OregonStateMarsRover/2011/Software/Interface/UIMockups/VideoFeed/VideoResources/utah1.png

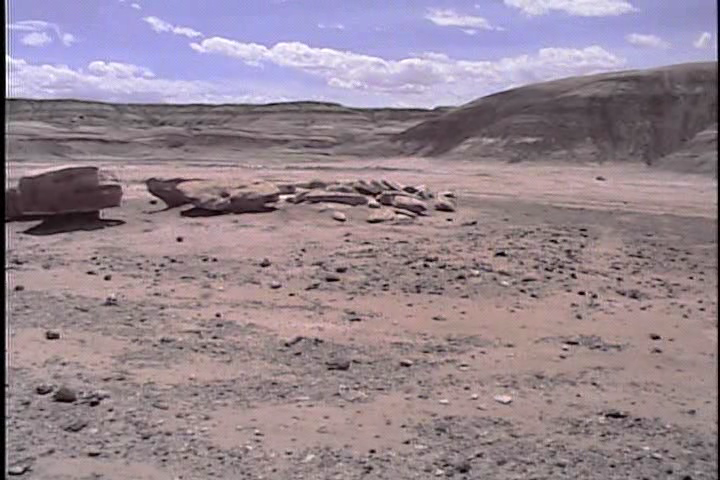
Software/Interface/UIMockups/VideoFeed/VideoResources/utah1.png
