OregonStateMarsRover/2011/Software/Interface/UIMockups/VideoFeed/VideoResources/utah2.png

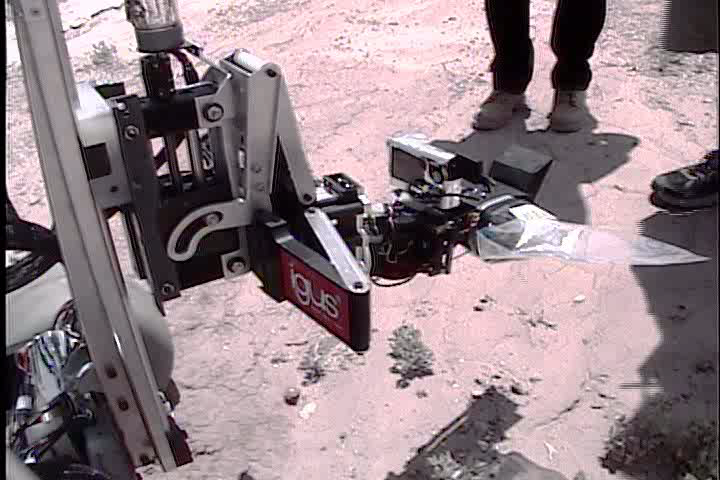
Software/Interface/UIMockups/VideoFeed/VideoResources/utah2.png
