OregonStateMarsRover/2011/README

Say something about I don't know, about robotics, about
