OregonStateMarsRover/2011/Electrical/Changelist.txt

Parts to Update
AOM-6545P-R
ATMEGA65P
BNC_TYCO_5-1634503-3
CAP-0805
CAP-1206
CAP_ALELEC_10
CAP_EPOLYMER_10
DRV135UA
FFC_6200...
HDR_JST_1MM_VERT
IND0805
L7809
LED-0805_DIALIGHT_598-8110-107F
LED-0805_DIALIGHT_598-8150-107F
MCP6241-E/SN
MOSFET_IPD105N04L
PV3ZA
REG104-25
REG104-5
RES-0603
RES-0805
RES-1206
SKY65135-21
SMA-TH-50
TC1121COA
TPS60403
TRIMPOT_PV3ZA
ZLDO1117
