OregonStateMarsRover/2011/Electrical/padsDrawings/R-E-06-01(Tripod_Control_Board)/R-E-06-01_Tripod_Control_Board_Block_Diagram.pdf

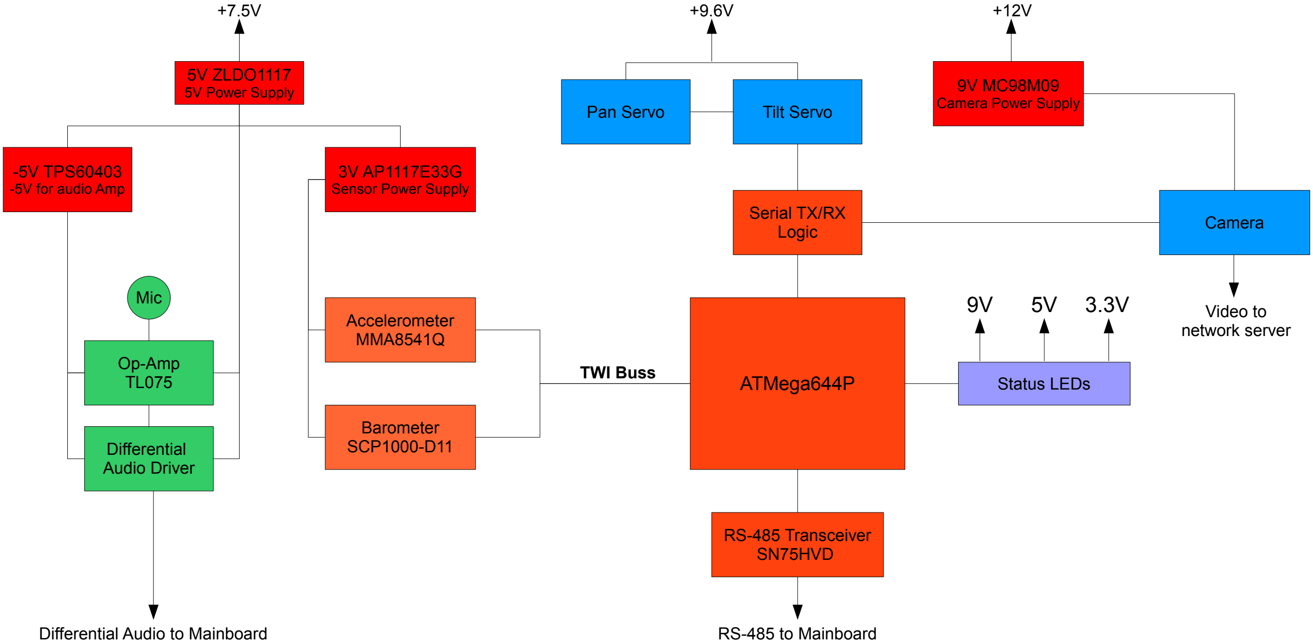
[picture p3: figure]
ATMega644P; 9V MC98M09 Camera Power Supply; 5V ZLDO1117 5V Power Supply; -5V TPS60403 -5V for audio Amp; 3V AP1117E33G Sensor Power Supply; Camera; Op-Amp TL075; Differential Audio Driver; Mic; Accelerometer MMA8541Q; Barometer SCP1000-D11; TWI Buss; Pan Servo; Tilt Servo; Serial TX/RX Logic; Status LEDs; RS-485 Transceiver SN75HVD; Differential Audio to Mainboard; RS-485 to Mainboard; Video to network server
