OregonStateMarsRover/2011/Protocols/Serial Protocol.odt

# Using the Supplied Implementation

An example program is given with a codeblocks project file. Using the serial protocol library is simple, just follow the basic setup used in the main.c file. If multiple interfaces are needed, create an instance of the SerialData structure for each interface. In the example, the transmit function simply passes the data back to the receiving end. In a real example (microcontroller context), the implimentation may resemble the following:

// USART Receive Interrupt

ISR(USART_RX_vect)

{

ProcessDataChar (&ser, UDR0);

}

// USART Transmit Complete Interrupt

ISR(USART_TX_vect)

{

SerialByteTransmitComplete (&ser);

}

Be aware that any assigned function pointers may be called in the context of these interrupts.

# Serial Packet Format

## High level

The user code will see and construct the packet as described below.

Address (one byte)

Length (one byte)

Data (number of bytes in length)

Many pieces of data require more than 8 bits (I.E, are ints and so forth). When breaking up a multi-byte data type for network transmission, it is common practice to do so Most Significant Byte first (MSB first). Breaking up a 32 bit integer would therefore be done as follows:

Data[0] = (value >> 24) & 0xFF;

Data[1] = (value >> 16) & 0xFF;

Data[2] = (value >> 8) & 0xFF;

Data[3] = (value) & 0xFF;

To reconstruct the data back into a 32 bit integer:

Int32 value = (Data[0] << 24) | (Data[1] << 16) | (Data[2] << 8) | Data[3];

Do not do this. This will work with Big Endian processors (AVR32) but not Little Endian processors (8 bit AVR's).

Int32 value = *((Int32*)(&Data[0]));

## Low Level

The actual transmission of the packet will be as described below.

Start Byte

Address, escaped if necessary

Length, escaped if necessary

Data, escaped if necessary

Checksum, escaped if necessary

The checksum is computed as follows:

Checksum = ~(address + length + data[0] + data[1] + … + data[length-1])

Such a checksum computation will be able to detect a single bit error, but multiple bit errors can go unnoticed. The underlying assumption is that bit errors are so rare that over the length of the packet, the chance of two bit errors is negligible.

# Character Escaping

Character escaping (also known as byte stuffing) comes from the need to have one, and only one, start byte in any given data transfer. One solution is to avoid sending a start byte in the data sequence. A better solution is to replace the start byte with an escape character and an escaped version of the start byte before transmitting. I.E, { 0xCA } becomes { '\\', 2 }. In this case, any instance of the escape character '\\' must also be escaped. Additionally, any other characters which should never be transmitted can be escaped. In this case, 0 and 255 are chosen to never be transmitted. The reasoning here is that a transmission error which is not caught by hardware (as a frame error) will most likely result in a 0 or a 255.

Control Characters

START_BYTE 0xCA

ESCAPE_CHAR '\\'

NULL_BYTE 0

MAX_BYTE 255

Control Characters Escaped

START_BYTE_ESCAPED 2

ESCAPE_CHAR_ESCAPED 3

NULL_BYTE_ESCAPED 4

MAX_BYTE_ESCAPED 5
