OregonStateMarsRover/2011/Electrical/padsDrawings/R-E-06-01(Tripod_Control_Board)/R-E-06-01_Tripod_Control_Board_Block_Diagram.png

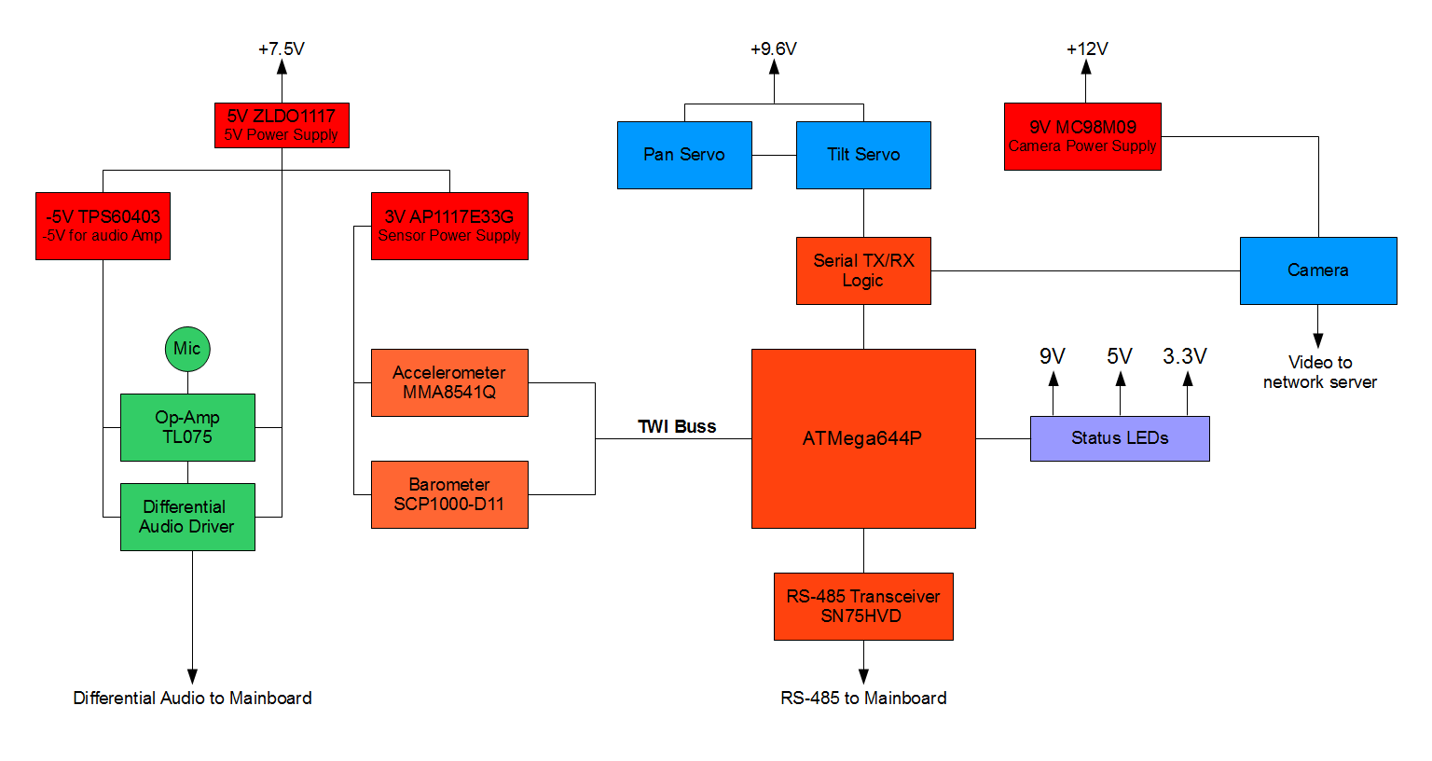
Electrical/padsDrawings/R-E-06-01(Tripod_Control_Board)/R-E-06-01_Tripod_Control_Board_Block_Diagram.png
