OregonStateMarsRover/2011/Electrical/padsDrawings/R-E-04-01(2.4GHz_Amplifier)/BillOfMaterials.rep.txt

Item,Qty,Reference,Part Name
1,1,U10,74LVC2G126DP
2,1,Q1,BC860CW
3,7,C36-38 C41 C44-46,CAP-0402,56pF
4,10,C1-6 C10 C12 C14-15,CAP-0603,0.1uF
5,5,C7-9 C11 C31,CAP-0603,0.47uF
6,6,C32-35 C42-43,CAP-0603,1000pF,5%
7,1,C29,CAP-0603,10uF
8,1,C28,CAP-0603,270pF
9,1,C26,CAP-0603,3.3nF
10,8,C17 C19 C22-25 C27 C30,CAP-0603,8.2pF
11,3,C18 C20-21,CAP-1206,10uF
12,3,C16 C39-40,CAP-1206,4.7uF
13,1,C13,CAP_RAD_5MM,10uF,10%
14,1,U6,CD4081
15,1,J5,HDR_MINIFITJR_2R2P-V
16,1,J4,HDR_SHERLOCK_2P_V
17,1,J3,HDR_SHERLOCK_4P_V
18,1,L1,IND0805,0.1uH
19,4,D3 D6-8,LED-0805_DIALIGHT_598-8150-107F
20,2,D1 D4,LED-0805_DIALIGHT_598-8170-107F
21,2,D5 D9,LED-0805_DIALIGHT_598-8191-107F
22,1,U5,MIC5203
23,5,X1-5,PHOLE-#4
24,1,U4,REG104-5
25,1,U2,REG104-25
26,1,U3,REG104-33
27,1,R46,RES-0402,23.01
28,2,R1 R3,RES-0402,58.63
29,2,R2 R55,RES-0402,OPT
30,1,R40,RES-0603,0
31,1,R18,RES-0603,1.6K
32,2,R11 R43,RES-0603,100
33,6,R9 R21 R48-51,RES-0603,10K
34,1,R10,RES-0603,1M
35,1,R42,RES-0603,260
36,3,R24 R44-45,RES-0603,2K
37,1,R27,RES-0603,320
38,3,R19-20 R22,RES-0603,4.7K
39,1,R7,RES-0603,500K
40,1,R41,RES-0603,51
41,1,R26,RES-0603,600
42,1,R8,RES-0603,7K
43,3,R5-6 R25,RES-0603,OPT
44,11,R4 R23 R32-39 R47,RES-0603,OPT-0
45,2,R12 R17,RES-0603,OPT-1K
46,1,R29,RES-0603,OPT-200
47,1,R30,RES-0603,OPT-270
48,1,R31,RES-0603,OPT-300
49,4,R13-16,RES-0603,OPT-4.7K
50,1,R28,RES-0603,OPT-750
51,1,U1,SKY65135-21
52,3,J1-2 J6,SMA-TH-50
53,1,U8,TL071IDR
54,1,U7,TLV3702
55,7,T1-7,TPNT
56,3,U9 U11 U13,UPG2155TB
57,1,D2,ZENER_BZX84-B8V2,8.2V
