OregonStateMarsRover/2011/Electrical/padsDrawings/R-E-05-01(Main_Board)/Rev. 2/BOM_R-E-05-01_02.xls

Reference | Item | Part Name | Value | Qty | Description | Supplier Link | Unit Cost | Total Cost | Actual Unit Cost | Actual Total
Y200 | 1 | ABL-16.000MHZ-B2,16.000MHz | 16.000MHz | 1 | XTAL, THT, 16.000MHz | https://www.mouser.com/Search/ProductDetail.aspx | $0.39 | $134.79 | $0.39 | $45.52
Y300 | 2 | ABL-16.000MHZ-B2,16.000MHz | 16.000MHz | 1 | XTAL, THT, 16.000MHz | https://www.mouser.com/Search/ProductDetail.aspx | $0.39 |  | $0.39
U300 | 3 | ATXMEGA256A3 |  | 1 | MCU, 8/16b,AVR, ATXMega256A3AU | http://www.mouser.com/ProductDetail/Atmel/ATXMEGA256A3-AU/?qs=iKytVS9glga4b%252bFQlY1sptd856FsMMeE | $10.50 |  | $0.00
U200 | 4 | ATXMEGA256A3 |  | 1 | MCU, 8/16b,AVR, ATXMega256A3AU | http://www.mouser.com/ProductDetail/Atmel/ATXMEGA256A3-AU/?qs=iKytVS9glga4b%252bFQlY1sptd856FsMMeE | $10.50 |  | $0.00
FB300 | 5 | BLM18TG221TNB |  | 1 | Ferrite Bead, 220 Ohm at 100MHz, 0603 | https://www.mouser.com/Search/ProductDetail.aspx | $0.05 |  | $0.05
C201 | 6 | CAP-0603,0.1uF | 0.1uF | 1 | Capacitor, SMT, 0603 | https://www.mouser.com/Search/ProductDetail.aspx | $0.02 |  | $0.02
C202 | 7 | CAP-0603,0.1uF | 0.1uF | 1 | Capacitor, SMT, 0603 | https://www.mouser.com/Search/ProductDetail.aspx | $0.02 |  | $0.02
C203 | 8 | CAP-0603,0.1uF | 0.1uF | 1 | Capacitor, SMT, 0603 | https://www.mouser.com/Search/ProductDetail.aspx | $0.02 |  | $0.02
C204 | 9 | CAP-0603,0.1uF | 0.1uF | 1 | Capacitor, SMT, 0603 | https://www.mouser.com/Search/ProductDetail.aspx | $0.02 |  | $0.02
C205 | 10 | CAP-0603,0.1uF | 0.1uF | 1 | Capacitor, SMT, 0603 | https://www.mouser.com/Search/ProductDetail.aspx | $0.02 |  | $0.02
C207 | 11 | CAP-0603,0.1uF | 0.1uF | 1 | Capacitor, SMT, 0603 | https://www.mouser.com/Search/ProductDetail.aspx | $0.02 |  | $0.02
C208 | 12 | CAP-0603,0.1uF | 0.1uF | 1 | Capacitor, SMT, 0603 | https://www.mouser.com/Search/ProductDetail.aspx | $0.02 |  | $0.02
C301 | 13 | CAP-0603,0.1uF | 0.1uF | 1 | Capacitor, SMT, 0603 | https://www.mouser.com/Search/ProductDetail.aspx | $0.02 |  | $0.02
C302 | 14 | CAP-0603,0.1uF | 0.1uF | 1 | Capacitor, SMT, 0603 | https://www.mouser.com/Search/ProductDetail.aspx | $0.02 |  | $0.02
C303 | 15 | CAP-0603,0.1uF | 0.1uF | 1 | Capacitor, SMT, 0603 | https://www.mouser.com/Search/ProductDetail.aspx | $0.02 |  | $0.02
C304 | 16 | CAP-0603,0.1uF | 0.1uF | 1 | Capacitor, SMT, 0603 | https://www.mouser.com/Search/ProductDetail.aspx | $0.02 |  | $0.02
C305 | 17 | CAP-0603,0.1uF | 0.1uF | 1 | Capacitor, SMT, 0603 | https://www.mouser.com/Search/ProductDetail.aspx | $0.02 |  | $0.02
C306 | 18 | CAP-0603,0.1uF | 0.1uF | 1 | Capacitor, SMT, 0603 | https://www.mouser.com/Search/ProductDetail.aspx | $0.02 |  | $0.02
C308 | 19 | CAP-0603,0.1uF | 0.1uF | 1 | Capacitor, SMT, 0603 | https://www.mouser.com/Search/ProductDetail.aspx | $0.02 |  | $0.02
C313 | 20 | CAP-0603,0.1uF | 0.1uF | 1 | Capacitor, SMT, 0603 | https://www.mouser.com/Search/ProductDetail.aspx | $0.02 |  | $0.02
C315 | 21 | CAP-0603,0.1uF | 0.1uF | 1 | Capacitor, SMT, 0603 | https://www.mouser.com/Search/ProductDetail.aspx | $0.02 |  | $0.02
C316 | 22 | CAP-0603,0.1uF | 0.1uF | 1 | Capacitor, SMT, 0603 | https://www.mouser.com/Search/ProductDetail.aspx | $0.02 |  | $0.02
C400 | 23 | CAP-0603,0.1uF | 0.1uF | 1 | Capacitor, SMT, 0603 | https://www.mouser.com/Search/ProductDetail.aspx | $0.02 |  | $0.02
C401 | 24 | CAP-0603,0.1uF | 0.1uF | 1 | Capacitor, SMT, 0603 | https://www.mouser.com/Search/ProductDetail.aspx | $0.02 |  | $0.02
C402 | 25 | CAP-0603,0.1uF | 0.1uF | 1 | Capacitor, SMT, 0603 | https://www.mouser.com/Search/ProductDetail.aspx | $0.02 |  | $0.02
C403 | 26 | CAP-0603,0.1uF | 0.1uF | 1 | Capacitor, SMT, 0603 | https://www.mouser.com/Search/ProductDetail.aspx | $0.02 |  | $0.02
C404 | 27 | CAP-0603,0.1uF | 0.1uF | 1 | Capacitor, SMT, 0603 | https://www.mouser.com/Search/ProductDetail.aspx | $0.02 |  | $0.02
C405 | 28 | CAP-0603,0.1uF | 0.1uF | 1 | Capacitor, SMT, 0603 | https://www.mouser.com/Search/ProductDetail.aspx | $0.02 |  | $0.02
C406 | 29 | CAP-0603,0.1uF | 0.1uF | 1 | Capacitor, SMT, 0603 | https://www.mouser.com/Search/ProductDetail.aspx | $0.02 |  | $0.02
C701 | 30 | CAP-0603,0.1uF | 0.1uF | 1 | Capacitor, SMT, 0603 | https://www.mouser.com/Search/ProductDetail.aspx | $0.02 |  | $0.02
C710 | 31 | CAP-0603,0.1uF | 0.1uF | 1 | Capacitor, SMT, 0603 | https://www.mouser.com/Search/ProductDetail.aspx | $0.02 |  | $0.02
C102 | 32 | CAP-0603,10nF | 10nF | 1 | Capacitor, SMT, 0603 | https://www.mouser.com/Search/ProductDetail.aspx | $0.03 |  | $0.03
C106 | 33 | CAP-0603,10nF | 10nF | 1 | Capacitor, SMT, 0603 | https://www.mouser.com/Search/ProductDetail.aspx | $0.03 |  | $0.03
C110 | 34 | CAP-0603,10nF | 10nF | 1 | Capacitor, SMT, 0603 | https://www.mouser.com/Search/ProductDetail.aspx | $0.03 |  | $0.03
C700 | 35 | CAP-0603,10nF | 10nF | 1 | Capacitor, SMT, 0603 | https://www.mouser.com/Search/ProductDetail.aspx | $0.03 |  | $0.03
C307 | 36 | CAP-0603,10uF | 10uF | 1 | Capacitor, SMT, 0603 | https://www.mouser.com/Search/ProductDetail.aspx | $0.37 |  | $0.37
C209 | 37 | CAP-0603,18pF | 18pF | 1 | Capacitor, SMT, 0603 | https://www.mouser.com/Search/ProductDetail.aspx | $0.02 |  | $0.02
C210 | 38 | CAP-0603,18pF | 18pF | 1 | Capacitor, SMT, 0603 | https://www.mouser.com/Search/ProductDetail.aspx | $0.02 |  | $0.02
C317 | 39 | CAP-0603,18pF | 18pF | 1 | Capacitor, SMT, 0603 | https://www.mouser.com/Search/ProductDetail.aspx | $0.02 |  | $0.02
C318 | 40 | CAP-0603,18pF | 18pF | 1 | Capacitor, SMT, 0603 | https://www.mouser.com/Search/ProductDetail.aspx | $0.02 |  | $0.02
C107 | 41 | CAP-0603,1nF | 1nF | 1 | Capacitor, SMT, 0603 | https://www.mouser.com/Search/ProductDetail.aspx | $0.03 |  | $0.03
C310 | 42 | CAP-0603,1uF | 1uF | 1 | Capacitor, SMT, 0603 | https://www.mouser.com/Search/ProductDetail.aspx | $0.04 |  | $0.04
C311 | 43 | CAP-0603,1uF | 1uF | 1 | Capacitor, SMT, 0603 | https://www.mouser.com/Search/ProductDetail.aspx | $0.04 |  | $0.04
C312 | 44 | CAP-0603,1uF | 1uF | 1 | Capacitor, SMT, 0603 | https://www.mouser.com/Search/ProductDetail.aspx | $0.04 |  | $0.04
C707 | 45 | CAP-0603,1uF | 1uF | 1 | Capacitor, SMT, 0603 | https://www.mouser.com/Search/ProductDetail.aspx | $0.04 |  | $0.04
C708 | 46 | CAP-0603,1uF | 1uF | 1 | Capacitor, SMT, 0603 | https://www.mouser.com/Search/ProductDetail.aspx | $0.04 |  | $0.04
C709 | 47 | CAP-0603,1uF | 1uF | 1 | Capacitor, SMT, 0603 | https://www.mouser.com/Search/ProductDetail.aspx | $0.04 |  | $0.04
C104 | 48 | CAP-0603,30pF | 30pF | 1 | Capacitor, SMT, 0603 | https://www.mouser.com/Search/ProductDetail.aspx | $0.04 |  | $0.04
C105 | 49 | CAP-0603,39nF | 39nF | 1 | Capacitor, SMT, 0603 | https://www.mouser.com/Search/ProductDetail.aspx | $0.04 |  | $0.04
C703 | 50 | CAP-0603,4.7uF | 4.7uF | 1 | Capacitor, SMT, 0603 | https://www.mouser.com/Search/ProductDetail.aspx | $0.17 |  | $0.17
C704 | 51 | CAP-0603,4.7uF | 4.7uF | 1 | Capacitor, SMT, 0603 | https://www.mouser.com/Search/ProductDetail.aspx | $0.17 |  | $0.17
C309 | 52 | CAP-0603,470pF | 470pF | 1 | Capacitor, SMT, 0603 | https://www.mouser.com/Search/ProductDetail.aspx | $0.03 |  | $0.03
C200 | 53 | CAP-0805,10uF | 10uF | 1 | SURFACE MOUNT CAPACITOR 0.048 X 0.079 INCHES | https://www.mouser.com/Search/ProductDetail.aspx | $0.14 |  | $0.14
C300 | 54 | CAP-0805,10uF | 10uF | 1 | SURFACE MOUNT CAPACITOR 0.048 X 0.079 INCHES | https://www.mouser.com/Search/ProductDetail.aspx | $0.14 |  | $0.14
C702 | 55 | CAP-0805,10uF | 10uF | 1 | SURFACE MOUNT CAPACITOR 0.048 X 0.079 INCHES | https://www.mouser.com/Search/ProductDetail.aspx | $0.14 |  | $0.14
C705 | 56 | CAP-0805,10uF | 10uF | 1 | SURFACE MOUNT CAPACITOR 0.048 X 0.079 INCHES | https://www.mouser.com/Search/ProductDetail.aspx | $0.14 |  | $0.14
C706 | 57 | CAP-0805,1uF | 1uF | 1 | SURFACE MOUNT CAPACITOR 0.048 X 0.079 INCHES | https://www.mouser.com/Search/ProductDetail.aspx | $0.05 |  | $0.05
C314 | 58 | CAP-0805,4.7uF | 4.7uF | 1 | SURFACE MOUNT CAPACITOR 0.048 X 0.079 INCHES | https://www.mouser.com/Search/ProductDetail.aspx | $0.05 |  | $0.05
C103 | 59 | CAP-1206,10uF | 10uF | 1 | SURFACE MOUNT CAPACITOR 0.062 X 0.126 INCHES | https://www.mouser.com/Search/ProductDetail.aspx | $0.24 |  | $0.24
C108 | 60 | CAP-1206,10uF | 10uF | 1 | SURFACE MOUNT CAPACITOR 0.062 X 0.126 INCHES | https://www.mouser.com/Search/ProductDetail.aspx | $0.24 |  | $0.24
C113 | 61 | CAP-1206,10uF | 10uF | 1 | SURFACE MOUNT CAPACITOR 0.062 X 0.126 INCHES | https://www.mouser.com/Search/ProductDetail.aspx | $0.24 |  | $0.24
C109 | 62 | CAP-1206,1uF | 1uF | 1 | SURFACE MOUNT CAPACITOR 0.062 X 0.126 INCHES | https://www.mouser.com/Search/ProductDetail.aspx | $0.06 |  | $0.06
C112 | 63 | CAP-1206,4.7uF | 4.7uF | 1 | SURFACE MOUNT CAPACITOR 0.062 X 0.126 INCHES | https://www.mouser.com/Search/ProductDetail.aspx | $0.17 |  | $0.17
C100 | 64 | CAP-RADIAL-10X12.5_3MMP,470uF | 330uF | 1 | Radial Electrolytic Capacitor, 10x12.5x3mm (DxHxP) | https://www.mouser.com/Search/ProductDetail.aspx | $0.85 |  | $0.85
C101 | 65 | CAP-RADIAL-10X12.5_3MMP,470uF | 330uF | 1 | Radial Electrolytic Capacitor, 10x12.5x3mm (DxHxP) | https://www.mouser.com/Search/ProductDetail.aspx | $0.85 |  | $0.85
C111 | 66 | CAP-RADIAL-8.5X11_3MMP,180uF | 330uF | 1 | Radial Electrolytic Capacitor, 8.5x11x3mm (DxHxP) | https://www.mouser.com/Search/ProductDetail.aspx | $0.86 |  | $0.86
Q600 | 67 | FDC6322C_Q |  | 1 | Dual NMOS/PMOS, 0.22A/0.46A, SSOT-6 | https://www.mouser.com/Search/ProductDetail.aspx | $0.21 |  | $0.21
X300 | 68 | GPS15X-W |  | 1 | Garmin GPS15x WAAS-GPS Receiver Module, 1mm JST Connector |  | $43.50 |  | $0.00
J303 | 69 | HDR_2P1R_100MIL |  | 1 | Standard 2 Pin 1 Row .100" Header |  | $0.00 |  | $0.00
J304 | 70 | HDR_2P1R_100MIL |  | 1 | Standard 2 Pin 1 Row .100" Header |  | $0.00 |  | $0.00
J500 | 71 | HDR_MINIFIT_2R4P_V |  | 1 | Header, 4 Pin 2 Row Minifit 4.2mm Pitch, Vertical | http://www.mouser.com/ProductDetail/Tyco-Electronics-AMP/1586037-4/ | $0.50 |  | $0.50
J200 | 72 | HDR_PDI_6 |  | 1 | Header, 6P 2 Row, Through Hole, Shroded, 100x100mil, for ISP-6 Programming | https://www.mouser.com/Search/ProductDetail.aspx | $0.38 |  | $0.38
J300 | 73 | HDR_PDI_6 |  | 1 | Header, 6P 2 Row, Through Hole, Shroded, 100x100mil, for ISP-6 Programming | https://www.mouser.com/Search/ProductDetail.aspx | $0.38 |  | $0.38
J513 | 74 | HDR_SHERLOCK_2P_V |  | 1 | Sherlock Header, 2P, Vertical | https://www.mouser.com/Search/ProductDetail.aspx | $0.28 |  | $0.28
J502 | 75 | HDR_SHERLOCK_3P_V |  | 1 | Molex Sherlock 2.0mm Header-3P Vertical | https://www.mouser.com/Search/ProductDetail.aspx | $0.47 |  | $0.47
J503 | 76 | HDR_SHERLOCK_3P_V |  | 1 | Molex Sherlock 2.0mm Header-3P Vertical | https://www.mouser.com/Search/ProductDetail.aspx | $0.47 |  | $0.47
J504 | 77 | HDR_SHERLOCK_3P_V |  | 1 | Molex Sherlock 2.0mm Header-3P Vertical | https://www.mouser.com/Search/ProductDetail.aspx | $0.47 |  | $0.47
J505 | 78 | HDR_SHERLOCK_3P_V |  | 1 | Molex Sherlock 2.0mm Header-3P Vertical | https://www.mouser.com/Search/ProductDetail.aspx | $0.47 |  | $0.47
J506 | 79 | HDR_SHERLOCK_3P_V |  | 1 | Molex Sherlock 2.0mm Header-3P Vertical | https://www.mouser.com/Search/ProductDetail.aspx | $0.47 |  | $0.47
J507 | 80 | HDR_SHERLOCK_3P_V |  | 1 | Molex Sherlock 2.0mm Header-3P Vertical | https://www.mouser.com/Search/ProductDetail.aspx | $0.47 |  | $0.47
J508 | 81 | HDR_SHERLOCK_3P_V |  | 1 | Molex Sherlock 2.0mm Header-3P Vertical | https://www.mouser.com/Search/ProductDetail.aspx | $0.47 |  | $0.47
J510 | 82 | HDR_SHERLOCK_4P_V |  | 1 | Molex Sherlock 2.0mm Header-4P Vertical | https://www.mouser.com/Search/ProductDetail.aspx | $0.47 |  | $0.47
J511 | 83 | HDR_SHERLOCK_4P_V |  | 1 | Molex Sherlock 2.0mm Header-4P Vertical | https://www.mouser.com/Search/ProductDetail.aspx | $0.47 |  | $0.47
J512 | 84 | HDR_SHERLOCK_4P_V |  | 1 | Molex Sherlock 2.0mm Header-4P Vertical | https://www.mouser.com/Search/ProductDetail.aspx | $0.47 |  | $0.47
J514 | 85 | HDR_SHERLOCK_4P_V |  | 1 | Molex Sherlock 2.0mm Header-4P Vertical | https://www.mouser.com/Search/ProductDetail.aspx | $0.47 |  | $0.47
J515 | 86 | HDR_SHERLOCK_4P_V |  | 1 | Molex Sherlock 2.0mm Header-4P Vertical | https://www.mouser.com/Search/ProductDetail.aspx | $0.47 |  | $0.47
J501 | 87 | HDR_SHERLOCK_5P_V |  | 1 | Molex Sherlock 2.0mm Header-5P Vertical | https://www.mouser.com/Search/ProductDetail.aspx | $0.58 |  | $0.58
J302 | 88 | HDR_SHERLOCK_6P_V |  | 1 | Header, Molex Sherlock, 2.0mm, 6 Pin, Vertical | https://www.mouser.com/Search/ProductDetail.aspx | $0.75 |  | $0.75
L200 | 89 | IND0805,10uH | 10uH | 1 | Inductor, SMT, 0805 | https://www.mouser.com/Search/ProductDetail.aspx | $0.36 |  | $0.36
L300 | 90 | IND0805,10uH | 10uH | 1 | Inductor, SMT, 0805 | https://www.mouser.com/Search/ProductDetail.aspx | $0.36 |  | $0.36
L100 | 91 | IND_THT_12RS223C,22uH | 22uH | 1 | Inductor, THT, Ferrite Core Power, Shielded, 10.5mm diameter | https://www.mouser.com/Search/ProductDetail.aspx?R=12RS223Cvirtualkey58010000virtualkey580-12RS223C | $0.85 |  | $0.85
D600 | 92 | LED-0805_DIALIGHT_598-8110-107F |  | 1 | LED, 0805, Red | https://www.mouser.com/Search/ProductDetail.aspx | $0.08 |  | $0.08
D602 | 93 | LED-0805_DIALIGHT_598-8110-107F |  | 1 | LED, 0805, Red | https://www.mouser.com/Search/ProductDetail.aspx | $0.08 |  | $0.08
D612 | 94 | LED-0805_DIALIGHT_598-8110-107F |  | 1 | LED, 0805, Red | https://www.mouser.com/Search/ProductDetail.aspx | $0.08 |  | $0.08
D101 | 95 | LED-0805_DIALIGHT_598-8150-107F |  | 1 | LED, 0805, Yellow | https://www.mouser.com/Search/ProductDetail.aspx | $0.08 |  | $0.08
D700 | 96 | LED-0805_DIALIGHT_598-8150-107F |  | 1 | LED, 0805, Yellow | https://www.mouser.com/Search/ProductDetail.aspx | $0.08 |  | $0.08
D601 | 97 | LED-0805_DIALIGHT_598-8170-107F |  | 1 | LED, 0805, Green | https://www.mouser.com/Search/ProductDetail.aspx | $0.08 |  | $0.08
D603 | 98 | LED-0805_DIALIGHT_598-8170-107F |  | 1 | LED, 0805, Green | https://www.mouser.com/Search/ProductDetail.aspx | $0.08 |  | $0.08
D604 | 99 | LED-0805_DIALIGHT_598-8170-107F |  | 1 | LED, 0805, Green | https://www.mouser.com/Search/ProductDetail.aspx | $0.08 |  | $0.08
D605 | 100 | LED-0805_DIALIGHT_598-8170-107F |  | 1 | LED, 0805, Green | https://www.mouser.com/Search/ProductDetail.aspx | $0.08 |  | $0.08
D606 | 101 | LED-0805_DIALIGHT_598-8170-107F |  | 1 | LED, 0805, Green | https://www.mouser.com/Search/ProductDetail.aspx | $0.08 |  | $0.08
D607 | 102 | LED-0805_DIALIGHT_598-8170-107F |  | 1 | LED, 0805, Green | https://www.mouser.com/Search/ProductDetail.aspx | $0.08 |  | $0.08
D608 | 103 | LED-0805_DIALIGHT_598-8170-107F |  | 1 | LED, 0805, Green | https://www.mouser.com/Search/ProductDetail.aspx | $0.08 |  | $0.08
D609 | 104 | LED-0805_DIALIGHT_598-8170-107F |  | 1 | LED, 0805, Green | https://www.mouser.com/Search/ProductDetail.aspx | $0.08 |  | $0.08
D610 | 105 | LED-0805_DIALIGHT_598-8170-107F |  | 1 | LED, 0805, Green | https://www.mouser.com/Search/ProductDetail.aspx | $0.08 |  | $0.08
D611 | 106 | LED-0805_DIALIGHT_598-8170-107F |  | 1 | LED, 0805, Green | https://www.mouser.com/Search/ProductDetail.aspx | $0.08 |  | $0.08
D613 | 107 | LED-0805_DIALIGHT_598-8170-107F |  | 1 | LED, 0805, Green | https://www.mouser.com/Search/ProductDetail.aspx | $0.08 |  | $0.08
Z300 | 108 | LM4040D30DBZR,3.0V | 3.0V | 1 | Precision 3.0V Shunt Reference | https://www.mouser.com/Search/ProductDetail.aspx | $0.78 |  | $0.78
U302 | 109 | LMV321AS5X_Q |  | 1 | Op Amp, 1ch, General Purpose | https://www.mouser.com/Search/ProductDetail.aspx | $0.21 |  | $0.21
U303 | 110 | MMA8451Q |  | 1 | Accelerometer, 3-axis, SPI/I2C, QFN-COL 16 | https://www.mouser.com/Search/ProductDetail.aspx | $6.93 |  | $6.93
U100 | 111 | NCP3125 |  | 1 | 4 A Synchronous PWM Switching Converter | https://www.mouser.com/Search/ProductDetail.aspx | $0.80 |  | $0.80
U700 | 112 | TL072 |  | 1 | Low Noise Dual Op-Amp, SOIC-8 | https://www.mouser.com/Search/ProductDetail.aspx?R=TL072IDvirtualkey51120000virtualkey511-TL072ID | $0.67 |  | $0.67
J509 | 117 | PHONE_JACK_161-352N-EX |  | 1 | Phone Jack, Vertical, Mono, Break Switch | https://www.mouser.com/Search/ProductDetail.aspx | $1.39 |  | $1.39
R708 | 118 | POT_3319P-3-203,20k | 20k | 1 | Linear Trimmer Potentiometer, 9mm, Vertical | https://www.mouser.com/Search/ProductDetail.aspx | $0.23 |  | $0.23
R100 | 119 | RES-0603,0 | 0 | 1 | SURFACE MOUNT RESISTOR 0.031 X 0.061 INCHES, 1/10W | https://www.mouser.com/Search/ProductDetail.aspx | $0.01 |  | $0.01
R310 | 120 | RES-0603,0 | 0 | 1 | SURFACE MOUNT RESISTOR 0.031 X 0.061 INCHES, 1/10W | https://www.mouser.com/Search/ProductDetail.aspx | $0.01 |  | $0.01
R311 | 121 | RES-0603,0 | 0 | 1 | SURFACE MOUNT RESISTOR 0.031 X 0.061 INCHES, 1/10W | https://www.mouser.com/Search/ProductDetail.aspx | $0.01 |  | $0.01
R711 | 122 | RES-0603,0 | 0 | 1 | SURFACE MOUNT RESISTOR 0.031 X 0.061 INCHES, 1/10W | https://www.mouser.com/Search/ProductDetail.aspx | $0.01 |  | $0.01
R103 | 123 | RES-0603,10 | 10 | 1 | SURFACE MOUNT RESISTOR 0.031 X 0.061 INCHES, 1/10W | https://www.mouser.com/Search/ProductDetail.aspx | $0.02 |  | $0.02
R404 | 124 | RES-0603,100 | 100 | 1 | SURFACE MOUNT RESISTOR 0.031 X 0.061 INCHES, 1/10W | https://www.mouser.com/Search/ProductDetail.aspx | $0.02 |  | $0.02
R405 | 125 | RES-0603,100 | 100 | 1 | SURFACE MOUNT RESISTOR 0.031 X 0.061 INCHES, 1/10W | https://www.mouser.com/Search/ProductDetail.aspx | $0.02 |  | $0.02
R407 | 126 | RES-0603,100 | 100 | 1 | SURFACE MOUNT RESISTOR 0.031 X 0.061 INCHES, 1/10W | https://www.mouser.com/Search/ProductDetail.aspx | $0.02 |  | $0.02
R410 | 127 | RES-0603,100 | 100 | 1 | SURFACE MOUNT RESISTOR 0.031 X 0.061 INCHES, 1/10W | https://www.mouser.com/Search/ProductDetail.aspx | $0.02 |  | $0.02
R414 | 128 | RES-0603,100 | 100 | 1 | SURFACE MOUNT RESISTOR 0.031 X 0.061 INCHES, 1/10W | https://www.mouser.com/Search/ProductDetail.aspx | $0.02 |  | $0.02
R417 | 129 | RES-0603,100 | 100 | 1 | SURFACE MOUNT RESISTOR 0.031 X 0.061 INCHES, 1/10W | https://www.mouser.com/Search/ProductDetail.aspx | $0.02 |  | $0.02
R420 | 130 | RES-0603,100 | 100 | 1 | SURFACE MOUNT RESISTOR 0.031 X 0.061 INCHES, 1/10W | https://www.mouser.com/Search/ProductDetail.aspx | $0.02 |  | $0.02
R423 | 131 | RES-0603,100 | 100 | 1 | SURFACE MOUNT RESISTOR 0.031 X 0.061 INCHES, 1/10W | https://www.mouser.com/Search/ProductDetail.aspx | $0.02 |  | $0.02
R101 | 132 | RES-0603,10k | 10k | 1 | SURFACE MOUNT RESISTOR 0.031 X 0.061 INCHES, 1/10W | https://www.mouser.com/Search/ProductDetail.aspx?R=302-10K-RCvirtualkey21980000virtualkey302-10K-RC | $0.02 |  | $0.02
R200 | 133 | RES-0603,10k | 10k | 1 | SURFACE MOUNT RESISTOR 0.031 X 0.061 INCHES, 1/10W | https://www.mouser.com/Search/ProductDetail.aspx?R=302-10K-RCvirtualkey21980000virtualkey302-10K-RC | $0.02 |  | $0.02
R300 | 134 | RES-0603,10k | 10k | 1 | SURFACE MOUNT RESISTOR 0.031 X 0.061 INCHES, 1/10W | https://www.mouser.com/Search/ProductDetail.aspx?R=302-10K-RCvirtualkey21980000virtualkey302-10K-RC | $0.02 |  | $0.02
R616 | 135 | RES-0603,10k | 10k | 1 | SURFACE MOUNT RESISTOR 0.031 X 0.061 INCHES, 1/10W | https://www.mouser.com/Search/ProductDetail.aspx?R=302-10K-RCvirtualkey21980000virtualkey302-10K-RC | $0.02 |  | $0.02
R700 | 136 | RES-0603,12k | 12k | 1 | SURFACE MOUNT RESISTOR 0.031 X 0.061 INCHES, 1/10W | https://www.mouser.com/Search/ProductDetail.aspx | $0.05 |  | $0.05
R701 | 137 | RES-0603,12k | 12k | 1 | SURFACE MOUNT RESISTOR 0.031 X 0.061 INCHES, 1/10W | https://www.mouser.com/Search/ProductDetail.aspx | $0.05 |  | $0.05
R705 | 138 | RES-0603,160k | 160k | 1 | SURFACE MOUNT RESISTOR 0.031 X 0.061 INCHES, 1/10W | https://www.mouser.com/Search/ProductDetail.aspx | $0.03 |  | $0.03
R304 | 139 | RES-0603,16k | 16k | 1 | SURFACE MOUNT RESISTOR 0.031 X 0.061 INCHES, 1/10W | https://www.mouser.com/Search/ProductDetail.aspx | $0.02 |  | $0.02
R306 | 140 | RES-0603,16k | 16k | 1 | SURFACE MOUNT RESISTOR 0.031 X 0.061 INCHES, 1/10W | https://www.mouser.com/Search/ProductDetail.aspx | $0.02 |  | $0.02
R105 | 141 | RES-0603,17.4k | 17.4k | 1 | SURFACE MOUNT RESISTOR 0.031 X 0.061 INCHES, 1/10W | https://www.mouser.com/Search/ProductDetail.aspx | $0.04 |  | $0.04
R301 | 142 | RES-0603,1k | 1k | 1 | SURFACE MOUNT RESISTOR 0.031 X 0.061 INCHES, 1/10W | https://www.mouser.com/Search/ProductDetail.aspx | $0.01 |  | $0.01
R302 | 143 | RES-0603,1k | 1k | 1 | SURFACE MOUNT RESISTOR 0.031 X 0.061 INCHES, 1/10W | https://www.mouser.com/Search/ProductDetail.aspx | $0.01 |  | $0.01
R303 | 144 | RES-0603,1k | 1k | 1 | SURFACE MOUNT RESISTOR 0.031 X 0.061 INCHES, 1/10W | https://www.mouser.com/Search/ProductDetail.aspx | $0.01 |  | $0.01
R305 | 145 | RES-0603,1k | 1k | 1 | SURFACE MOUNT RESISTOR 0.031 X 0.061 INCHES, 1/10W | https://www.mouser.com/Search/ProductDetail.aspx | $0.01 |  | $0.01
R307 | 146 | RES-0603,1k | 1k | 1 | SURFACE MOUNT RESISTOR 0.031 X 0.061 INCHES, 1/10W | https://www.mouser.com/Search/ProductDetail.aspx | $0.01 |  | $0.01
R500 | 147 | RES-0603,1k | 1k | 1 | SURFACE MOUNT RESISTOR 0.031 X 0.061 INCHES, 1/10W | https://www.mouser.com/Search/ProductDetail.aspx | $0.01 |  | $0.01
R501 | 148 | RES-0603,1k | 1k | 1 | SURFACE MOUNT RESISTOR 0.031 X 0.061 INCHES, 1/10W | https://www.mouser.com/Search/ProductDetail.aspx | $0.01 |  | $0.01
R502 | 149 | RES-0603,1k | 1k | 1 | SURFACE MOUNT RESISTOR 0.031 X 0.061 INCHES, 1/10W | https://www.mouser.com/Search/ProductDetail.aspx | $0.01 |  | $0.01
R503 | 150 | RES-0603,1k | 1k | 1 | SURFACE MOUNT RESISTOR 0.031 X 0.061 INCHES, 1/10W | https://www.mouser.com/Search/ProductDetail.aspx | $0.01 |  | $0.01
R504 | 151 | RES-0603,1k | 1k | 1 | SURFACE MOUNT RESISTOR 0.031 X 0.061 INCHES, 1/10W | https://www.mouser.com/Search/ProductDetail.aspx | $0.01 |  | $0.01
R505 | 152 | RES-0603,1k | 1k | 1 | SURFACE MOUNT RESISTOR 0.031 X 0.061 INCHES, 1/10W | https://www.mouser.com/Search/ProductDetail.aspx | $0.01 |  | $0.01
R506 | 153 | RES-0603,1k | 1k | 1 | SURFACE MOUNT RESISTOR 0.031 X 0.061 INCHES, 1/10W | https://www.mouser.com/Search/ProductDetail.aspx | $0.01 |  | $0.01
R507 | 154 | RES-0603,1k | 1k | 1 | SURFACE MOUNT RESISTOR 0.031 X 0.061 INCHES, 1/10W | https://www.mouser.com/Search/ProductDetail.aspx | $0.01 |  | $0.01
R706 | 155 | RES-0603,200 | 200 | 1 | SURFACE MOUNT RESISTOR 0.031 X 0.061 INCHES, 1/10W | https://www.mouser.com/Search/ProductDetail.aspx | $0.02 |  | $0.02
R104 | 156 | RES-0603,27.1k | 27.4k | 1 | SURFACE MOUNT RESISTOR 0.031 X 0.061 INCHES, 1/10W | https://www.mouser.com/Search/ProductDetail.aspx | $0.04 |  | $0.04
R107 | 157 | RES-0603,330 | 330 | 1 | SURFACE MOUNT RESISTOR 0.031 X 0.061 INCHES, 1/10W | https://www.mouser.com/Search/ProductDetail.aspx | $0.02 |  | $0.02
R600 | 158 | RES-0603,390 | 390 | 1 | SURFACE MOUNT RESISTOR 0.031 X 0.061 INCHES, 1/10W | https://www.mouser.com/Search/ProductDetail.aspx | $0.01 |  | $0.01
R601 | 159 | RES-0603,390 | 390 | 1 | SURFACE MOUNT RESISTOR 0.031 X 0.061 INCHES, 1/10W | https://www.mouser.com/Search/ProductDetail.aspx | $0.01 |  | $0.01
R602 | 160 | RES-0603,390 | 390 | 1 | SURFACE MOUNT RESISTOR 0.031 X 0.061 INCHES, 1/10W | https://www.mouser.com/Search/ProductDetail.aspx | $0.01 |  | $0.01
R603 | 161 | RES-0603,390 | 390 | 1 | SURFACE MOUNT RESISTOR 0.031 X 0.061 INCHES, 1/10W | https://www.mouser.com/Search/ProductDetail.aspx | $0.01 |  | $0.01
R604 | 162 | RES-0603,390 | 390 | 1 | SURFACE MOUNT RESISTOR 0.031 X 0.061 INCHES, 1/10W | https://www.mouser.com/Search/ProductDetail.aspx | $0.01 |  | $0.01
R605 | 163 | RES-0603,390 | 390 | 1 | SURFACE MOUNT RESISTOR 0.031 X 0.061 INCHES, 1/10W | https://www.mouser.com/Search/ProductDetail.aspx | $0.01 |  | $0.01
R606 | 164 | RES-0603,390 | 390 | 1 | SURFACE MOUNT RESISTOR 0.031 X 0.061 INCHES, 1/10W | https://www.mouser.com/Search/ProductDetail.aspx | $0.01 |  | $0.01
R607 | 165 | RES-0603,390 | 390 | 1 | SURFACE MOUNT RESISTOR 0.031 X 0.061 INCHES, 1/10W | https://www.mouser.com/Search/ProductDetail.aspx | $0.01 |  | $0.01
R608 | 166 | RES-0603,390 | 390 | 1 | SURFACE MOUNT RESISTOR 0.031 X 0.061 INCHES, 1/10W | https://www.mouser.com/Search/ProductDetail.aspx | $0.01 |  | $0.01
R609 | 167 | RES-0603,390 | 390 | 1 | SURFACE MOUNT RESISTOR 0.031 X 0.061 INCHES, 1/10W | https://www.mouser.com/Search/ProductDetail.aspx | $0.01 |  | $0.01
R610 | 168 | RES-0603,390 | 390 | 1 | SURFACE MOUNT RESISTOR 0.031 X 0.061 INCHES, 1/10W | https://www.mouser.com/Search/ProductDetail.aspx | $0.01 |  | $0.01
R611 | 169 | RES-0603,390 | 390 | 1 | SURFACE MOUNT RESISTOR 0.031 X 0.061 INCHES, 1/10W | https://www.mouser.com/Search/ProductDetail.aspx | $0.01 |  | $0.01
R612 | 170 | RES-0603,390 | 390 | 1 | SURFACE MOUNT RESISTOR 0.031 X 0.061 INCHES, 1/10W | https://www.mouser.com/Search/ProductDetail.aspx | $0.01 |  | $0.01
R613 | 171 | RES-0603,390 | 390 | 1 | SURFACE MOUNT RESISTOR 0.031 X 0.061 INCHES, 1/10W | https://www.mouser.com/Search/ProductDetail.aspx | $0.01 |  | $0.01
R308 | 172 | RES-0603,4.7k | 4.7k | 1 | SURFACE MOUNT RESISTOR 0.031 X 0.061 INCHES, 1/10W | https://www.mouser.com/Search/ProductDetail.aspx | $0.02 |  | $0.02
R309 | 173 | RES-0603,4.7k | 4.7k | 1 | SURFACE MOUNT RESISTOR 0.031 X 0.061 INCHES, 1/10W | https://www.mouser.com/Search/ProductDetail.aspx | $0.02 |  | $0.02
R102 | 174 | RES-0603,6.98k | 6.98k | 1 | SURFACE MOUNT RESISTOR 0.031 X 0.061 INCHES, 1/10W | https://www.mouser.com/Search/ProductDetail.aspx | $0.04 |  | $0.04
R710 | 175 | RES-0603,680 | 680 | 1 | SURFACE MOUNT RESISTOR 0.031 X 0.061 INCHES, 1/10W | https://www.mouser.com/Search/ProductDetail.aspx | $0.03 |  | $0.03
R702 | 176 | RES-0603,6k | 6.04k | 1 | SURFACE MOUNT RESISTOR 0.031 X 0.061 INCHES, 1/10W | https://www.mouser.com/Search/ProductDetail.aspx | $0.04 |  | $0.04
R703 | 177 | RES-0603,6k | 6.04k | 1 | SURFACE MOUNT RESISTOR 0.031 X 0.061 INCHES, 1/10W | https://www.mouser.com/Search/ProductDetail.aspx | $0.04 |  | $0.04
R106 | 178 | RES-0603,8.66k | 8.66k | 1 | SURFACE MOUNT RESISTOR 0.031 X 0.061 INCHES, 1/10W | https://www.mouser.com/Search/ProductDetail.aspx | $0.04 |  | $0.04
R707 | 179 | RES-0603,??? | ??? | 1 | SURFACE MOUNT RESISTOR 0.031 X 0.061 INCHES, 1/10W | 0 | $0.02 |  | $0.02
R400 | 180 | RES-0603,NU | Not Used | 1 | SURFACE MOUNT RESISTOR 0.031 X 0.061 INCHES, 1/10W | 0 | $0.00 |  | $0.00
R401 | 181 | RES-0603,NU | Not Used | 1 | SURFACE MOUNT RESISTOR 0.031 X 0.061 INCHES, 1/10W | 0 | $0.00 |  | $0.00
R402 | 182 | RES-0603,NU | Not Used | 1 | SURFACE MOUNT RESISTOR 0.031 X 0.061 INCHES, 1/10W | 0 | $0.00 |  | $0.00
R403 | 183 | RES-0603,NU | Not Used | 1 | SURFACE MOUNT RESISTOR 0.031 X 0.061 INCHES, 1/10W | 0 | $0.00 |  | $0.00
R406 | 184 | RES-0603,NU | Not Used | 1 | SURFACE MOUNT RESISTOR 0.031 X 0.061 INCHES, 1/10W | 0 | $0.00 |  | $0.00
R408 | 185 | RES-0603,NU | Not Used | 1 | SURFACE MOUNT RESISTOR 0.031 X 0.061 INCHES, 1/10W | 0 | $0.00 |  | $0.00
R409 | 186 | RES-0603,NU | Not Used | 1 | SURFACE MOUNT RESISTOR 0.031 X 0.061 INCHES, 1/10W | 0 | $0.00 |  | $0.00
R411 | 187 | RES-0603,NU | Not Used | 1 | SURFACE MOUNT RESISTOR 0.031 X 0.061 INCHES, 1/10W | 0 | $0.00 |  | $0.00
R412 | 188 | RES-0603,NU | Not Used | 1 | SURFACE MOUNT RESISTOR 0.031 X 0.061 INCHES, 1/10W | 0 | $0.00 |  | $0.00
R415 | 189 | RES-0603,NU | Not Used | 1 | SURFACE MOUNT RESISTOR 0.031 X 0.061 INCHES, 1/10W | 0 | $0.00 |  | $0.00
R416 | 190 | RES-0603,NU | Not Used | 1 | SURFACE MOUNT RESISTOR 0.031 X 0.061 INCHES, 1/10W | 0 | $0.00 |  | $0.00
R418 | 191 | RES-0603,NU | Not Used | 1 | SURFACE MOUNT RESISTOR 0.031 X 0.061 INCHES, 1/10W | 0 | $0.00 |  | $0.00
R419 | 192 | RES-0603,NU | Not Used | 1 | SURFACE MOUNT RESISTOR 0.031 X 0.061 INCHES, 1/10W | 0 | $0.00 |  | $0.00
R421 | 193 | RES-0603,NU | Not Used | 1 | SURFACE MOUNT RESISTOR 0.031 X 0.061 INCHES, 1/10W | 0 | $0.00 |  | $0.00
R422 | 194 | RES-0603,NU | Not Used | 1 | SURFACE MOUNT RESISTOR 0.031 X 0.061 INCHES, 1/10W | 0 | $0.00 |  | $0.00
R424 | 195 | RES-0603,NU | Not Used | 1 | SURFACE MOUNT RESISTOR 0.031 X 0.061 INCHES, 1/10W | 0 | $0.00 |  | $0.00
R614 | 196 | RES-0805,150 | 150 | 1 | SURFACE MOUNT RESISTOR 0.048 X 0.079 INCHES | https://www.mouser.com/Search/ProductDetail.aspx | $0.05 |  | $0.05
R615 | 197 | RES-0805,150 | 150 | 1 | SURFACE MOUNT RESISTOR 0.048 X 0.079 INCHES | https://www.mouser.com/Search/ProductDetail.aspx | $0.05 |  | $0.05
D100 | 198 | SCH_NXP_BAT754A |  | 1 | Dual Schottky Diode, Common Anode | https://www.mouser.com/Search/ProductDetail.aspx | $0.20 |  | $0.20
U401 | 199 | SN65HVD12 |  | 1 | TXR,RS485, Half Duplex | http://www.mouser.com/ProductDetail/Texas-Instruments/SN65HVD12D/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 | $3.58 |  | $0.00
U402 | 200 | SN65HVD12 |  | 1 | TXR,RS485, Half Duplex | http://www.mouser.com/ProductDetail/Texas-Instruments/SN65HVD12D/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 | $3.58 |  | $0.00
U403 | 201 | SN65HVD12 |  | 1 | TXR,RS485, Half Duplex | http://www.mouser.com/ProductDetail/Texas-Instruments/SN65HVD12D/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 | $3.58 |  | $0.00
U404 | 202 | SN65HVD12 |  | 1 | TXR,RS485, Half Duplex | http://www.mouser.com/ProductDetail/Texas-Instruments/SN65HVD12D/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 | $3.58 |  | $0.00
U405 | 203 | SN65HVD12 |  | 1 | TXR,RS485, Half Duplex | http://www.mouser.com/ProductDetail/Texas-Instruments/SN65HVD12D/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 | $3.58 |  | $0.00
U406 | 204 | SN65HVD12 |  | 1 | TXR,RS485, Half Duplex | http://www.mouser.com/ProductDetail/Texas-Instruments/SN65HVD12D/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 | $3.58 |  | $0.00
U400 | 205 | SN65HVD32 |  | 1 | TXR,485 Full Duplex | http://www.mouser.com/ProductDetail/Texas-Instruments/SN65HVD32D/ | $3.29 |  | $0.00
S200 | 206 | SW_SPDT_OS102011 |  | 1 | Slide Switch, SPDT, 0.1A | https://www.mouser.com/Search/ProductDetail.aspx | $0.36 |  | $0.36
S300 | 207 | SW_SPDT_OS102011 |  | 1 | Slide Switch, SPDT, 0.1A | https://www.mouser.com/Search/ProductDetail.aspx | $0.36 |  | $0.36
S201 | 208 | SW_SPST_SWT6-E5M |  | 1 | Tactile Pushbutton, SPST, 6mm | https://www.mouser.com/Search/ProductDetail.aspx?R=SWT6-E5Mvirtualkey57700000virtualkey858-SWT6-E5M | $0.16 |  | $0.16
S301 | 209 | SW_SPST_SWT6-E5M |  | 1 | Tactile Pushbutton, SPST, 6mm | https://www.mouser.com/Search/ProductDetail.aspx?R=SWT6-E5Mvirtualkey57700000virtualkey858-SWT6-E5M | $0.16 |  | $0.16
U301 | 210 | TC72-3.3MUA |  | 1 | Temp. Sensor, SPI, MSOP8 | https://www.mouser.com/Search/ProductDetail.aspx | $1.00 |  | $1.00
U702 | 217 | TPS60403 |  | 1 | Switched Capacitor Inverter | https://www.mouser.com/Search/ProductDetail.aspx | $0.78 |  | $0.78
D400 | 218 | TVS_B72500D200A60V7 |  | 1 | Bidirectional TVS Diode, 2200W, 0603 | https://www.mouser.com/Search/ProductDetail.aspx | $0.08 |  | $0.08
D401 | 219 | TVS_B72500D200A60V7 |  | 1 | Bidirectional TVS Diode, 2200W, 0603 | https://www.mouser.com/Search/ProductDetail.aspx | $0.08 |  | $0.08
D402 | 220 | TVS_B72500D200A60V7 |  | 1 | Bidirectional TVS Diode, 2200W, 0603 | https://www.mouser.com/Search/ProductDetail.aspx | $0.08 |  | $0.08
D403 | 221 | TVS_B72500D200A60V7 |  | 1 | Bidirectional TVS Diode, 2200W, 0603 | https://www.mouser.com/Search/ProductDetail.aspx | $0.08 |  | $0.08
D404 | 222 | TVS_B72500D200A60V7 |  | 1 | Bidirectional TVS Diode, 2200W, 0603 | https://www.mouser.com/Search/ProductDetail.aspx | $0.08 |  | $0.08
D405 | 223 | TVS_B72500D200A60V7 |  | 1 | Bidirectional TVS Diode, 2200W, 0603 | https://www.mouser.com/Search/ProductDetail.aspx | $0.08 |  | $0.08
D406 | 224 | TVS_B72500D200A60V7 |  | 1 | Bidirectional TVS Diode, 2200W, 0603 | https://www.mouser.com/Search/ProductDetail.aspx | $0.08 |  | $0.08
D407 | 225 | TVS_B72500D200A60V7 |  | 1 | Bidirectional TVS Diode, 2200W, 0603 | https://www.mouser.com/Search/ProductDetail.aspx | $0.08 |  | $0.08
D408 | 226 | TVS_B72500D200A60V7 |  | 1 | Bidirectional TVS Diode, 2200W, 0603 | https://www.mouser.com/Search/ProductDetail.aspx | $0.08 |  | $0.08
D409 | 227 | TVS_B72500D200A60V7 |  | 1 | Bidirectional TVS Diode, 2200W, 0603 | https://www.mouser.com/Search/ProductDetail.aspx | $0.08 |  | $0.08
D410 | 228 | TVS_B72500D200A60V7 |  | 1 | Bidirectional TVS Diode, 2200W, 0603 | https://www.mouser.com/Search/ProductDetail.aspx | $0.08 |  | $0.08
D411 | 229 | TVS_B72500D200A60V7 |  | 1 | Bidirectional TVS Diode, 2200W, 0603 | https://www.mouser.com/Search/ProductDetail.aspx | $0.08 |  | $0.08
D412 | 230 | TVS_B72500D200A60V7 |  | 1 | Bidirectional TVS Diode, 2200W, 0603 | https://www.mouser.com/Search/ProductDetail.aspx | $0.08 |  | $0.08
D413 | 231 | TVS_B72500D200A60V7 |  | 1 | Bidirectional TVS Diode, 2200W, 0603 | https://www.mouser.com/Search/ProductDetail.aspx | $0.08 |  | $0.08
D414 | 232 | TVS_B72500D200A60V7 |  | 1 | Bidirectional TVS Diode, 2200W, 0603 | https://www.mouser.com/Search/ProductDetail.aspx | $0.08 |  | $0.08
D415 | 233 | TVS_B72500D200A60V7 |  | 1 | Bidirectional TVS Diode, 2200W, 0603 | https://www.mouser.com/Search/ProductDetail.aspx | $0.08 |  | $0.08
D500 | 234 | TVS_B72500D200A60V7 |  | 1 | Bidirectional TVS Diode, 2200W, 0603 | https://www.mouser.com/Search/ProductDetail.aspx | $0.08 |  | $0.08
D501 | 235 | TVS_B72500D200A60V7 |  | 1 | Bidirectional TVS Diode, 2200W, 0603 | https://www.mouser.com/Search/ProductDetail.aspx | $0.08 |  | $0.08
D502 | 236 | TVS_B72500D200A60V7 |  | 1 | Bidirectional TVS Diode, 2200W, 0603 | https://www.mouser.com/Search/ProductDetail.aspx | $0.08 |  | $0.08
D503 | 237 | TVS_B72500D200A60V7 |  | 1 | Bidirectional TVS Diode, 2200W, 0603 | https://www.mouser.com/Search/ProductDetail.aspx | $0.08 |  | $0.08
D504 | 238 | TVS_B72500D200A60V7 |  | 1 | Bidirectional TVS Diode, 2200W, 0603 | https://www.mouser.com/Search/ProductDetail.aspx | $0.08 |  | $0.08
D505 | 239 | TVS_B72500D200A60V7 |  | 1 | Bidirectional TVS Diode, 2200W, 0603 | https://www.mouser.com/Search/ProductDetail.aspx | $0.08 |  | $0.08
D506 | 240 | TVS_MMBZ15VAL |  | 1 | Dual Common Anode TVS Diodes | https://www.mouser.com/Search/ProductDetail.aspx | $0.04 |  | $0.04
D507 | 241 | TVS_MMBZ15VAL |  | 1 | Dual Common Anode TVS Diodes | https://www.mouser.com/Search/ProductDetail.aspx | $0.04 |  | $0.04
D508 | 242 | TVS_MMBZ15VAL |  | 1 | Dual Common Anode TVS Diodes | https://www.mouser.com/Search/ProductDetail.aspx | $0.04 |  | $0.04
U101 | 243 | ZLDO1117 |  | 1 | LDO, 3.3V, TO-252 | https://www.mouser.com/Search/ProductDetail.aspx | $0.47 |  | $0.47
U701 | 244 | ZLDO1117G50TA |  | 1 | LDO, 5V, SOT-223-3L | https://www.mouser.com/Search/ProductDetail.aspx | $0.55 |  | $0.55
Board Cost |  |  |  | 1 |  |  | $9.00 |  | $9.00
