OregonStateMarsRover/2011/Electrical/padsDrawings/R-E-04-01(2.4GHz_Amplifier)/Solidworks/R-E-04-01_01.SLDPRT

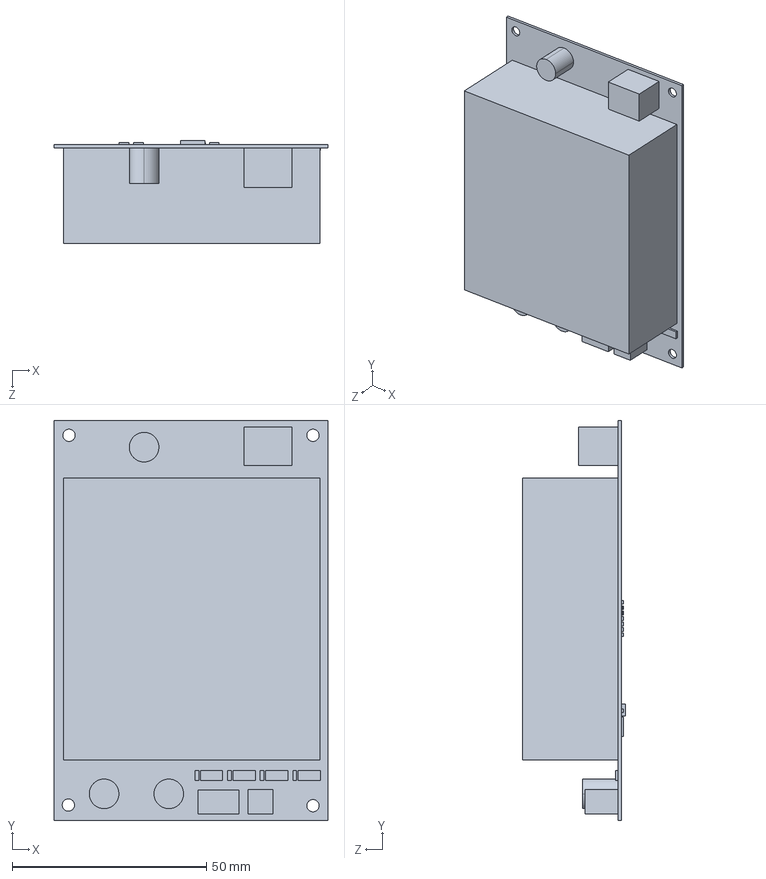
[picture p5: CAD file, 2011-11-01]
Electrical/padsDrawings/R-E-04-01(2.4GHz_Amplifier)/Solidworks/R-E-04-01_01.SLDPRT
70.4 x 102.9 x 26.5 mm
