OregonStateMarsRover/2011/Electrical/padsDrawings/R-E-04-02(DNT900_Interface)/Solidworks/R-E-04-02.SLDPRT

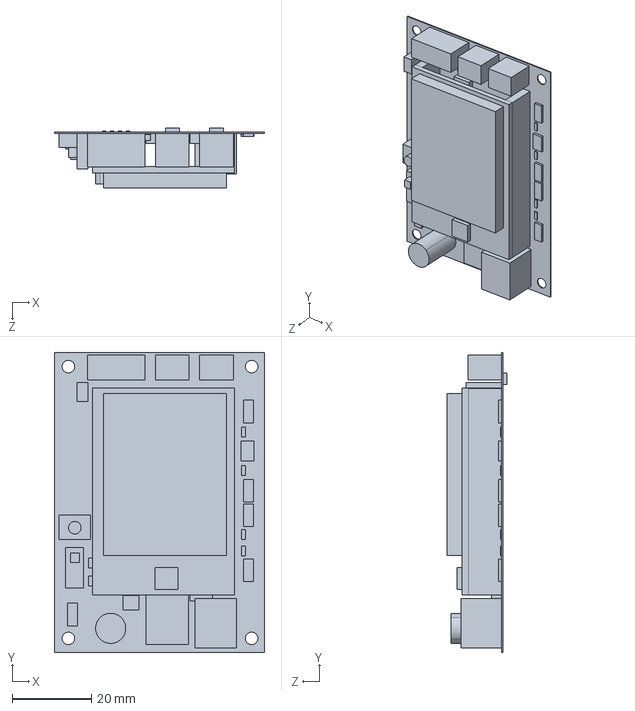
[picture p6: CAD file, 2011-11-01]
Electrical/padsDrawings/R-E-04-02(DNT900_Interface)/Solidworks/R-E-04-02.SLDPRT
53.1 x 75.7 x 15.2 mm
