OregonStateMarsRover/2011/Electrical/padsDrawings/T-E-01-01(Test_Fixture_Control_Board)/Rev1/T-E-01-01_REV1.pdf

D

6 | 5 | 4 | 3 | 2 | 1

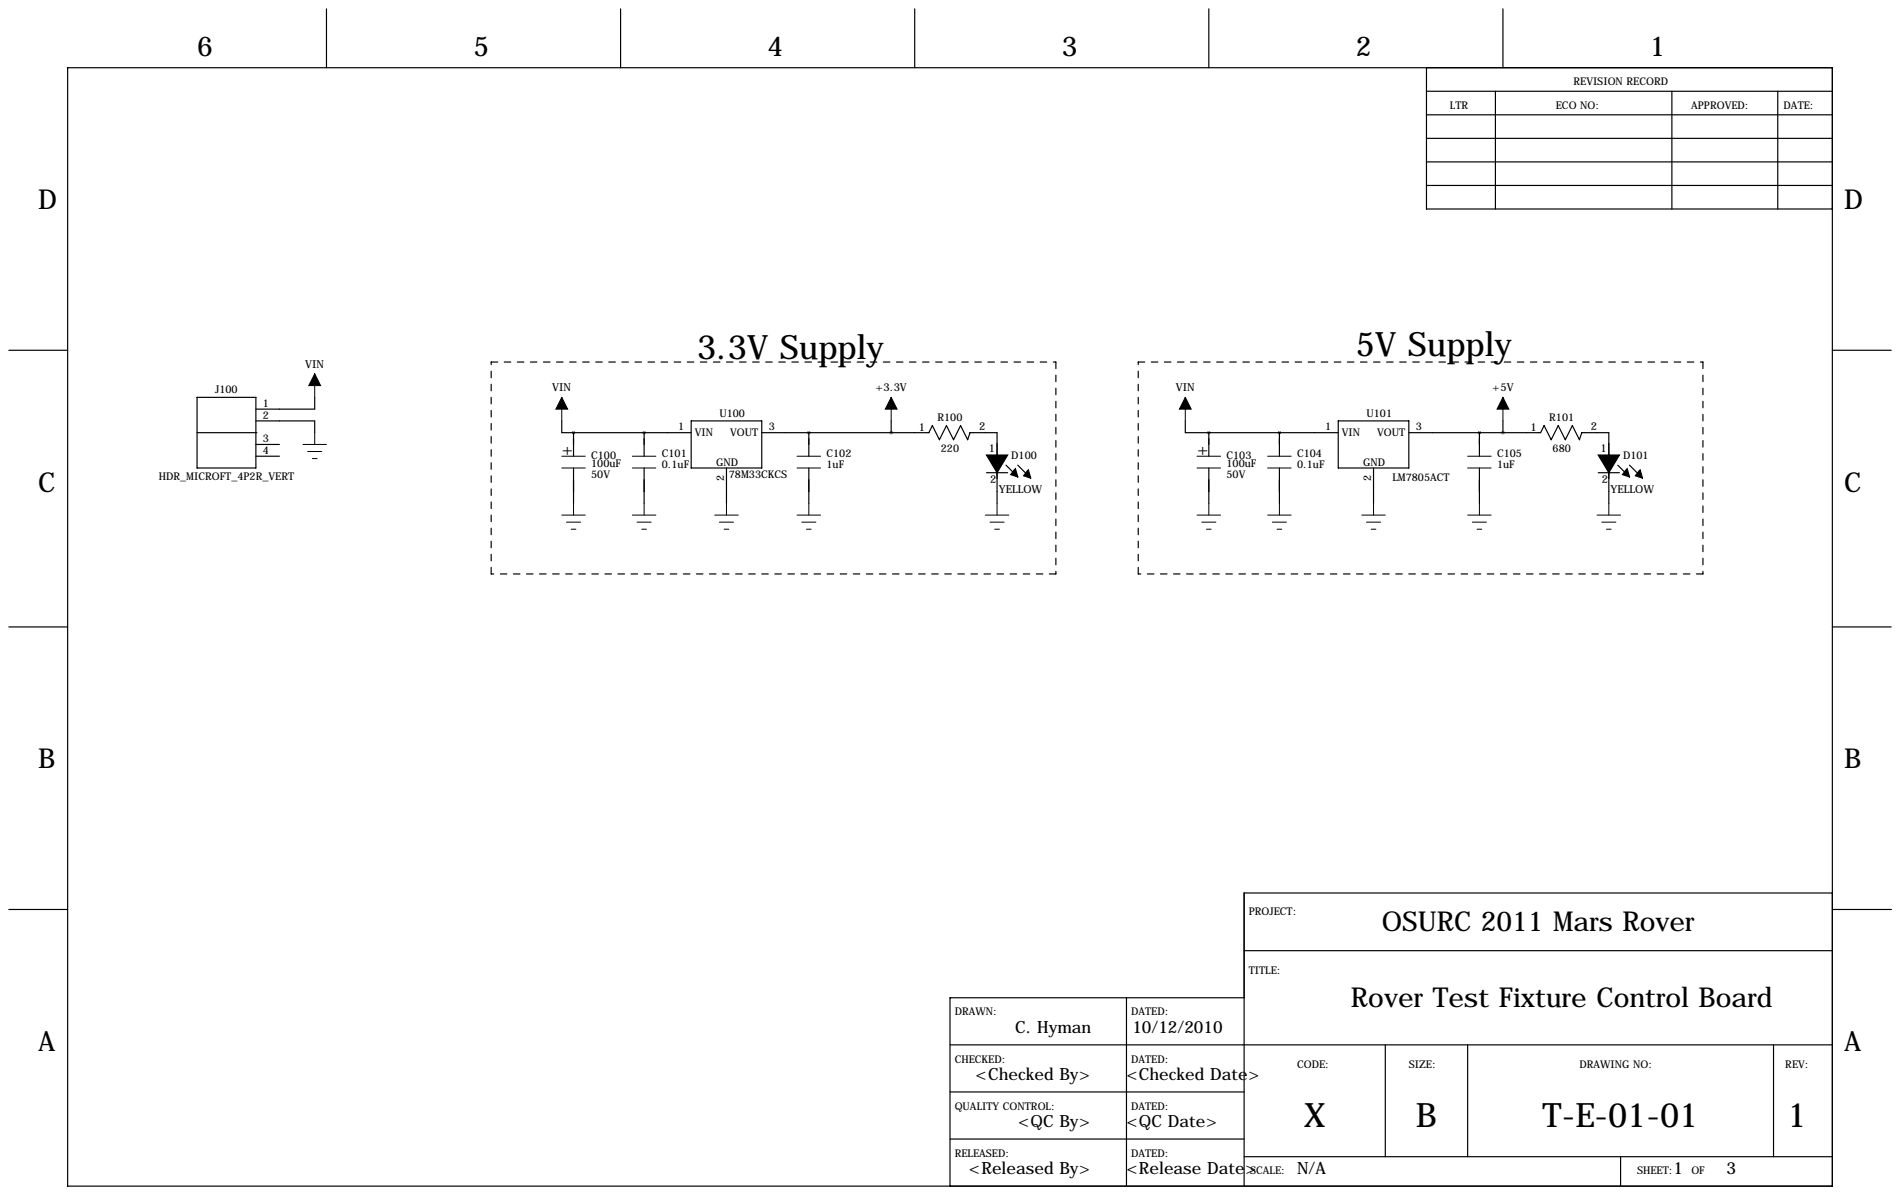
[picture p7: page 1]

Rover Test Fixture Control Board

DRAWN: C. Hyman | DATED: 10/12/2010

CHECKED: <Checked By> | DATED: <Checked Date> | CODE: X | SIZE: B | DRAWING NO: T-E-01-01 | REV: 1

QUALITY CONTROL: <QC By> | DATED: <QC Date>

RELEASED: <Released By> | DATED:

N/A SCALE: | 1 3 SHEET: OF

D

D

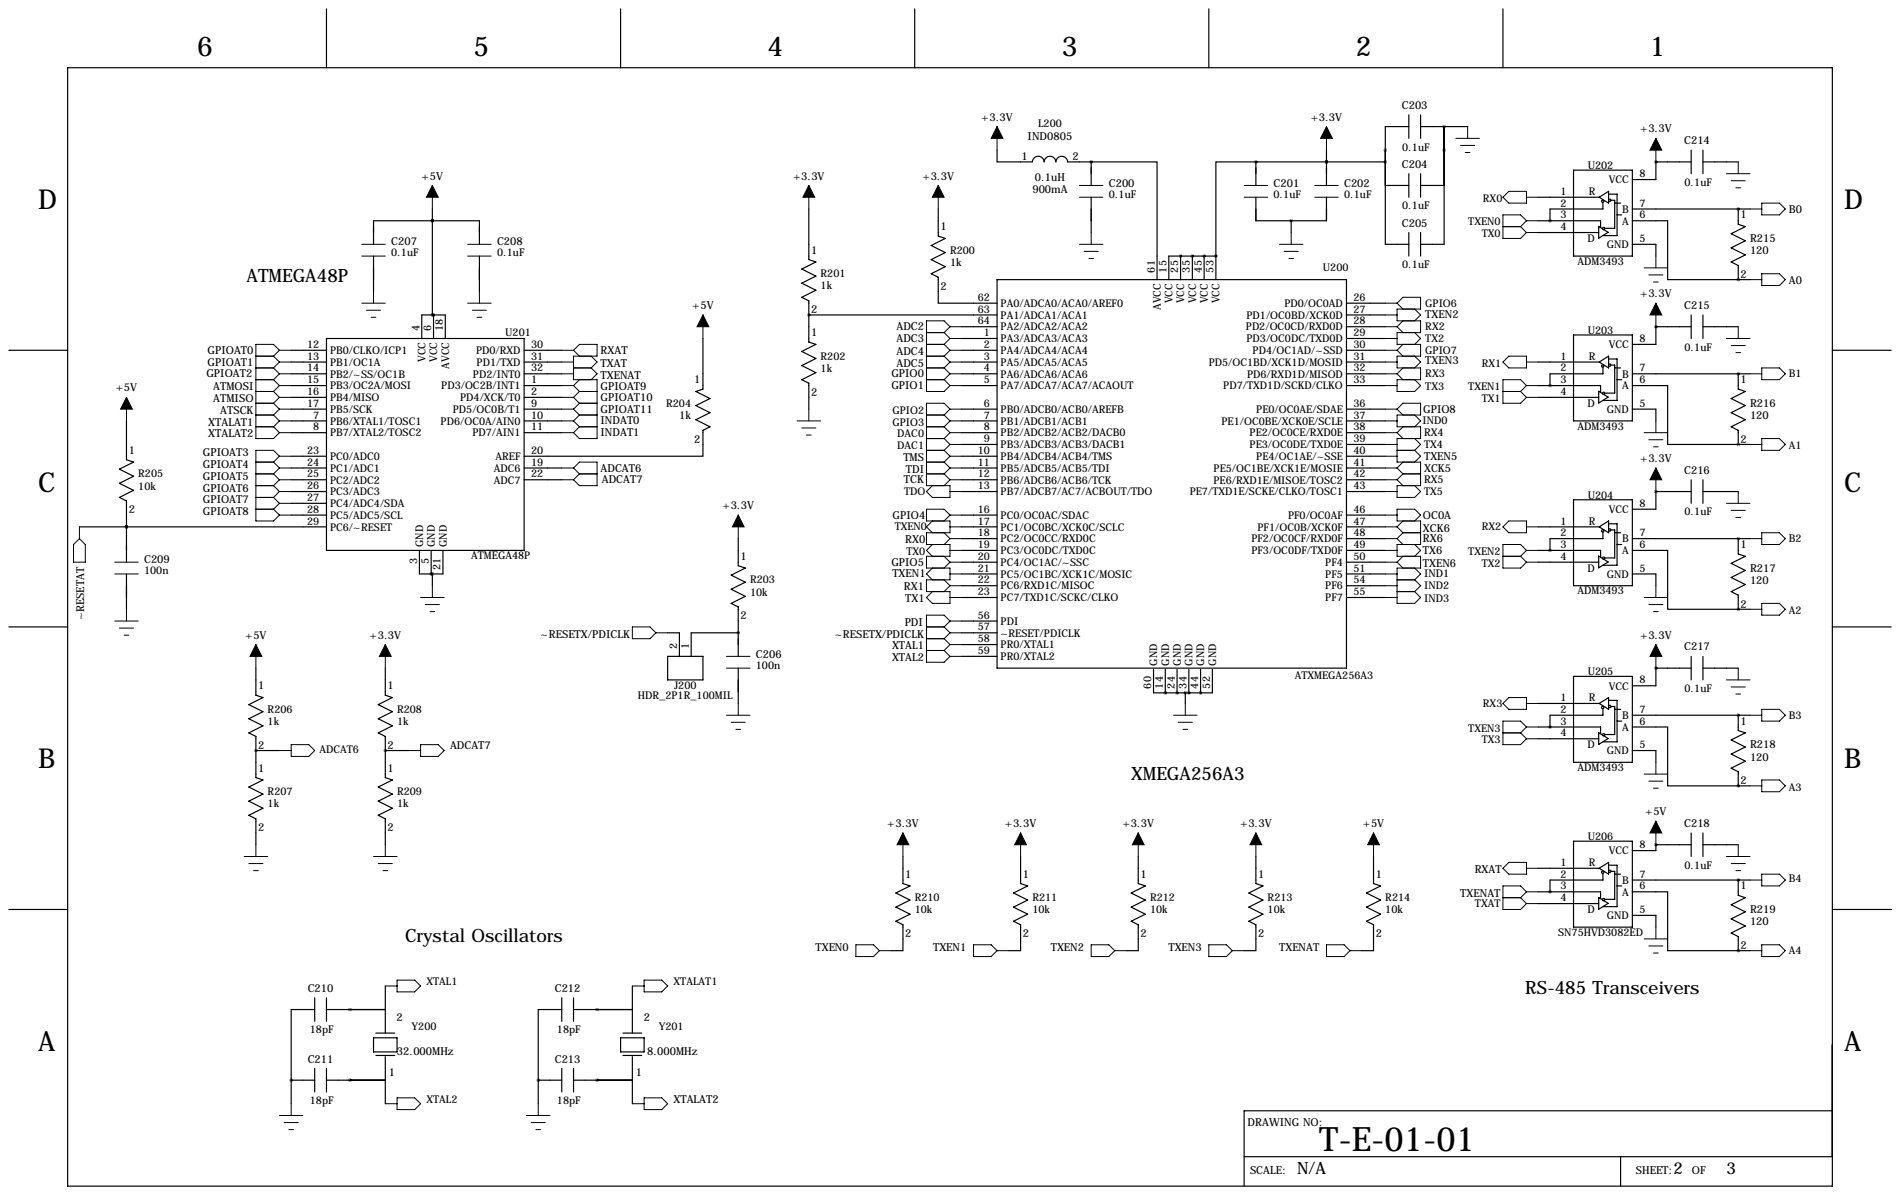
[picture p8: page 2]

D

D

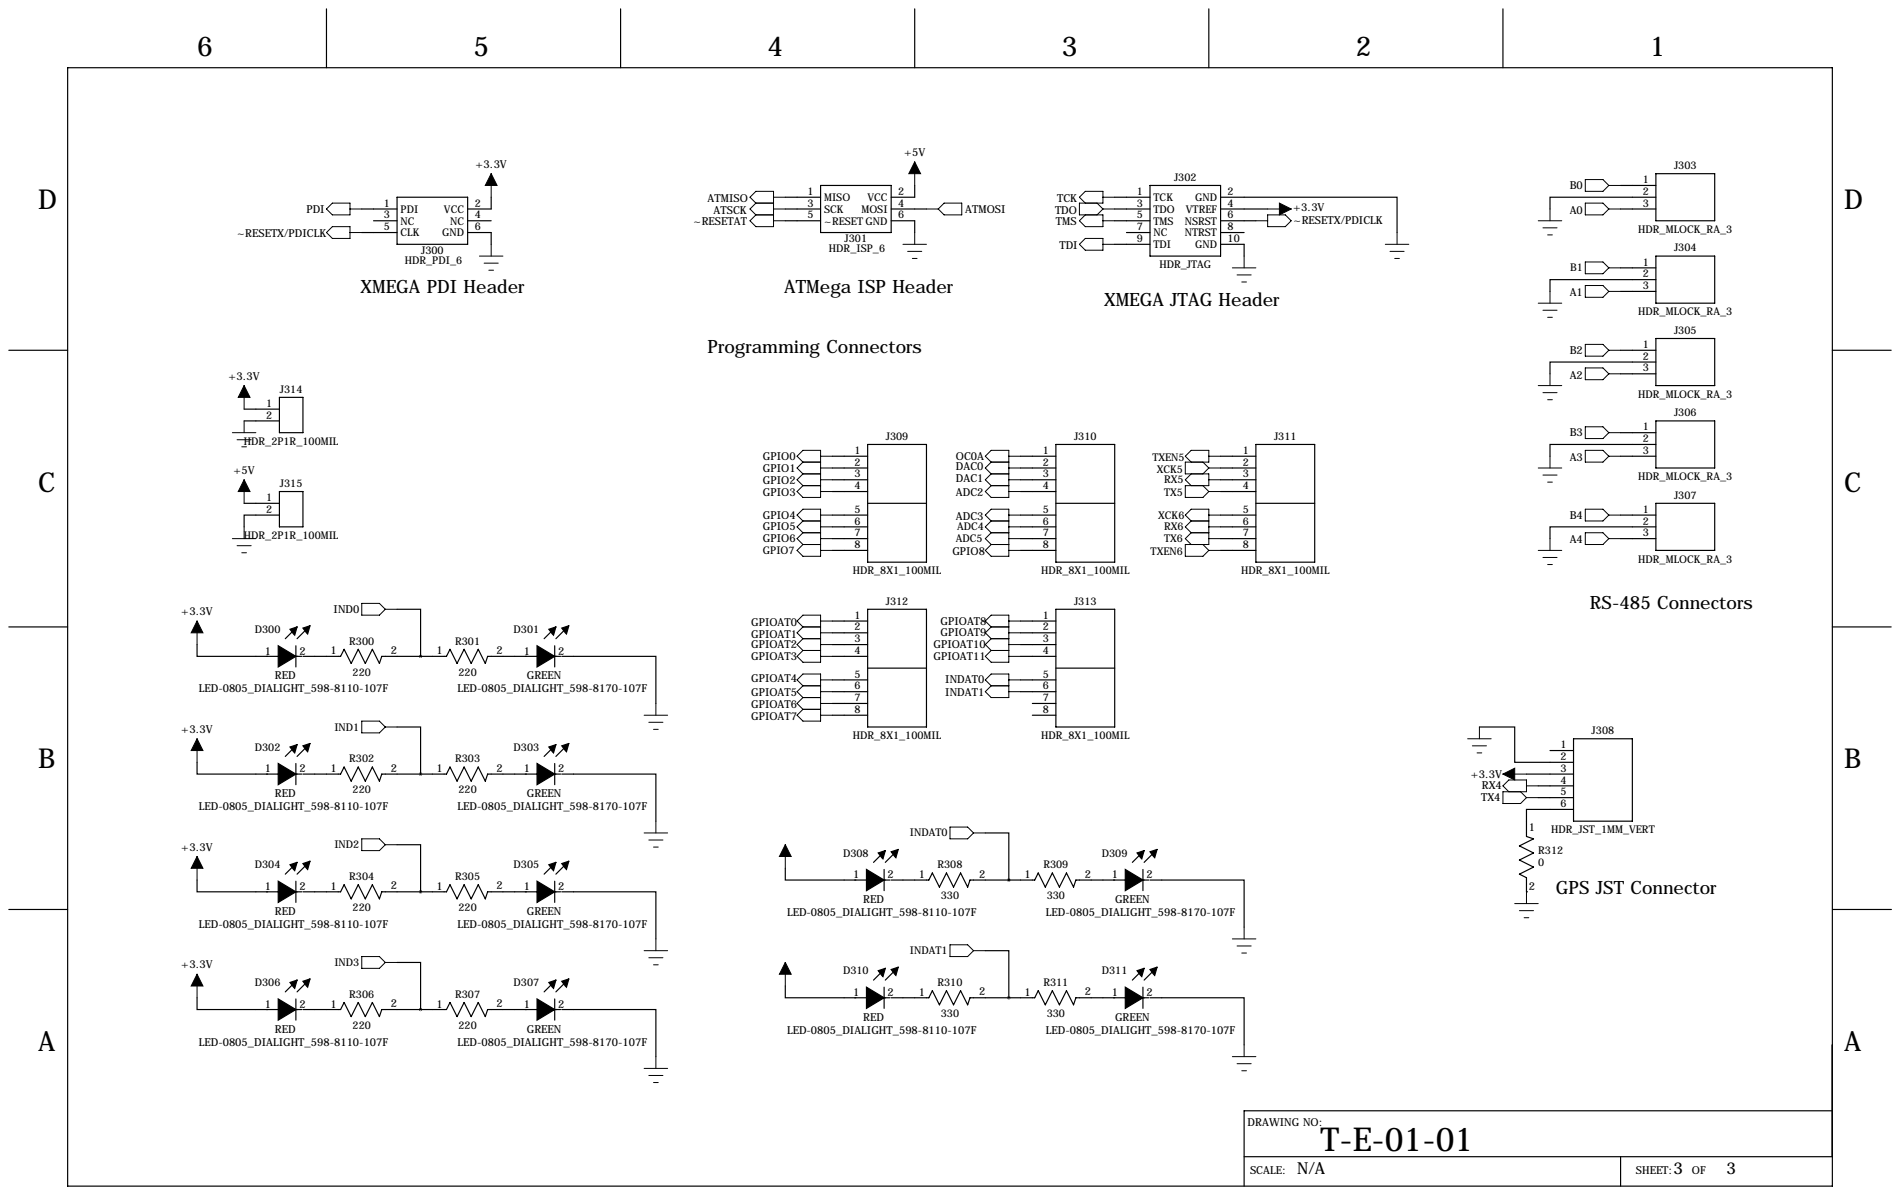
[picture p9: page 3]
