OregonStateMarsRover/2011/Electrical/padsDrawings/R-E-03-03(Power_Supply)/R-E-03-03_A0.pdf

D

6 | 5 | 4 | 3 | 2 | 1

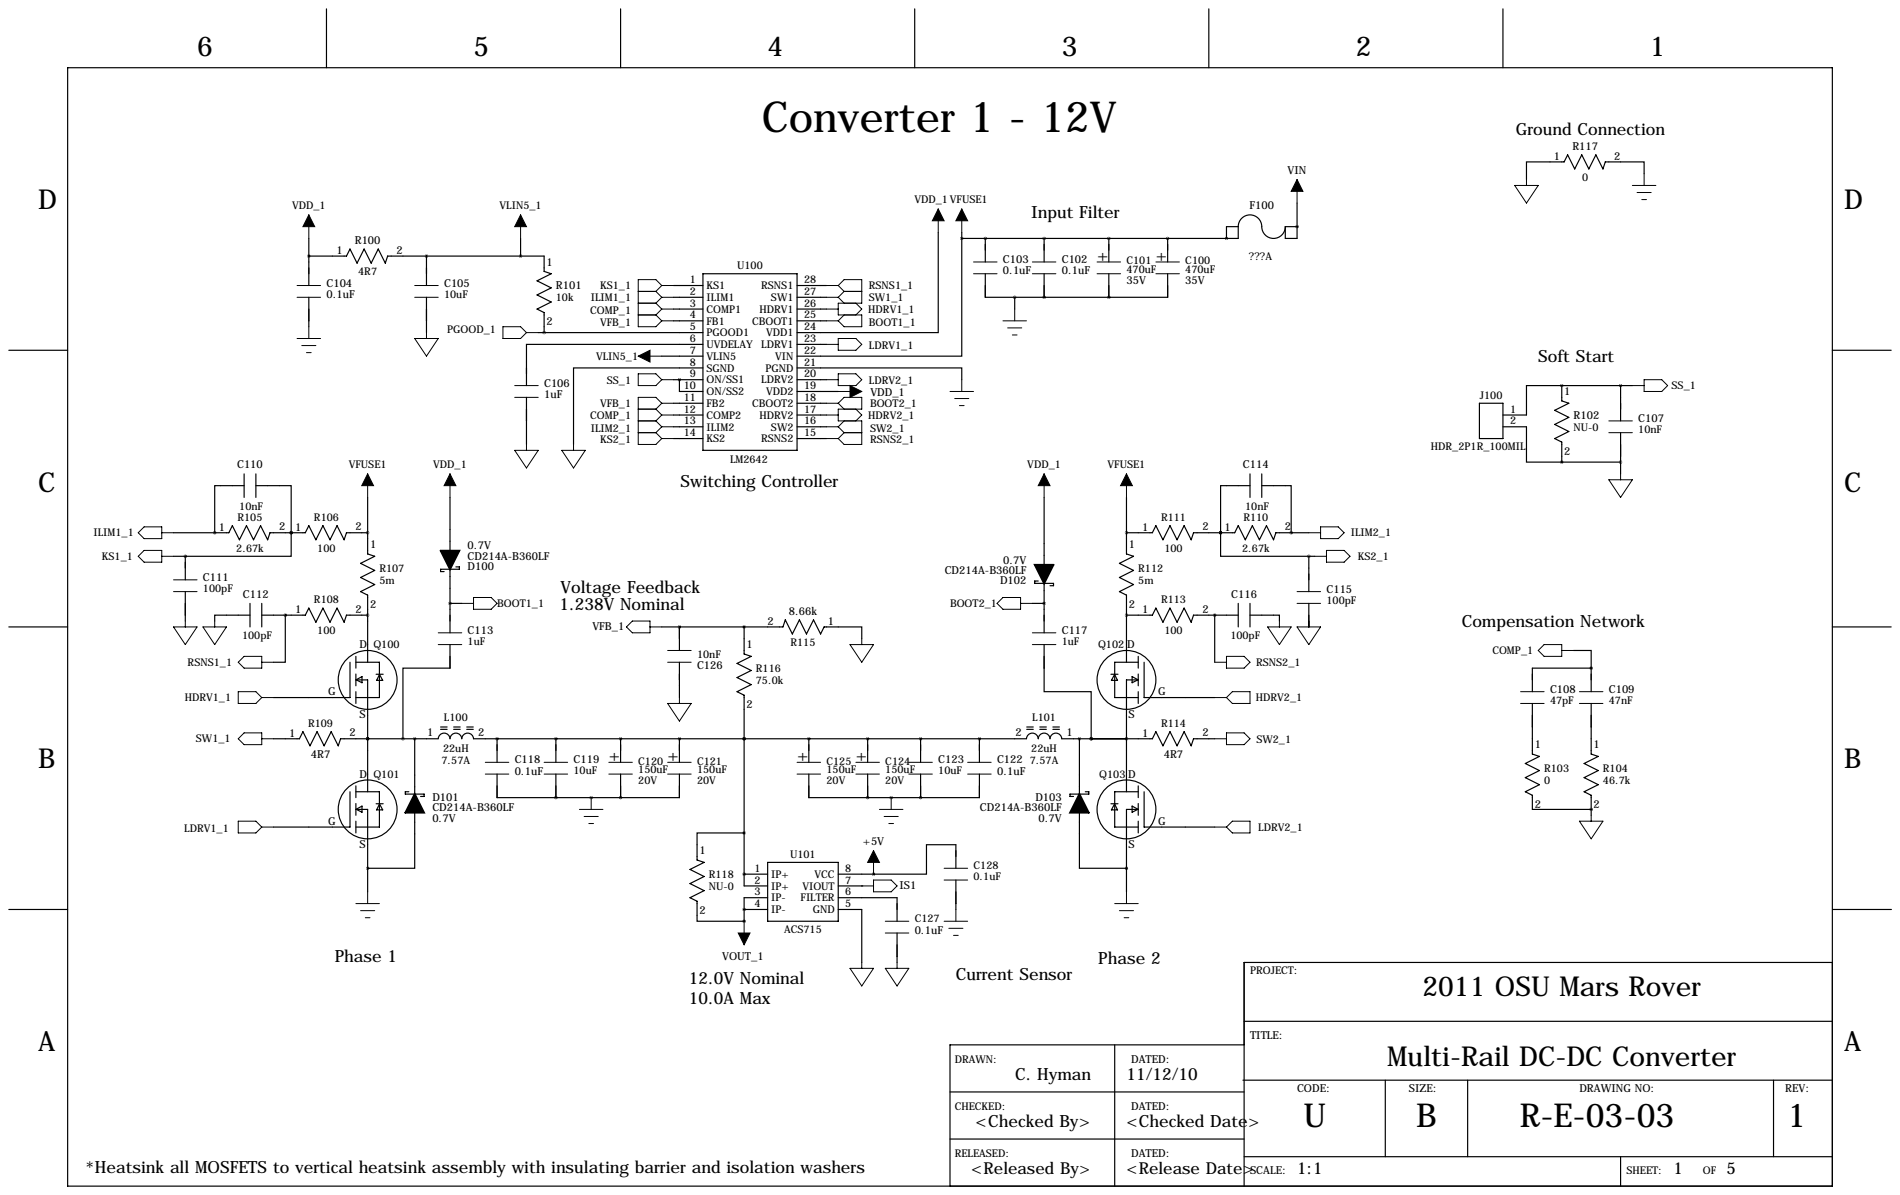
[picture p10: page 1]

DRAWN: C. Hyman | DATED: 11/12/10

Multi-Rail DC-DC Converter

CODE: U | SIZE: B | DRAWING NO: R-E-03-03 | REV: 1

CHECKED: <Checked By> | DATED: <Checked Date>

RELEASED: <Released By> | DATED:

*Heatsink all MOSFETS to vertical heatsink assembly with insulating barrier and isolation washers

1:1 SCALE: | 1 5 SHEET: OF

D

D

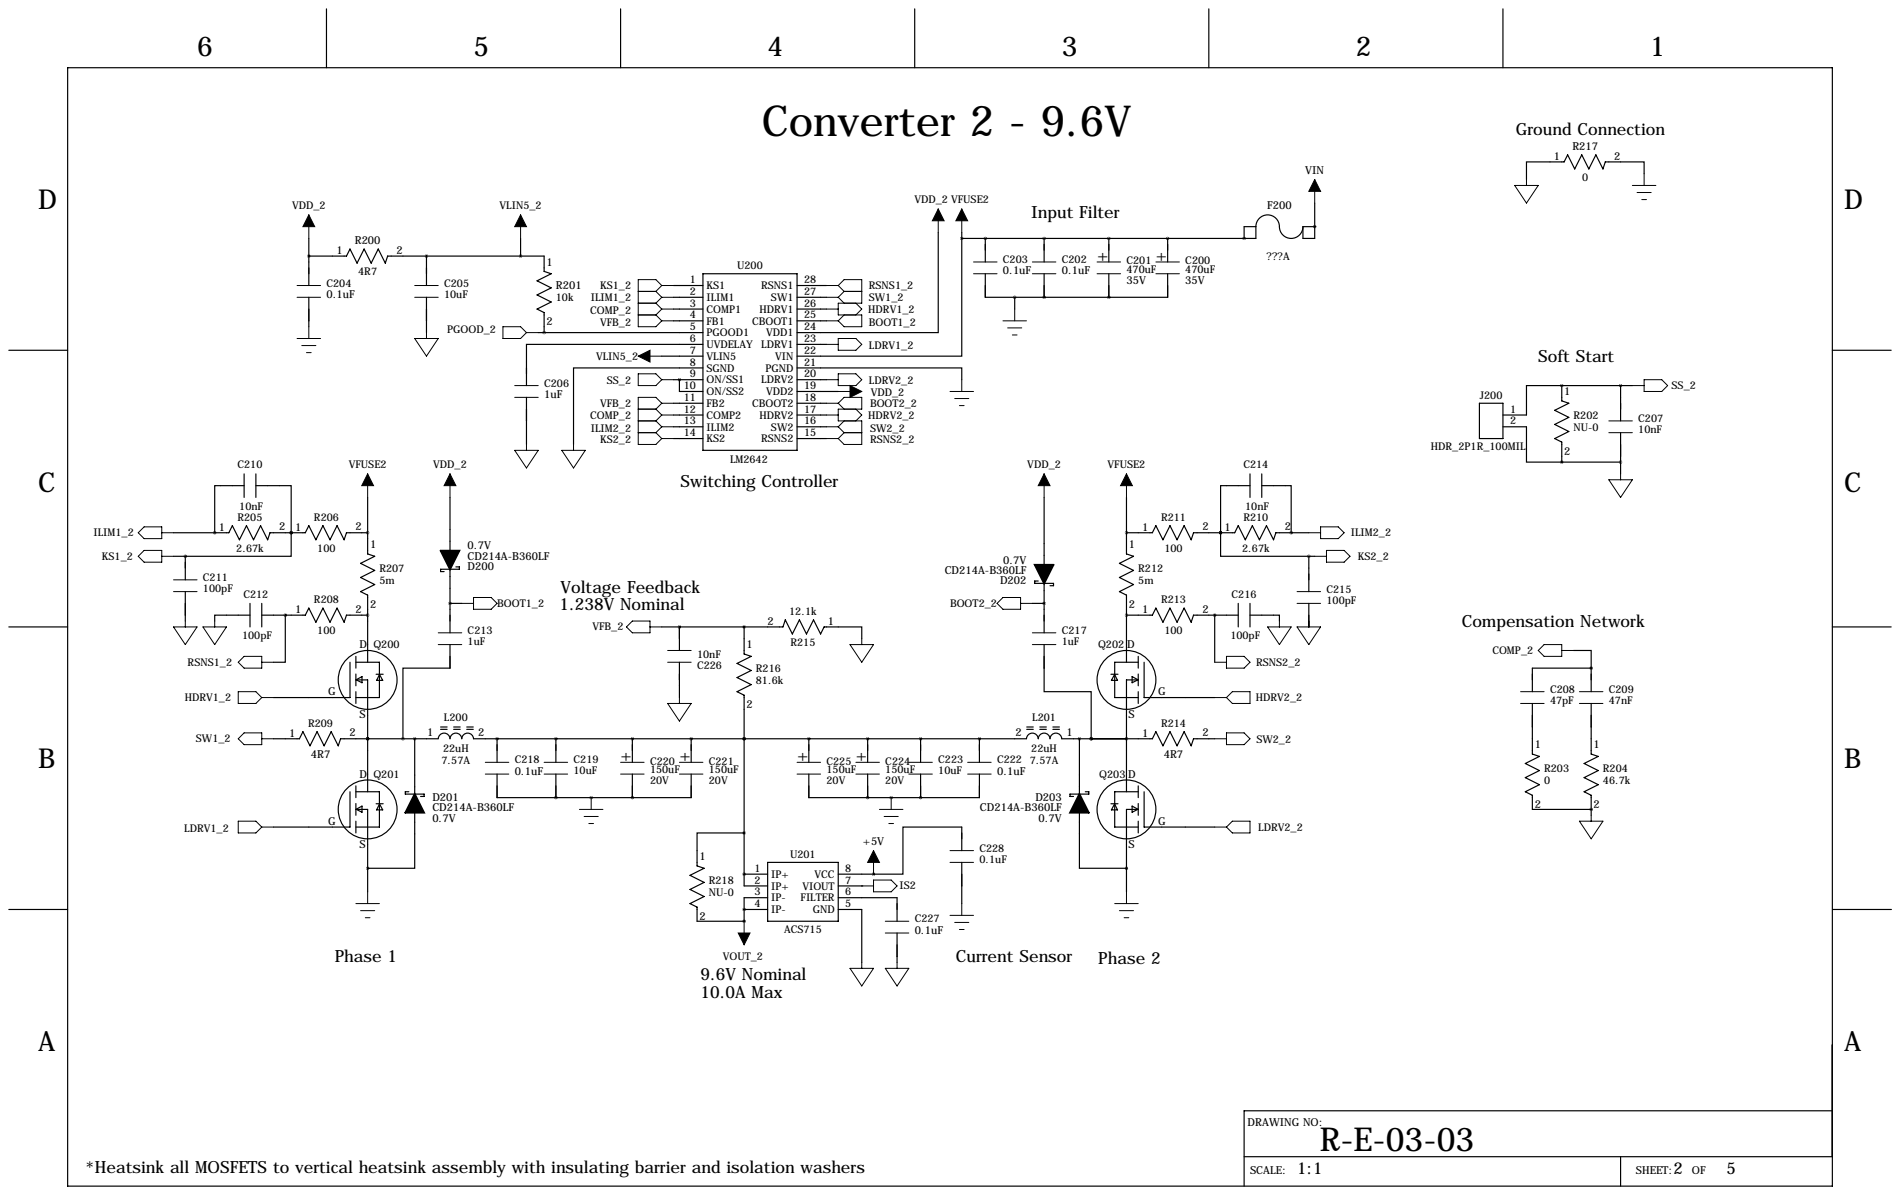
[picture p11: page 2]

*Heatsink all MOSFETS to vertical heatsink assembly with insulating barrier and isolation washers

D

D

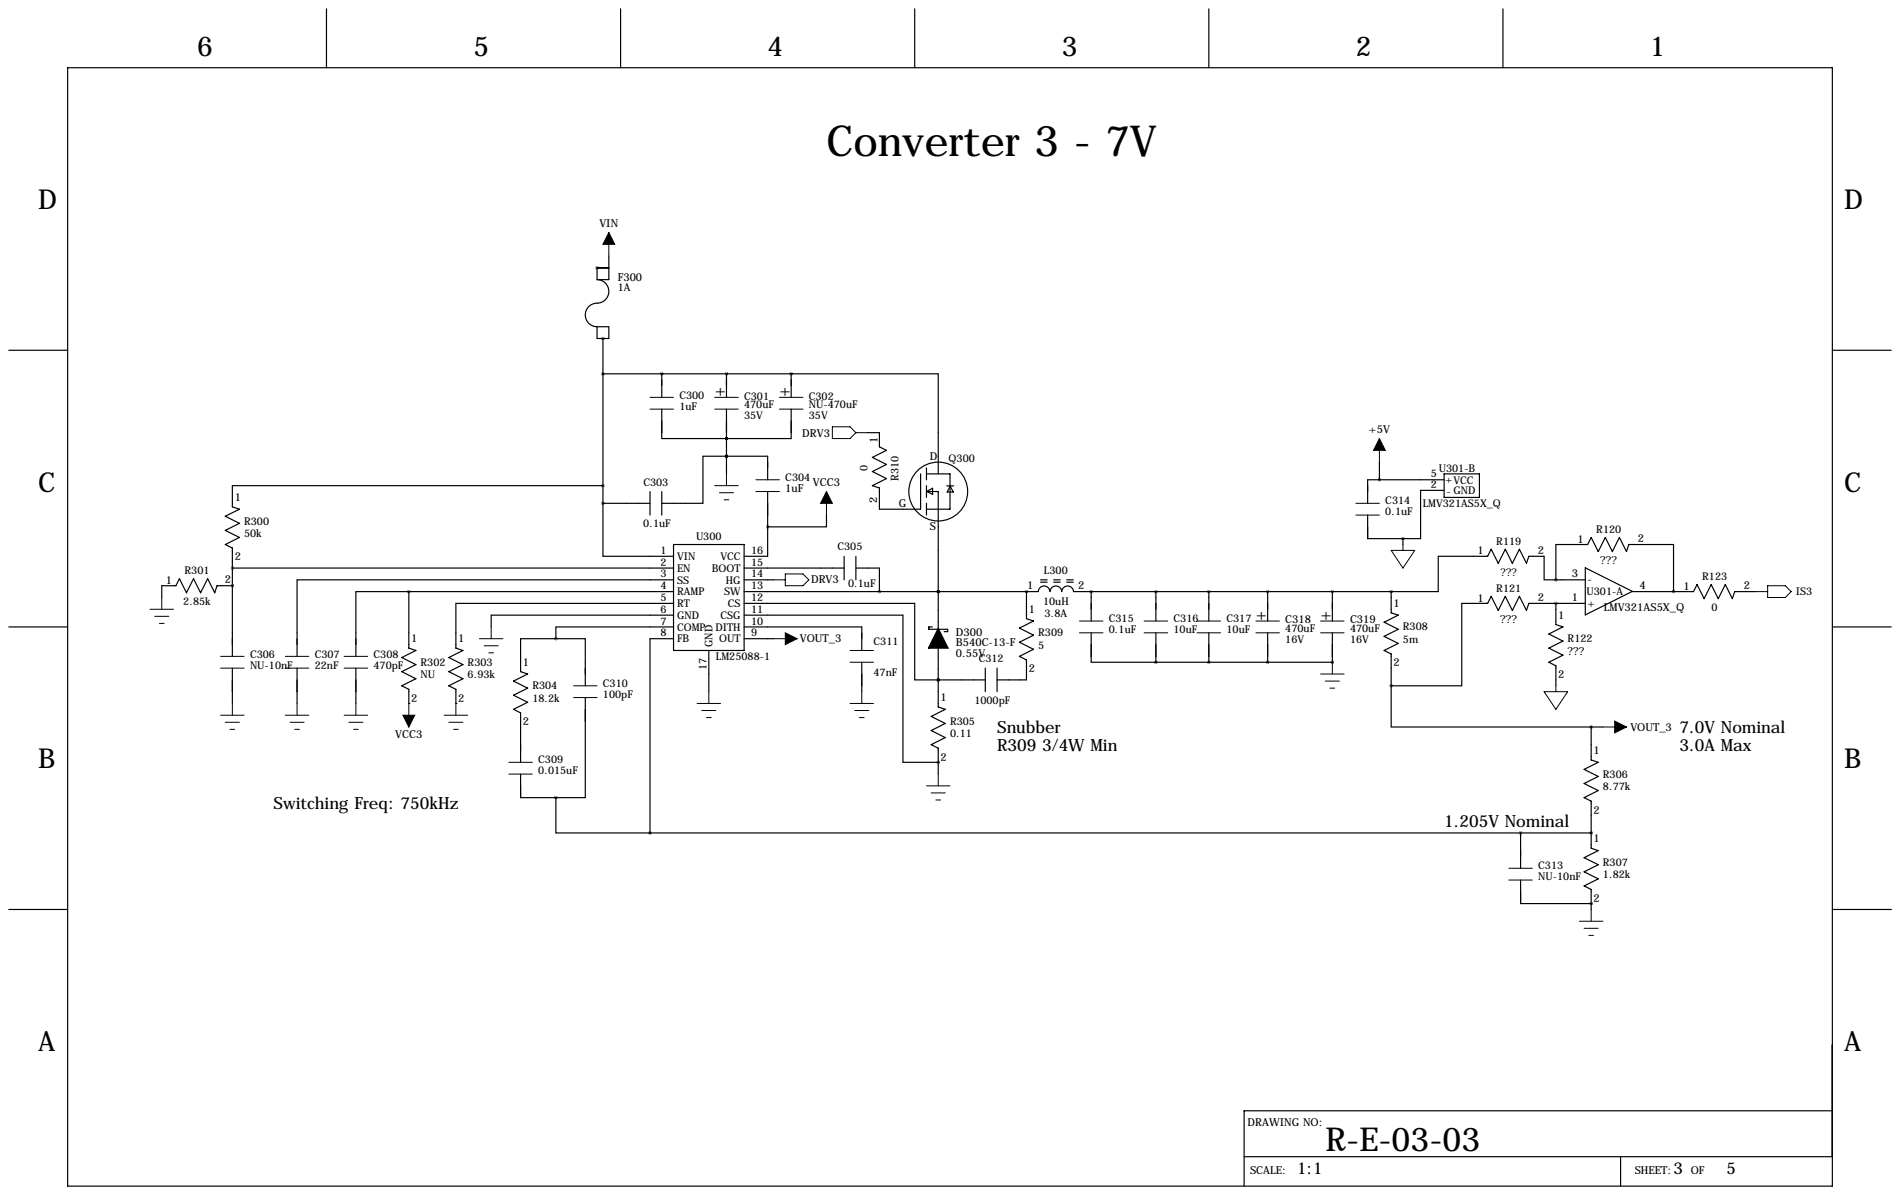
[picture p12: page 3]

D

D

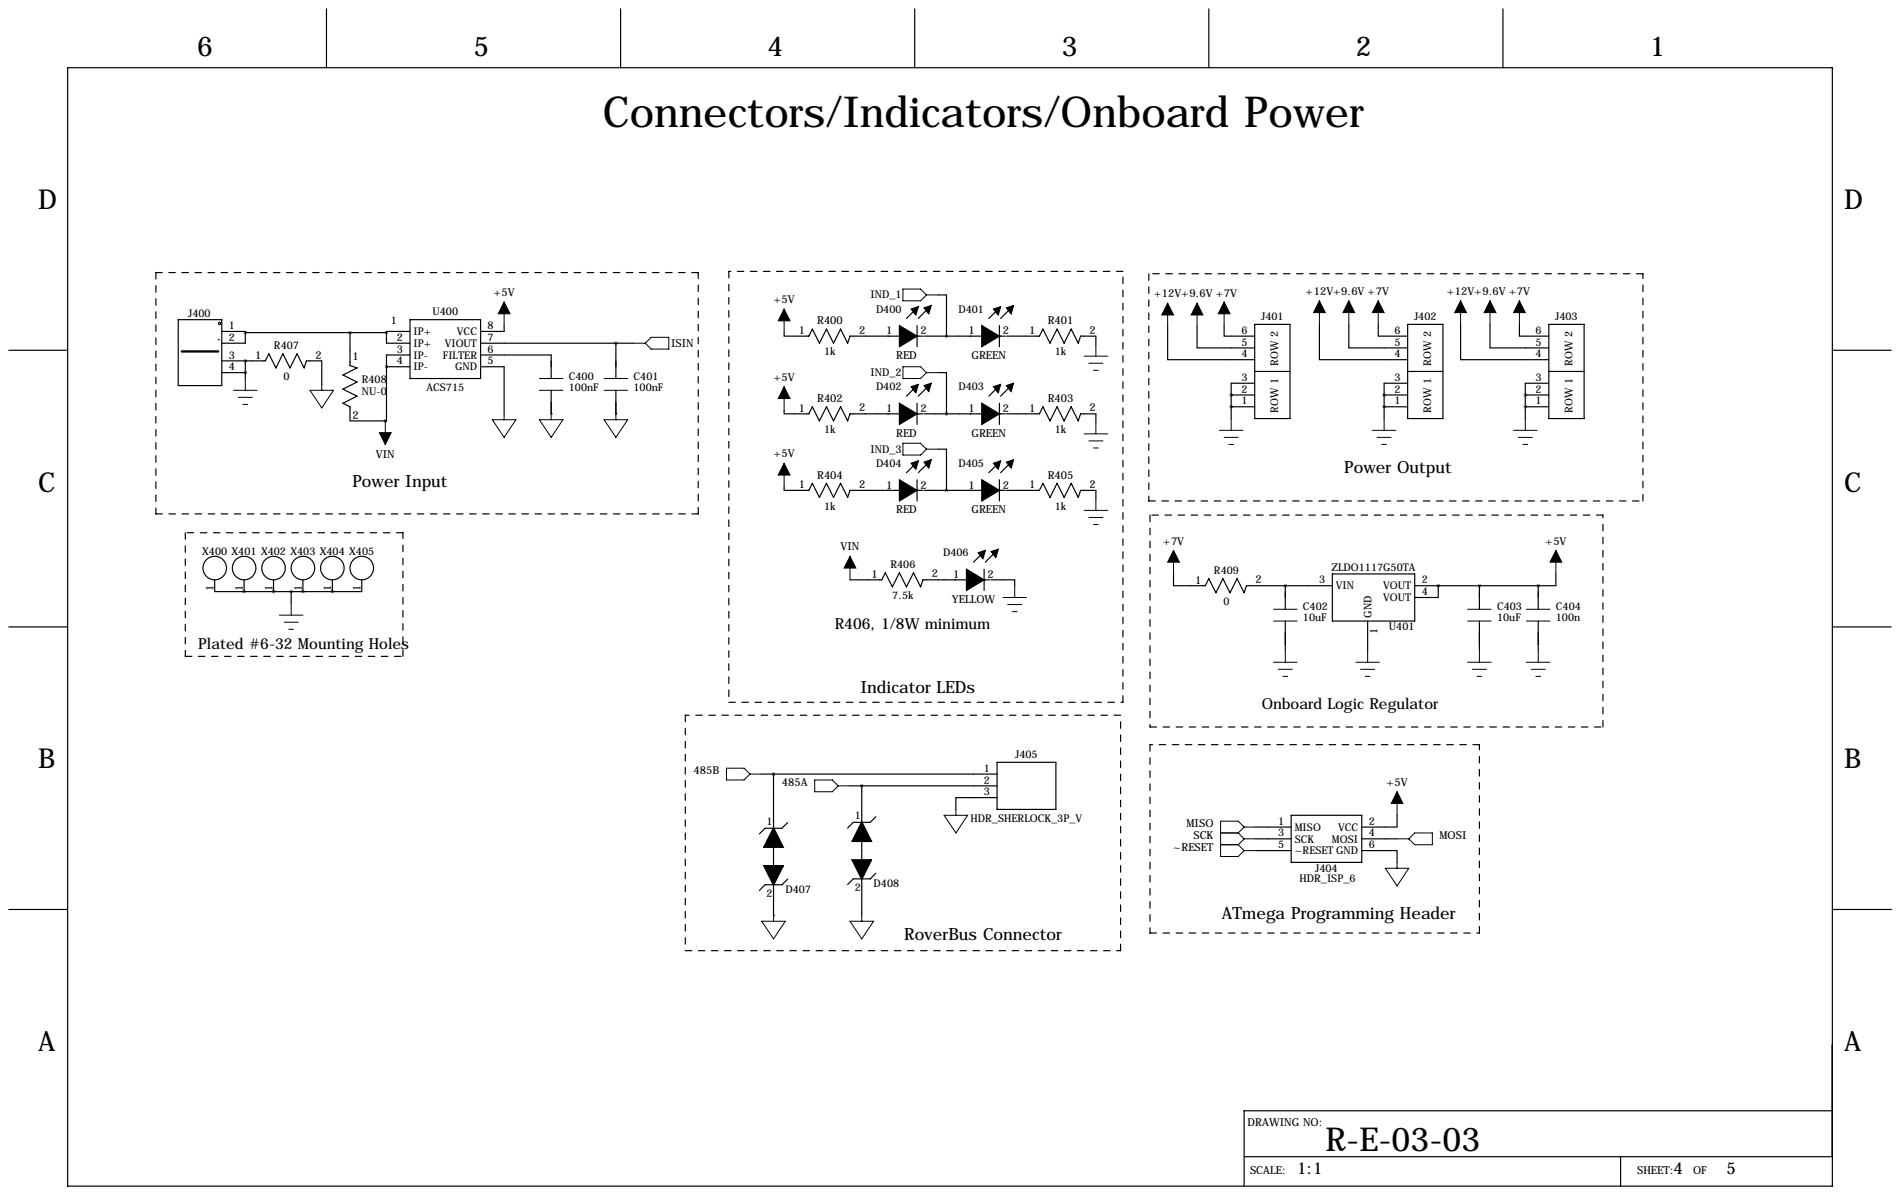
[picture p13: page 4]

Connectors/Indicators/Onboard Power

D

D

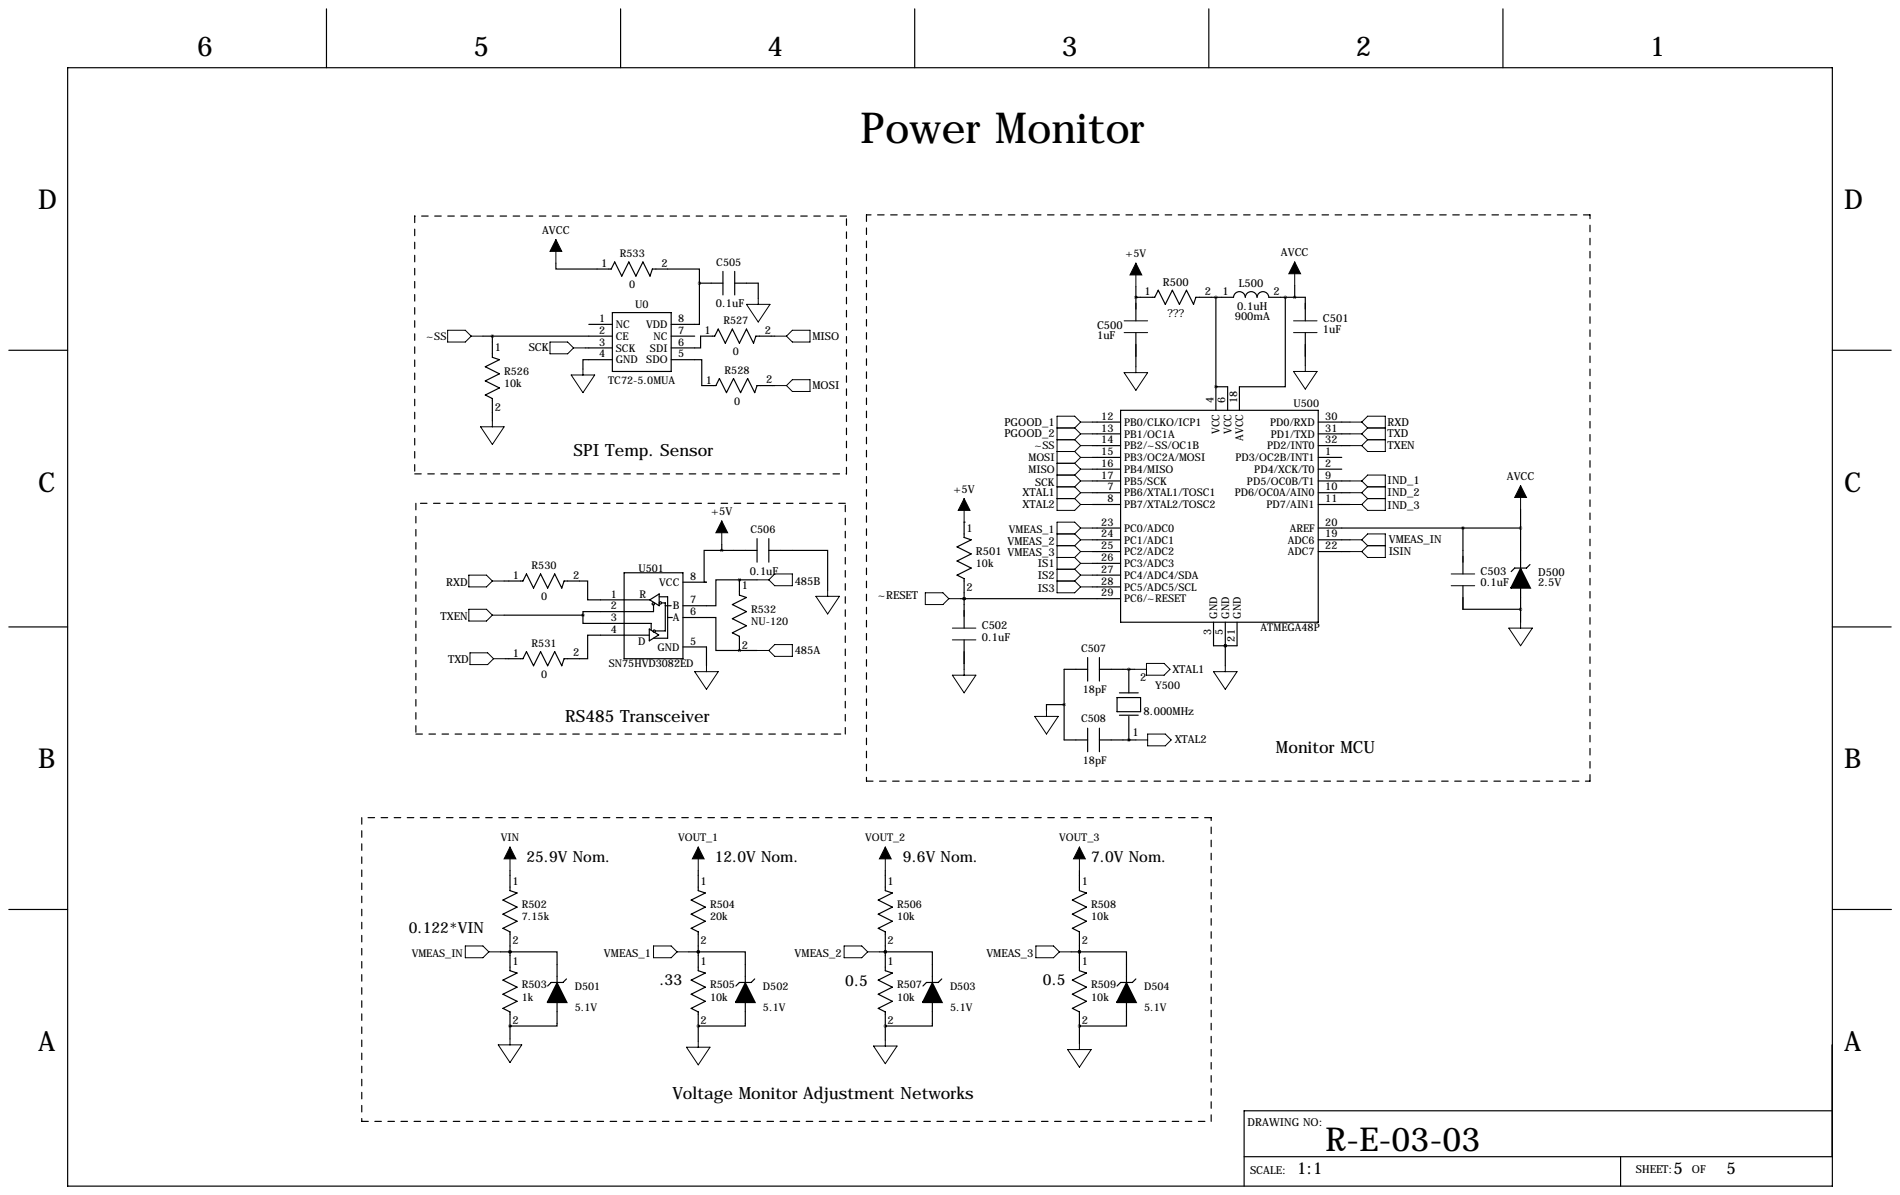
[picture p14: page 5]

Voltage Monitor Adjustment Networks
