OregonStateMarsRover/2011/Electrical/padsDrawings/R-E-05-01(Main_Board)/Rev. 2/R-E-05-01_02.pdf

D

6 | 5 | 4 | 3 | 2 | 1

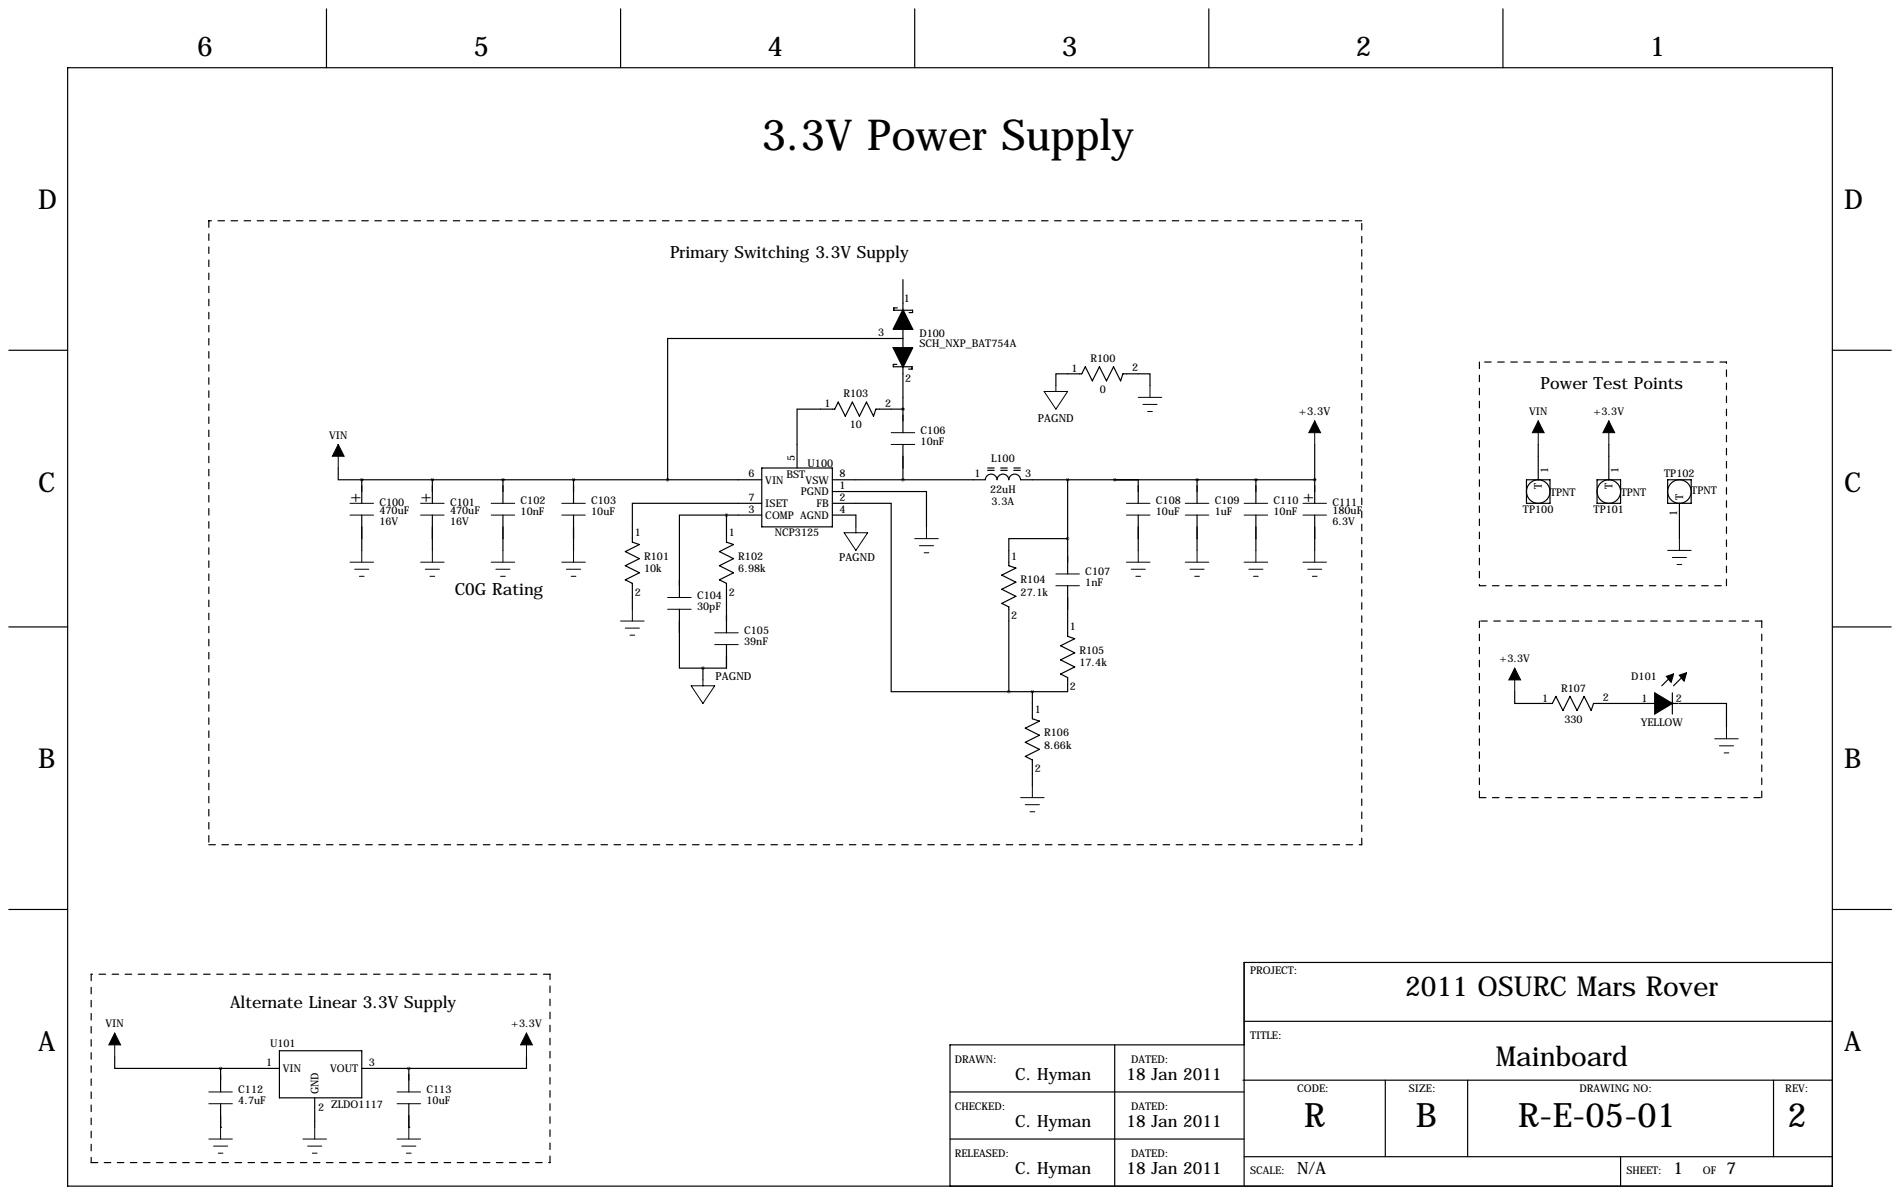
[picture p15: page 1]

Power Test Points

DRAWN: C. Hyman | DATED: 18 Jan 2011

CODE: R | SIZE: B | DRAWING NO: R-E-05-01 | REV: 2

CHECKED: C. Hyman | 18 Jan 2011 DATED:

RELEASED: C. Hyman | DATED: 18 Jan 2011

N/A SCALE: | 1 7 SHEET: OF

D

D

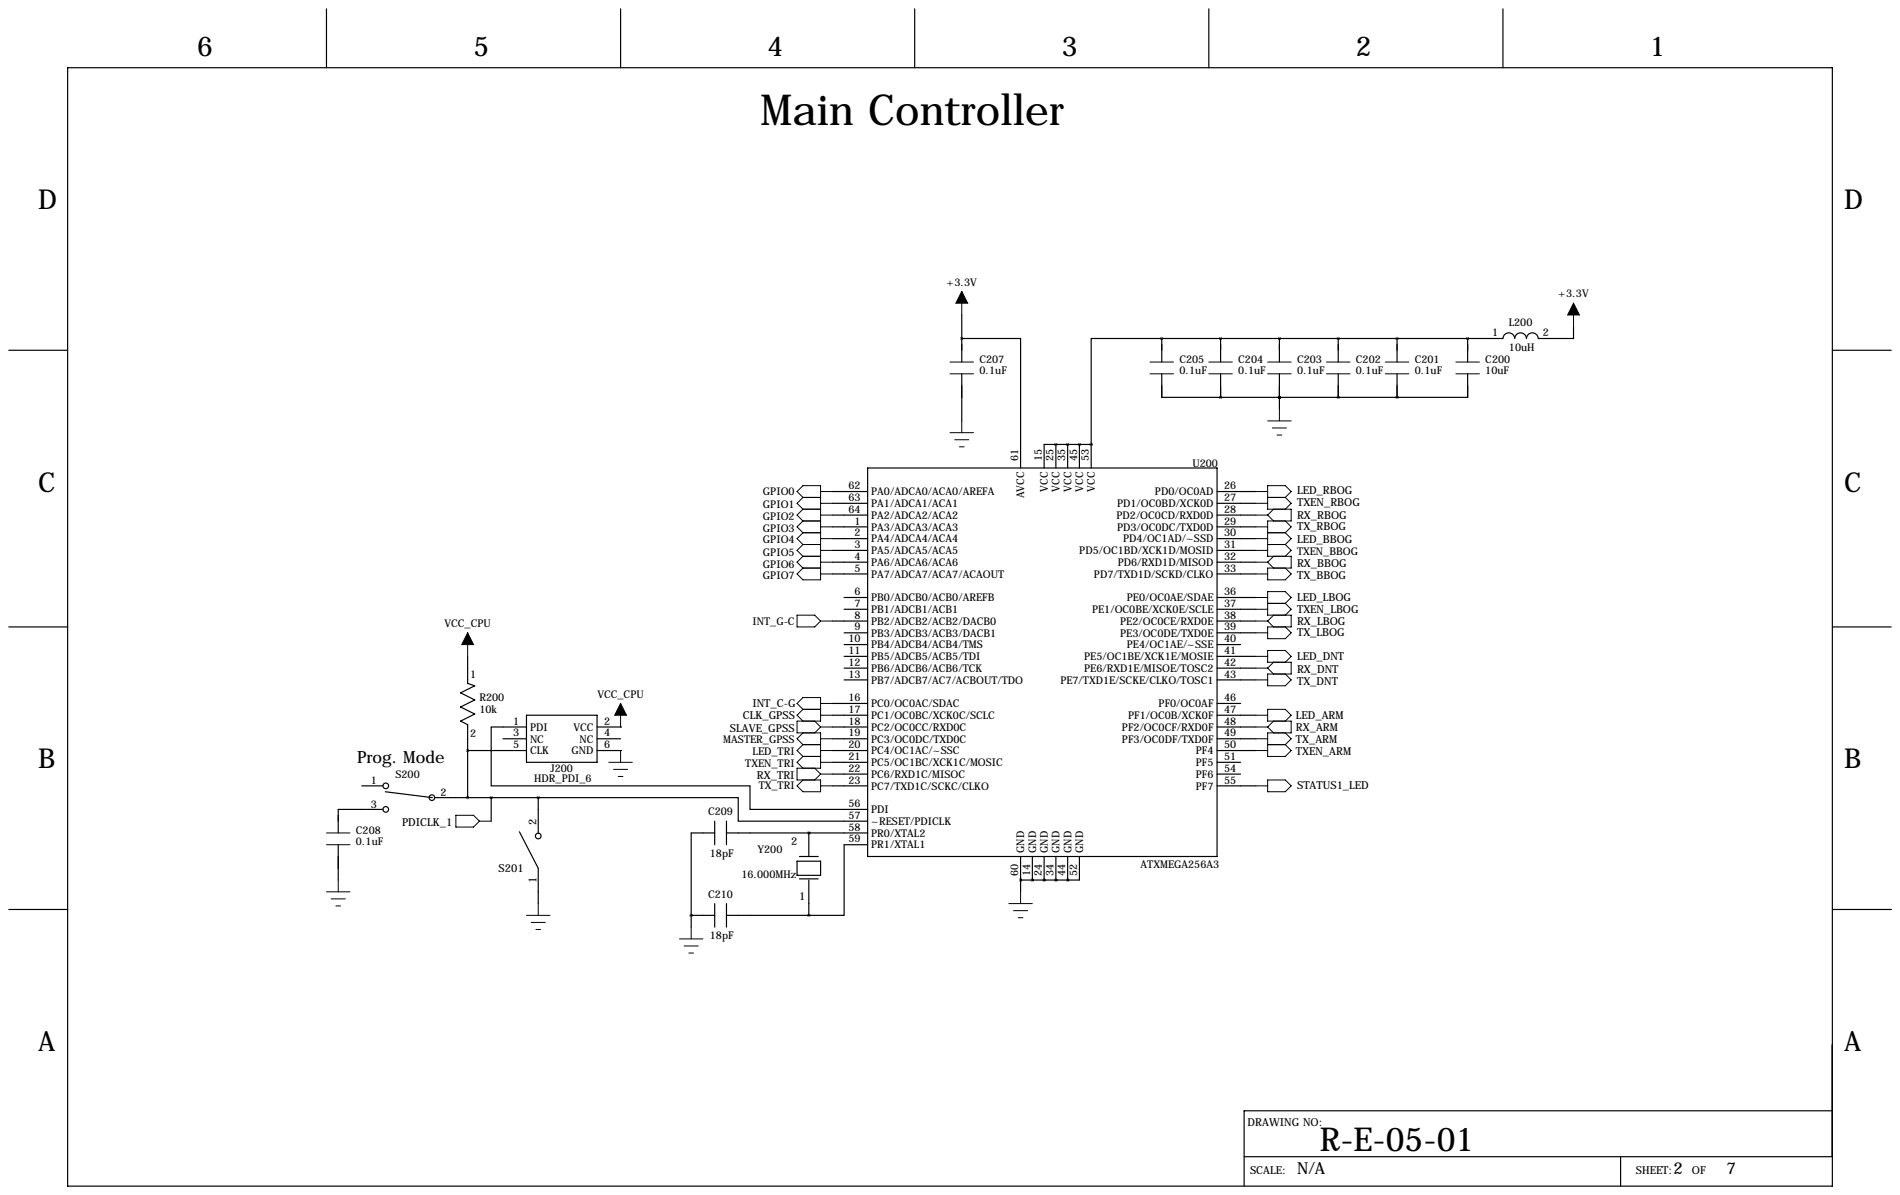
[picture p16: page 2]

D

D

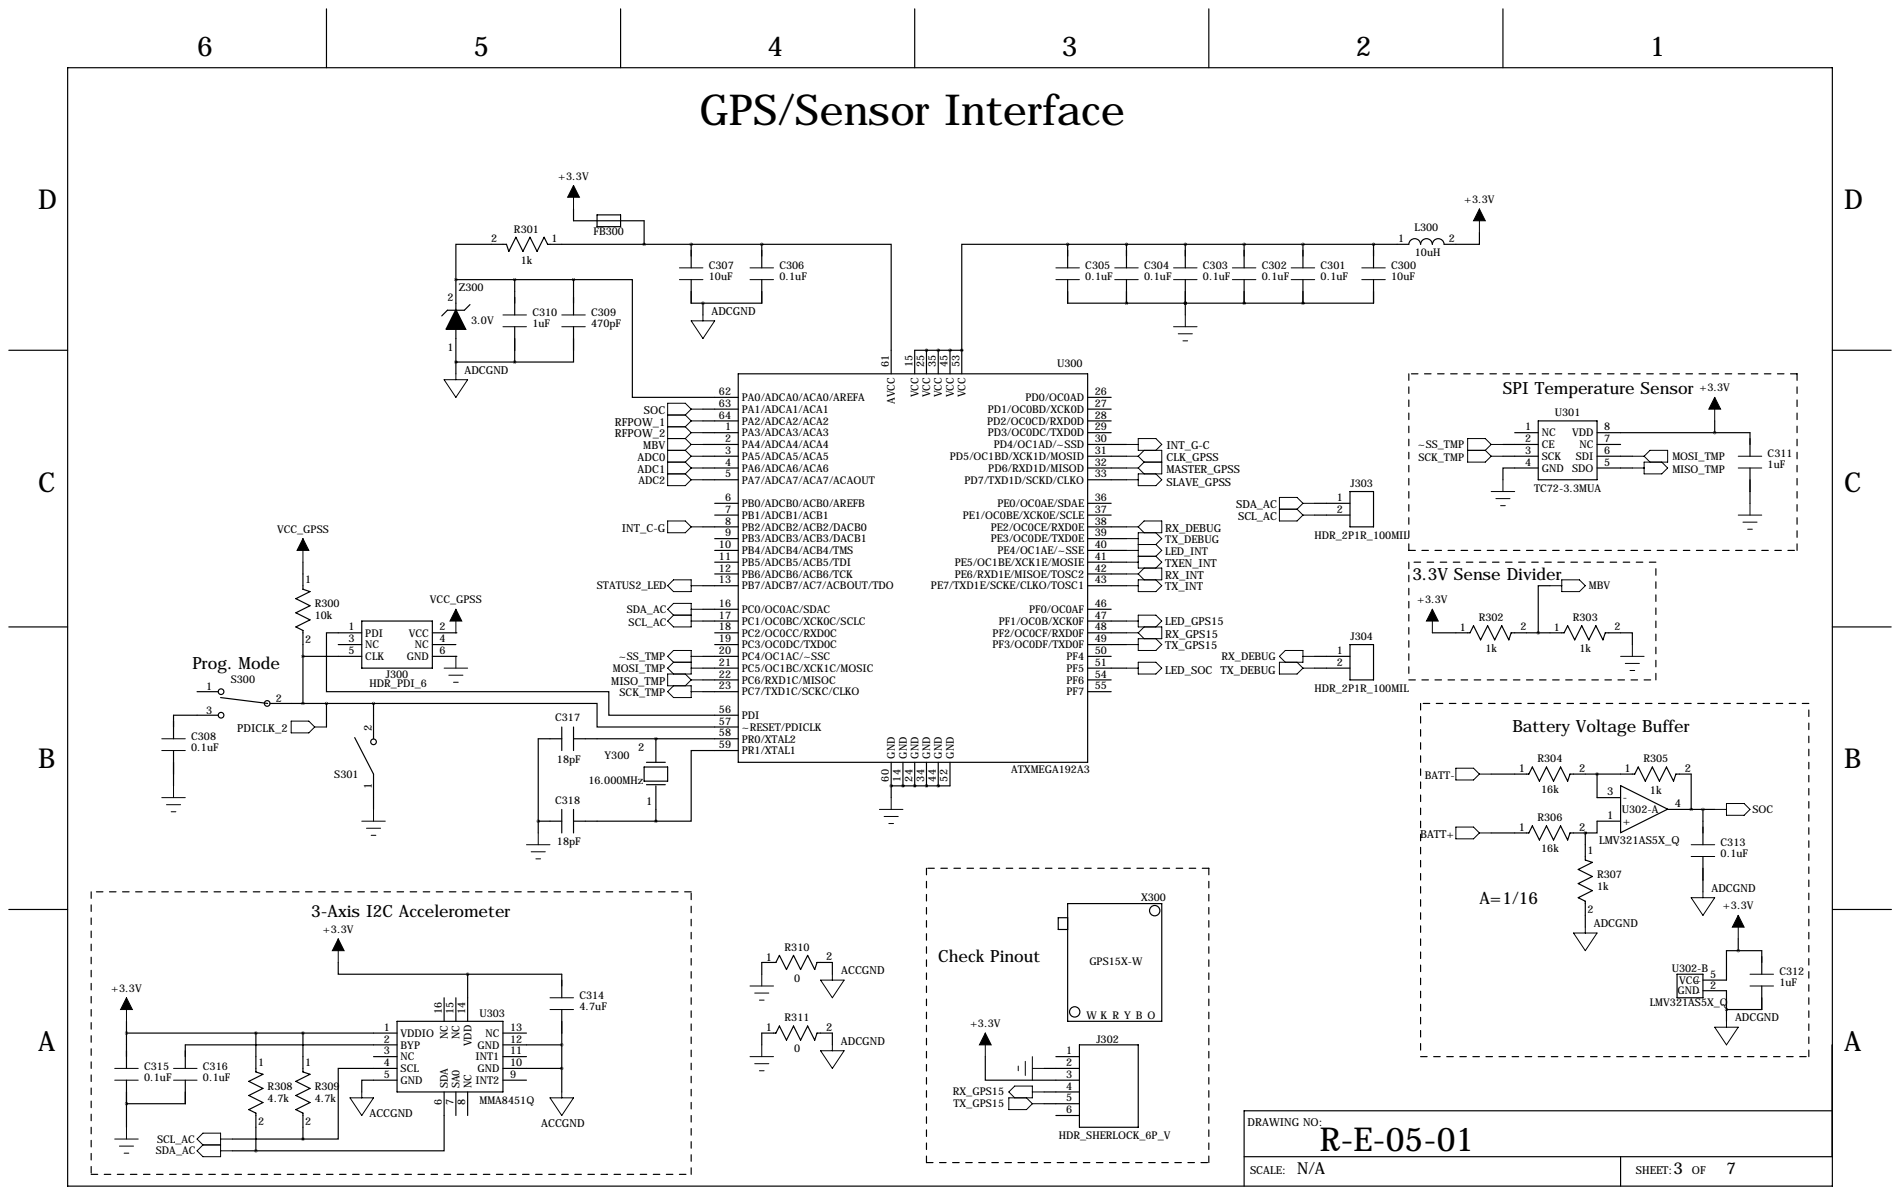
[picture p17: page 3]

VDDIO 2
BYP 3

D

D

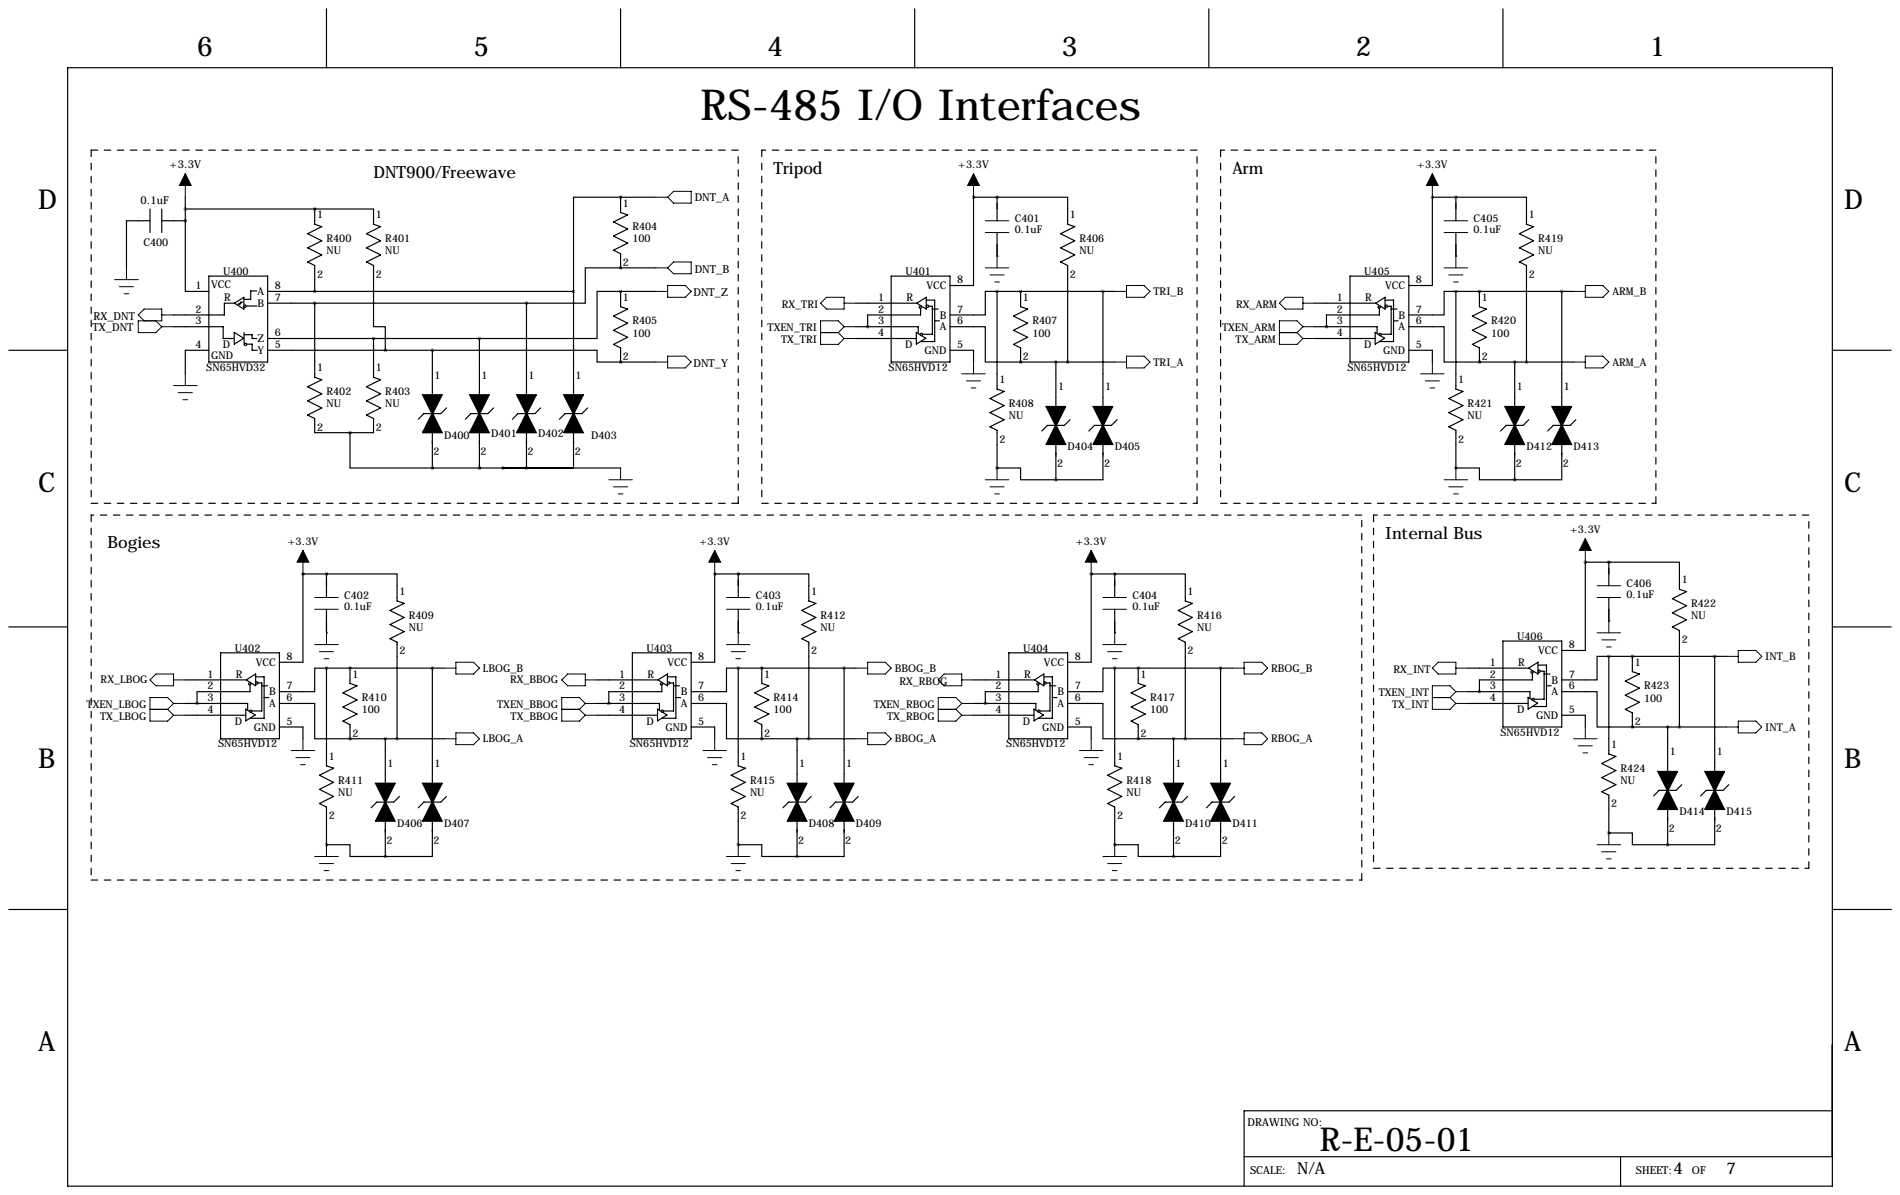
[picture p18: page 4]

D

D

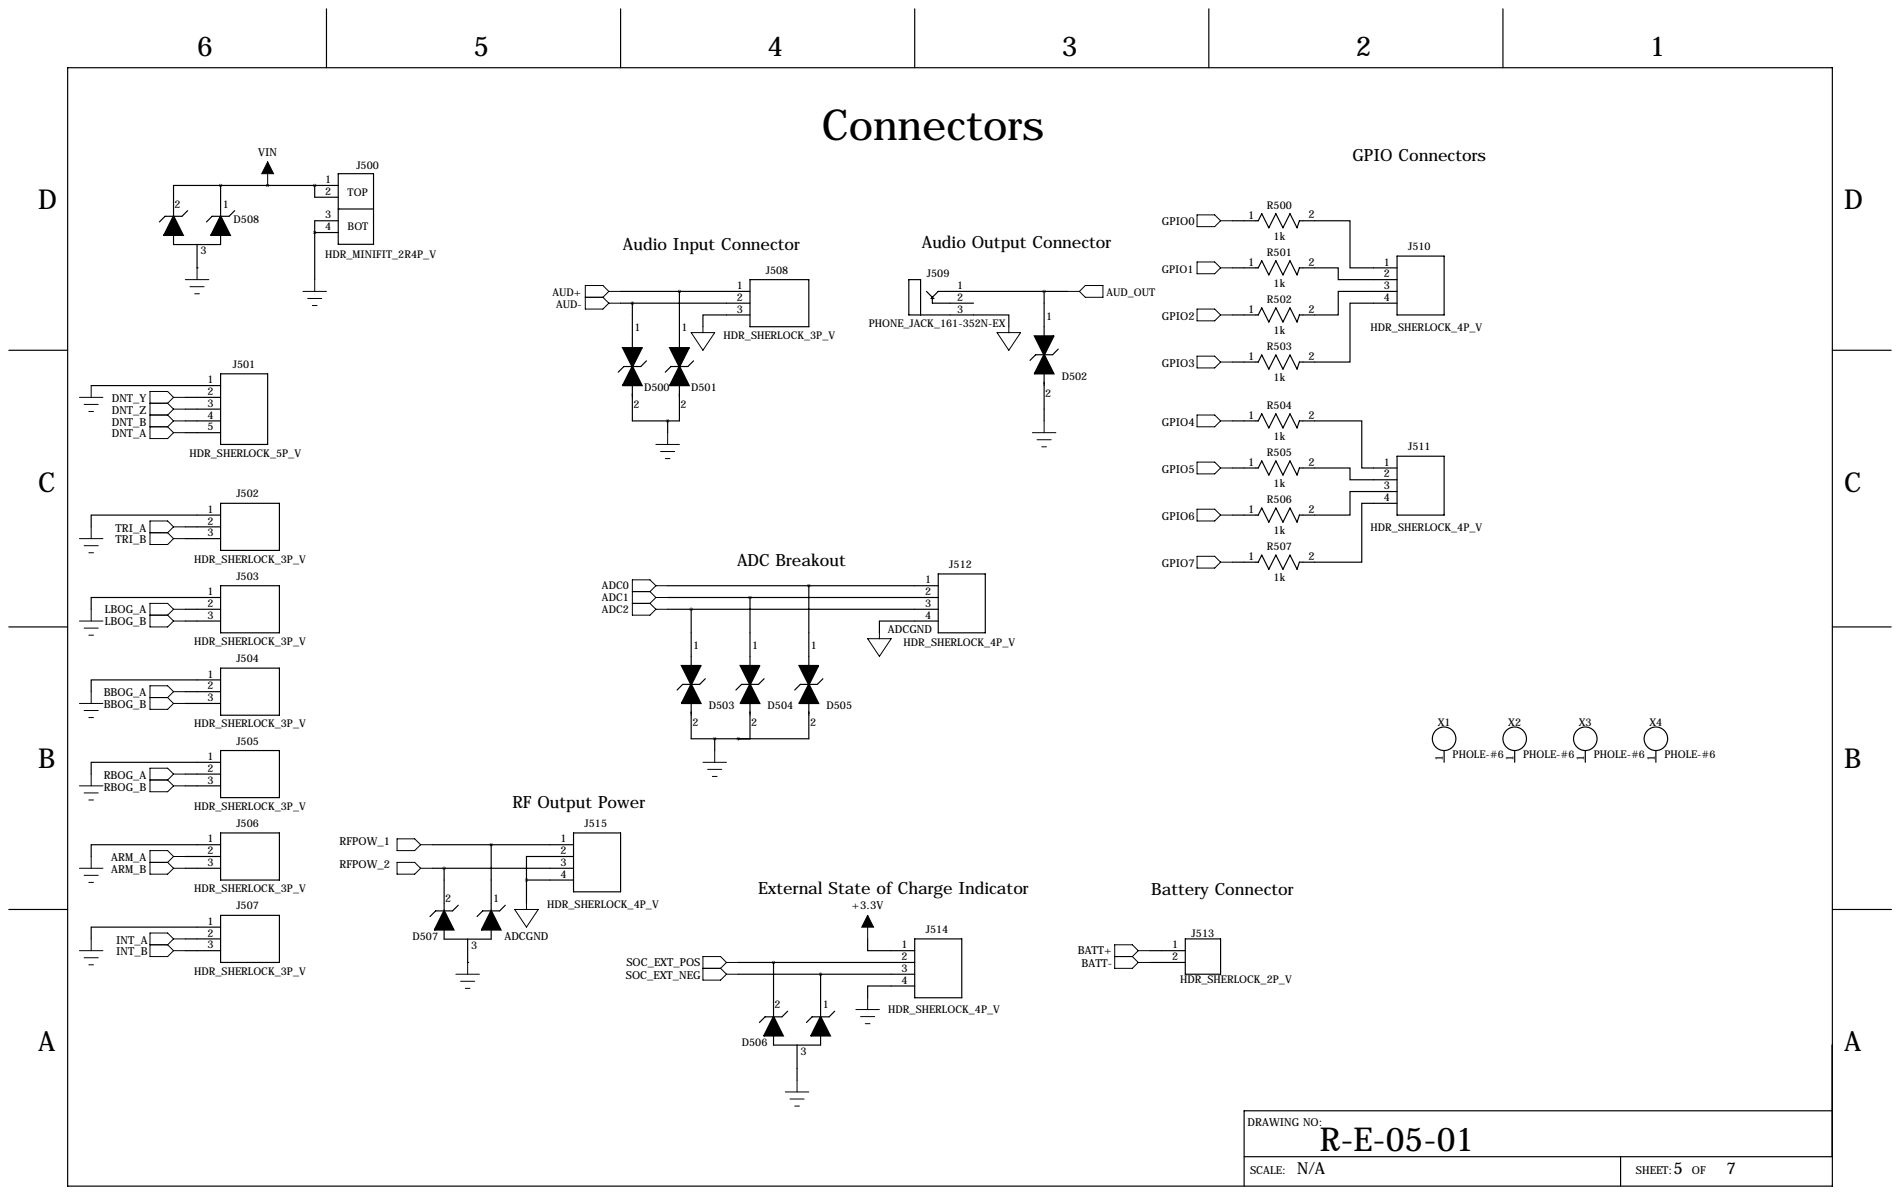
[picture p19: page 5]

External State of Charge Indicator

D

D

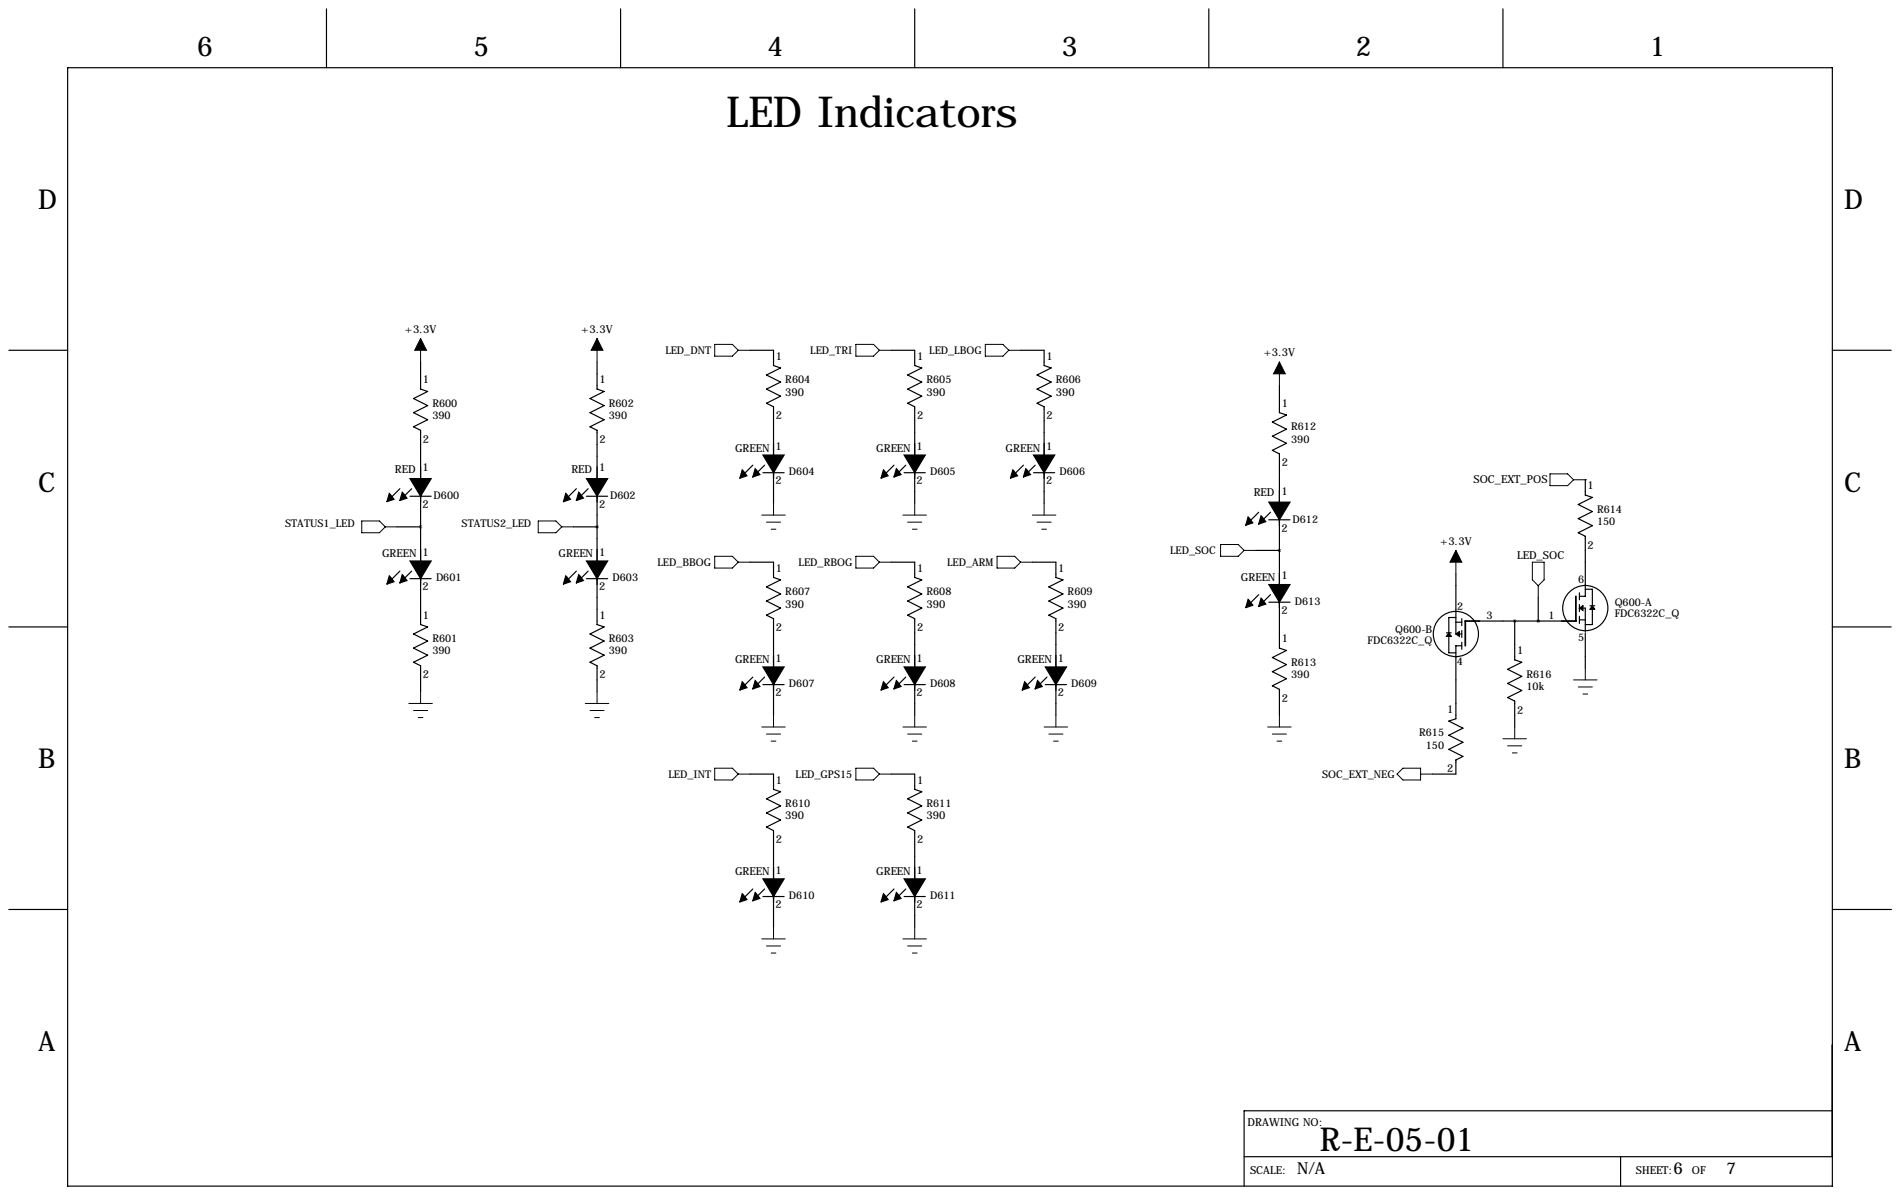
[picture p20: page 6]

D

D

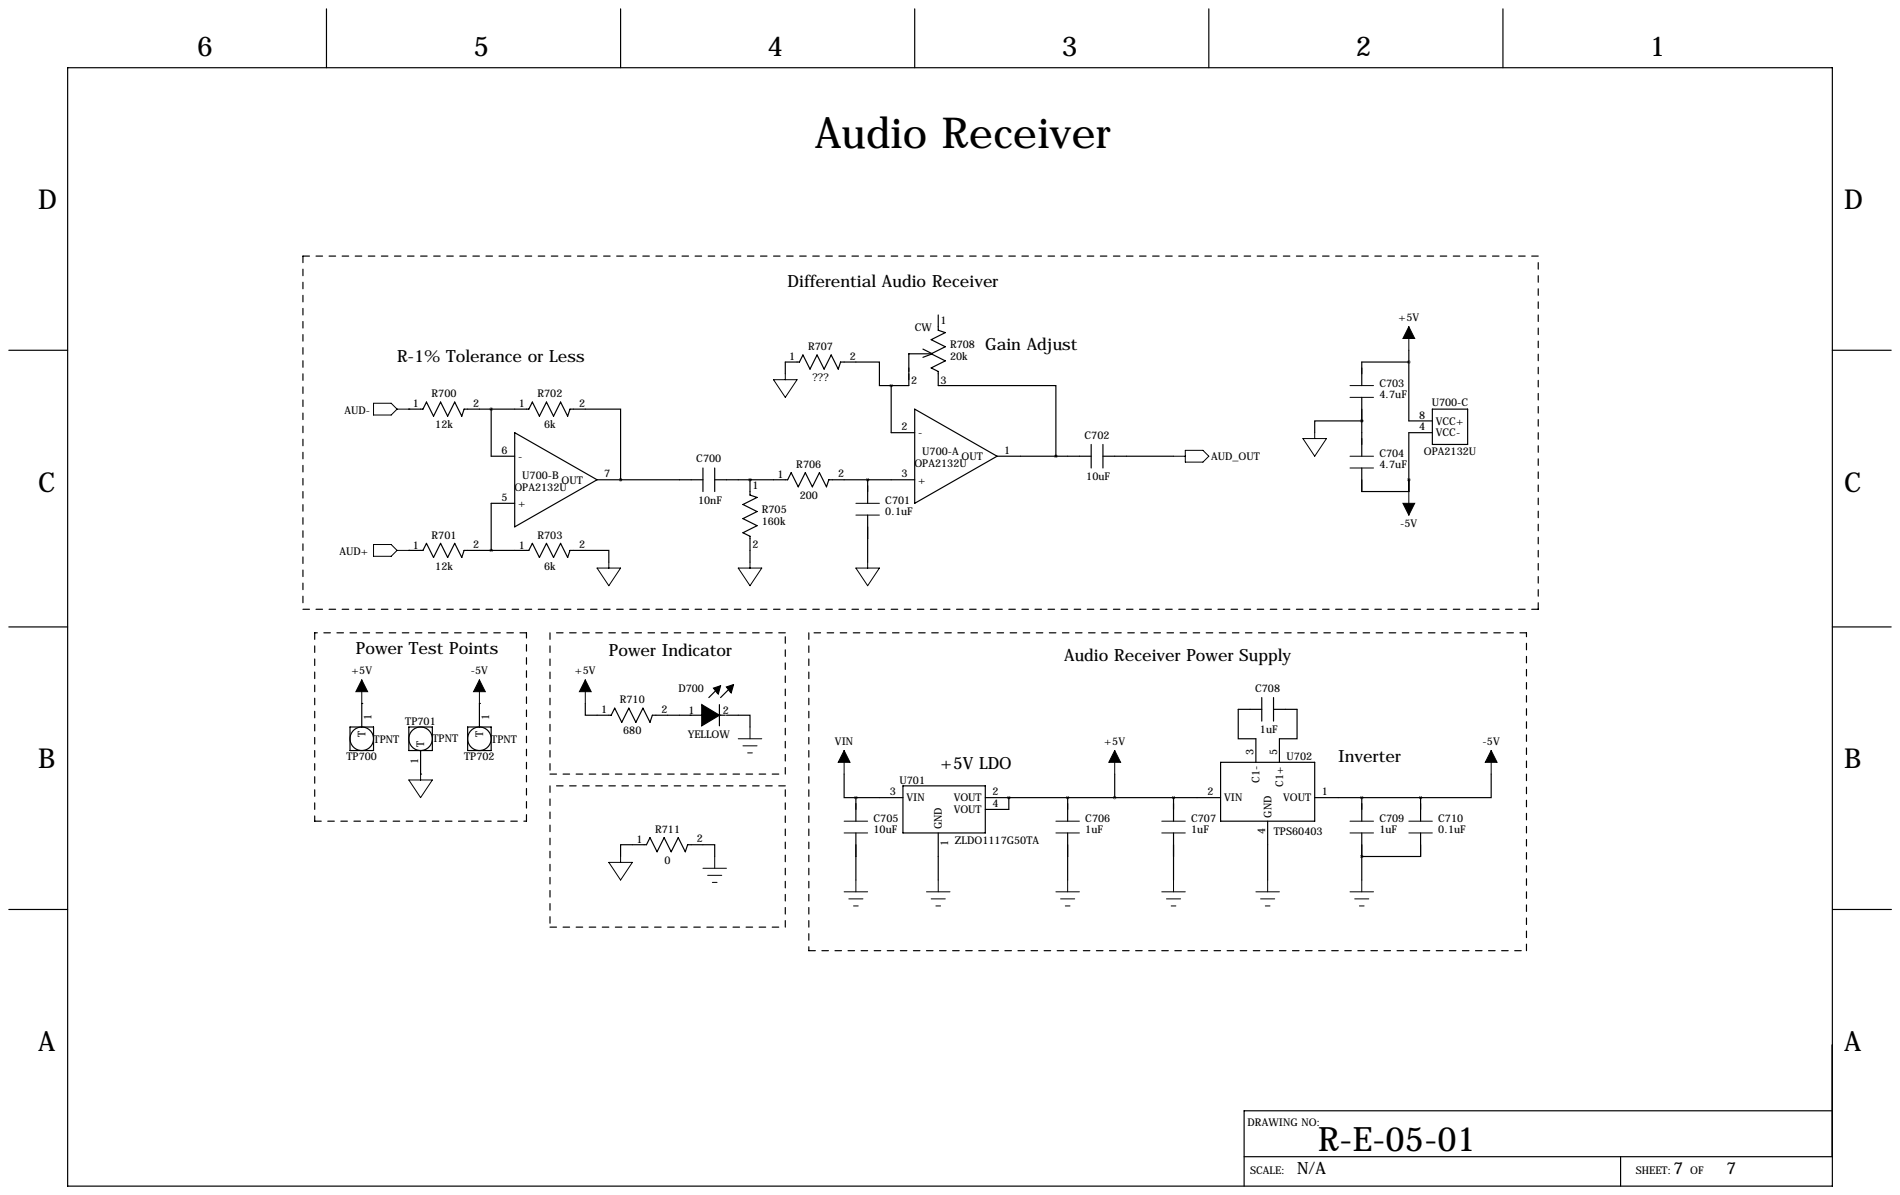
[picture p21: page 7]

Gain Adjust R-1% Tolerance or Less

Audio Receiver Power Supply
