OregonStateMarsRover/2011/Electrical/padsDrawings/R-E-04-01(2.4GHz_Amplifier)/2.4GHzAmp.pdf

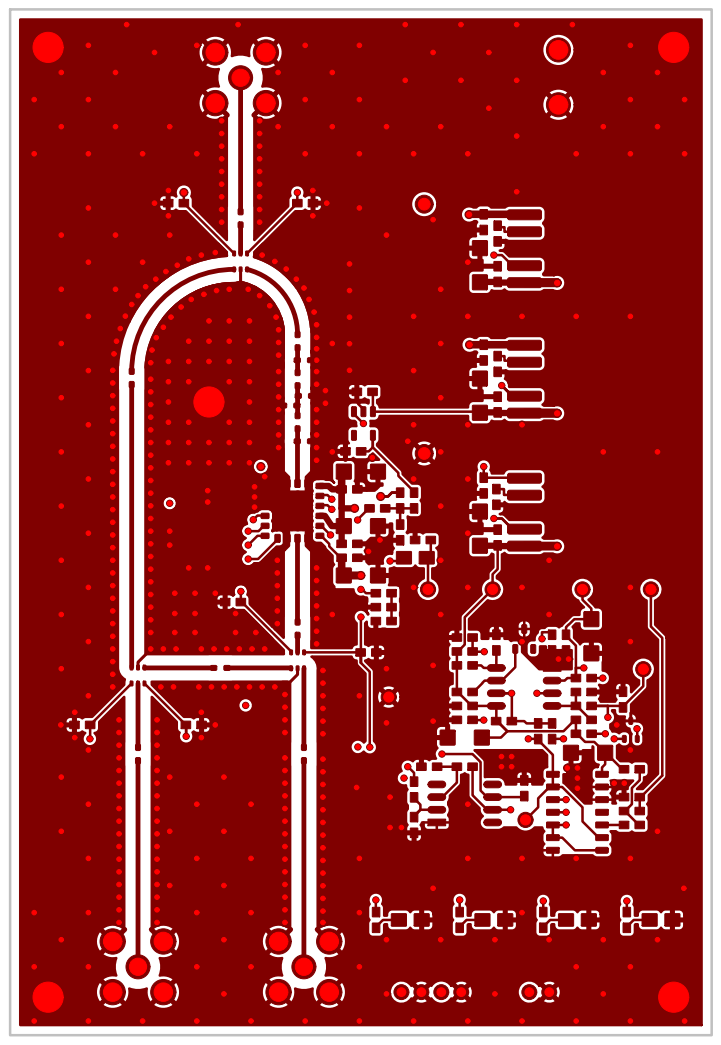
[picture p22: page 1]

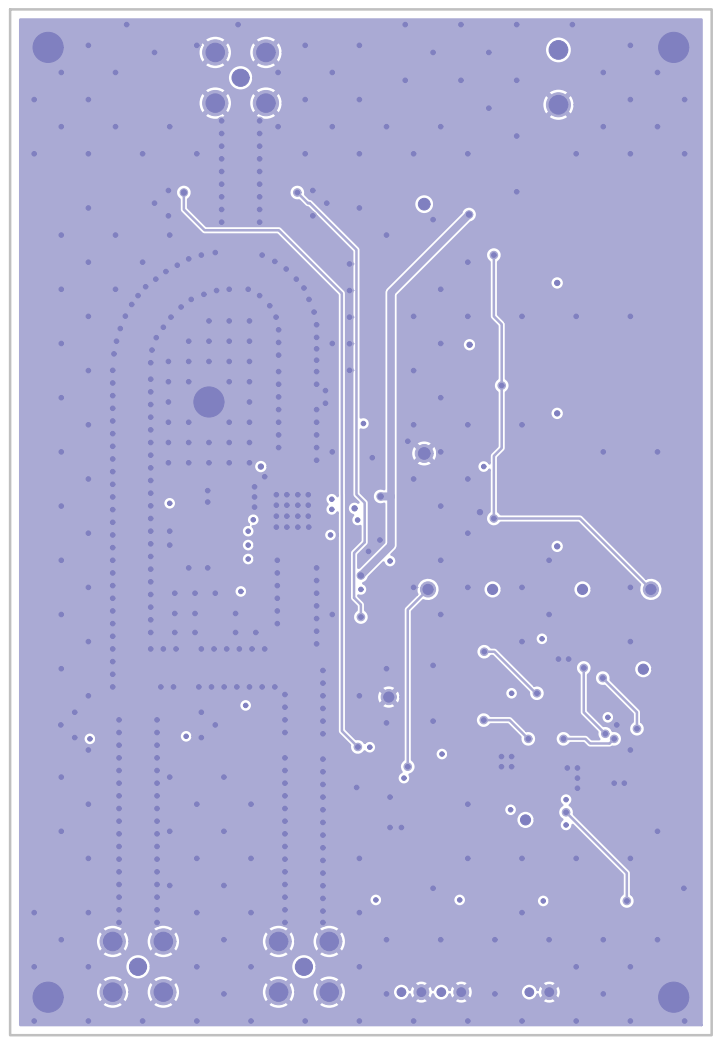
[picture p23: page 2]
X2X²x1; X3X³x1; X4X⁴x1; X5X⁵x1; C47C⁴⁷x1 C⁴⁷x2; U1 U¹x1 U¹x2 U¹x3

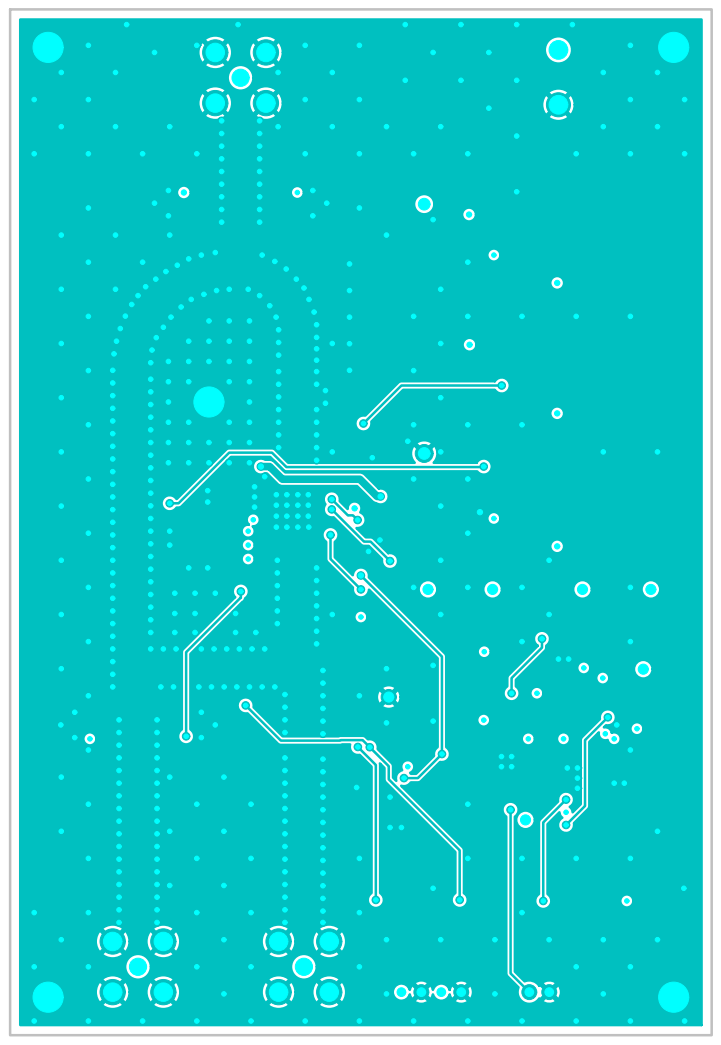
[picture p24: page 3]
X2X²x1; X3X³x1; X4X⁴x1; X5X⁵x1; C47C⁴⁷x1 C⁴⁷x2; U1 U¹x1 U¹x2 U¹x3

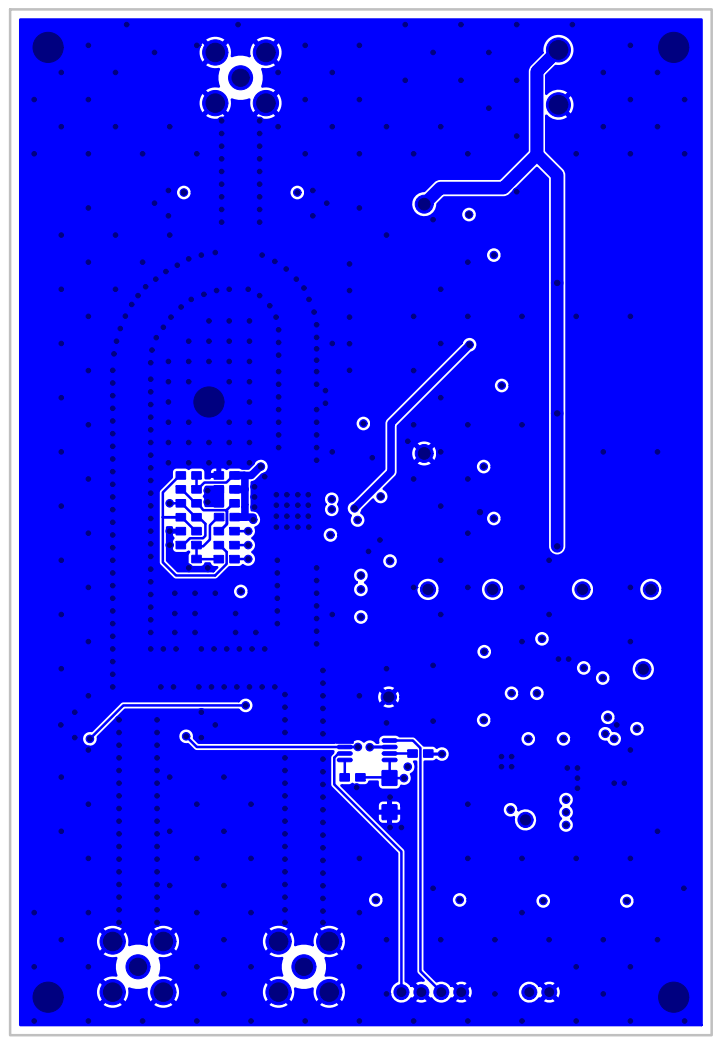
[picture p25: page 4]

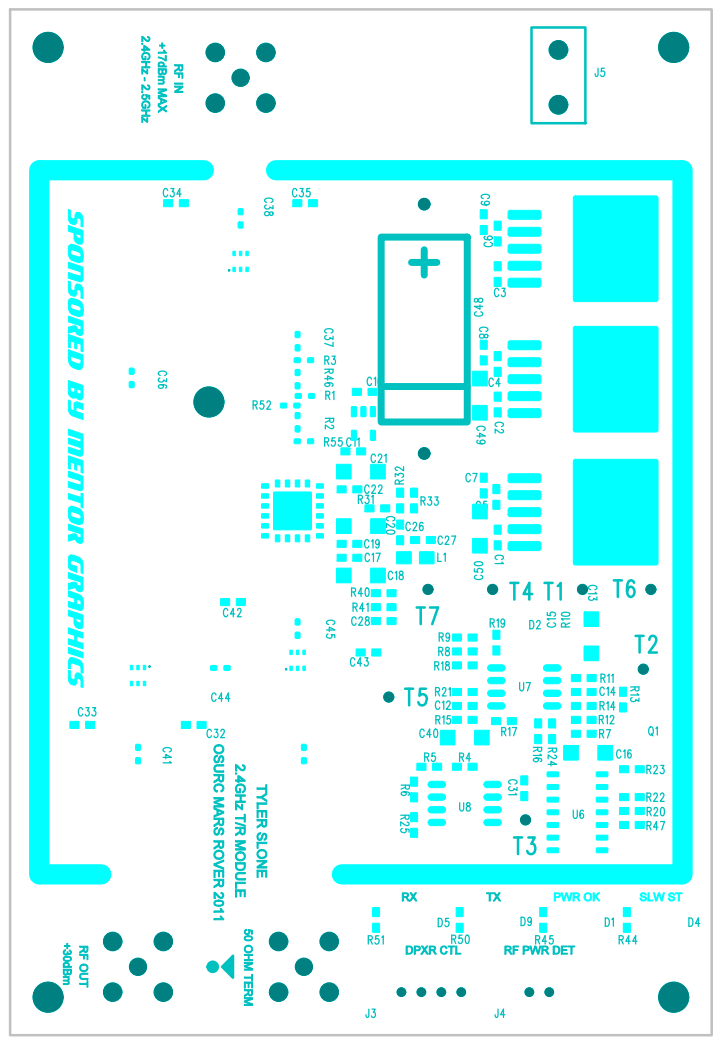
[picture p26: page 5]

Sponsored by Mentor Graphics
