OregonStateMarsRover/2011/Electrical/padsDrawings/Unassigned/ECE323Amp/ECE323AmpBRD.pdf

# R1R¹x1 R¹x2

# J1J1x1 J1x2

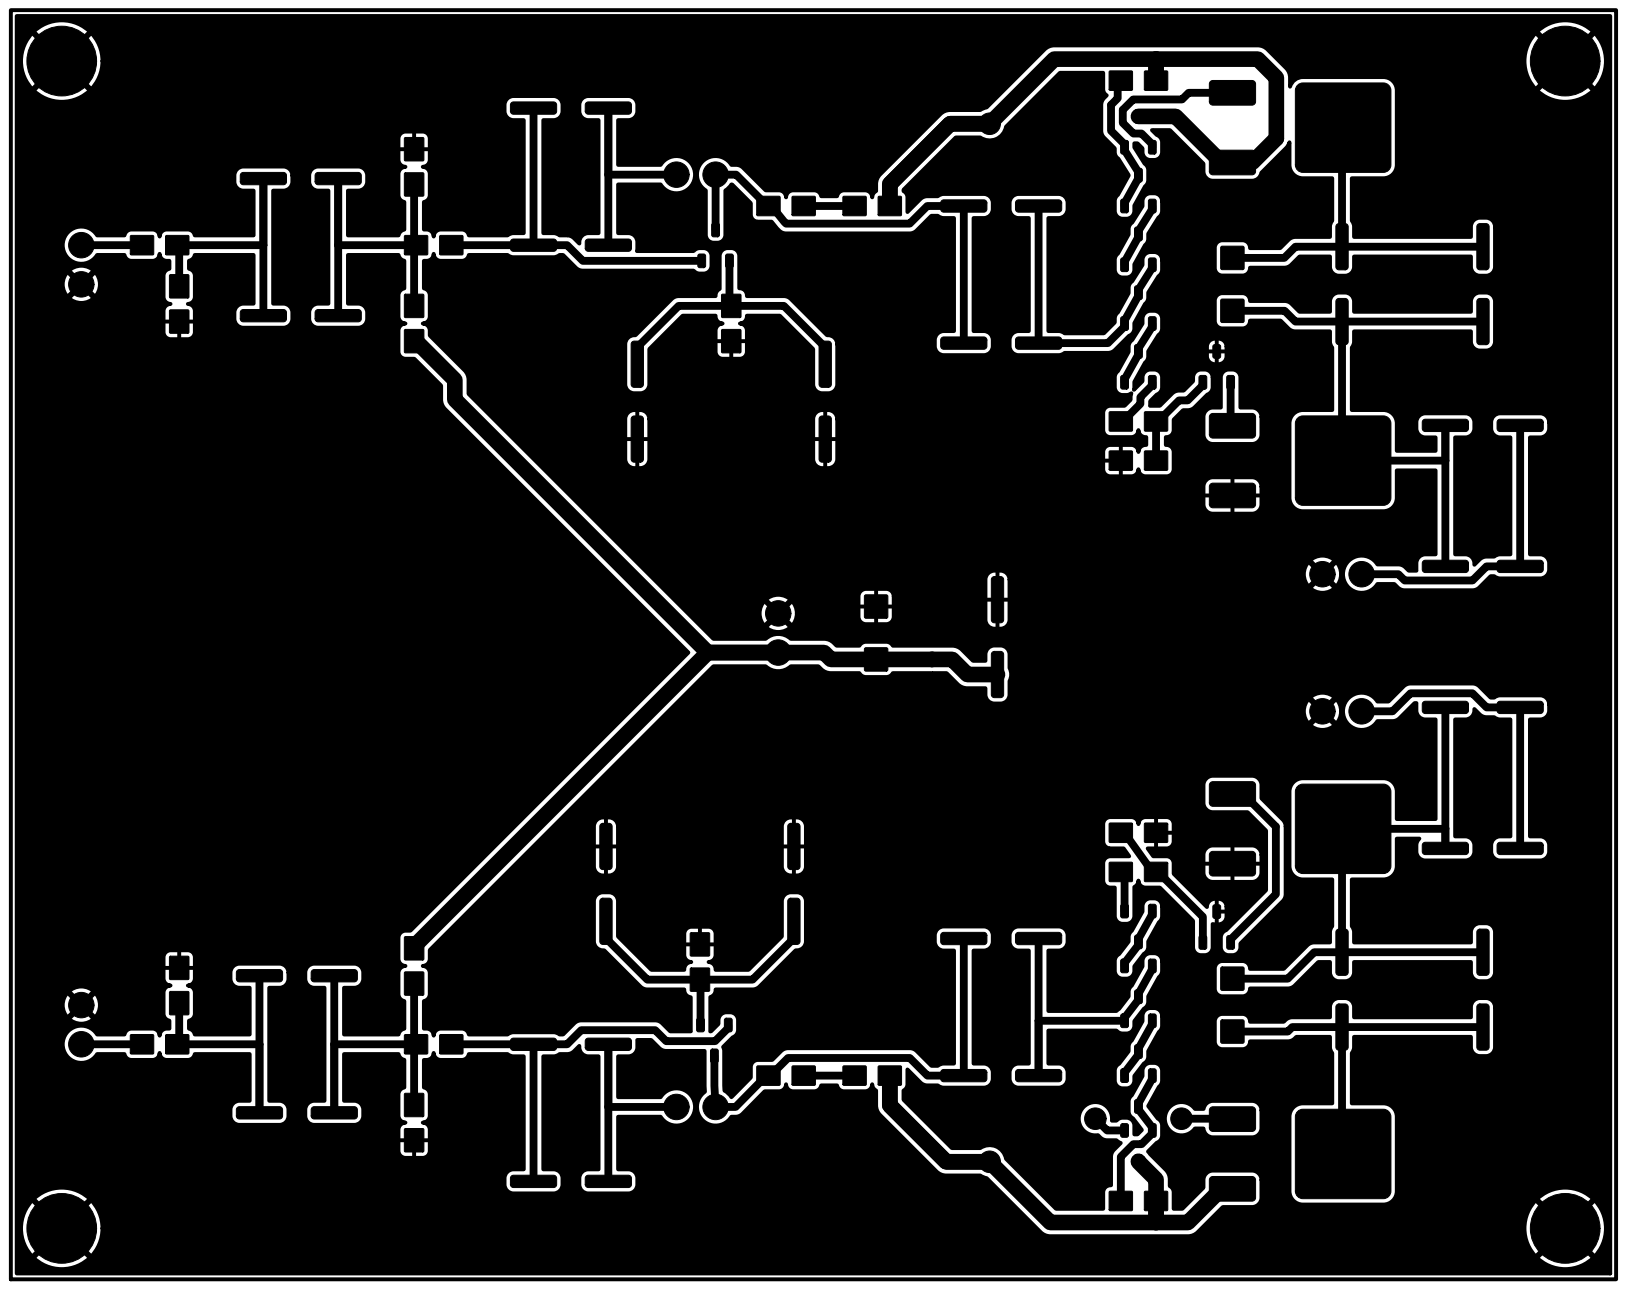
[picture p27: page 1]

# J1J1x1 J1x2

# J3J3x1 J3x2

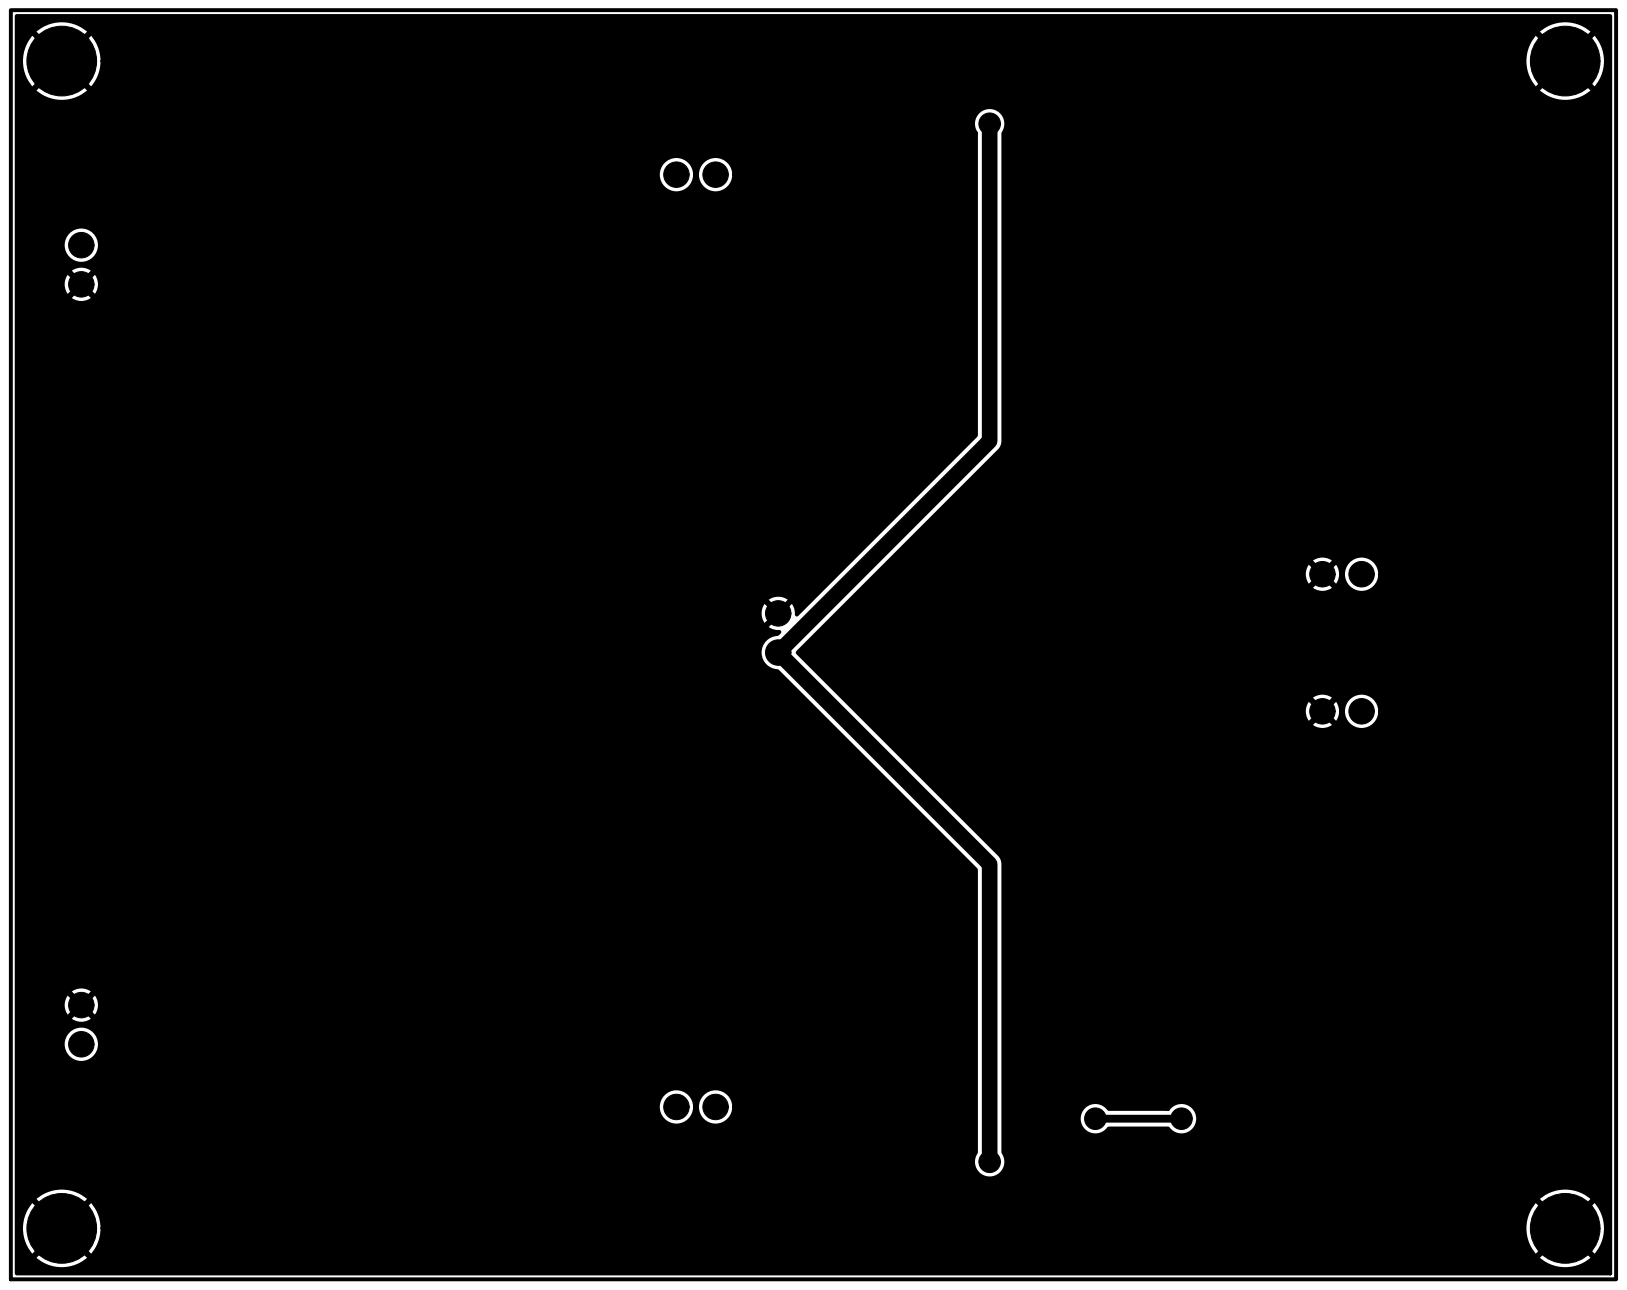
[picture p28: page 2]
X1X¹x1; X2X²x1; X4X⁴x1; X3X³x1
