OregonStateMarsRover/2011/Electrical/padsDrawings/Unassigned/ECE323Amp/ECE323AmpSCH.pdf

D

6 | 5 | 4 | 3 | 2 | 1

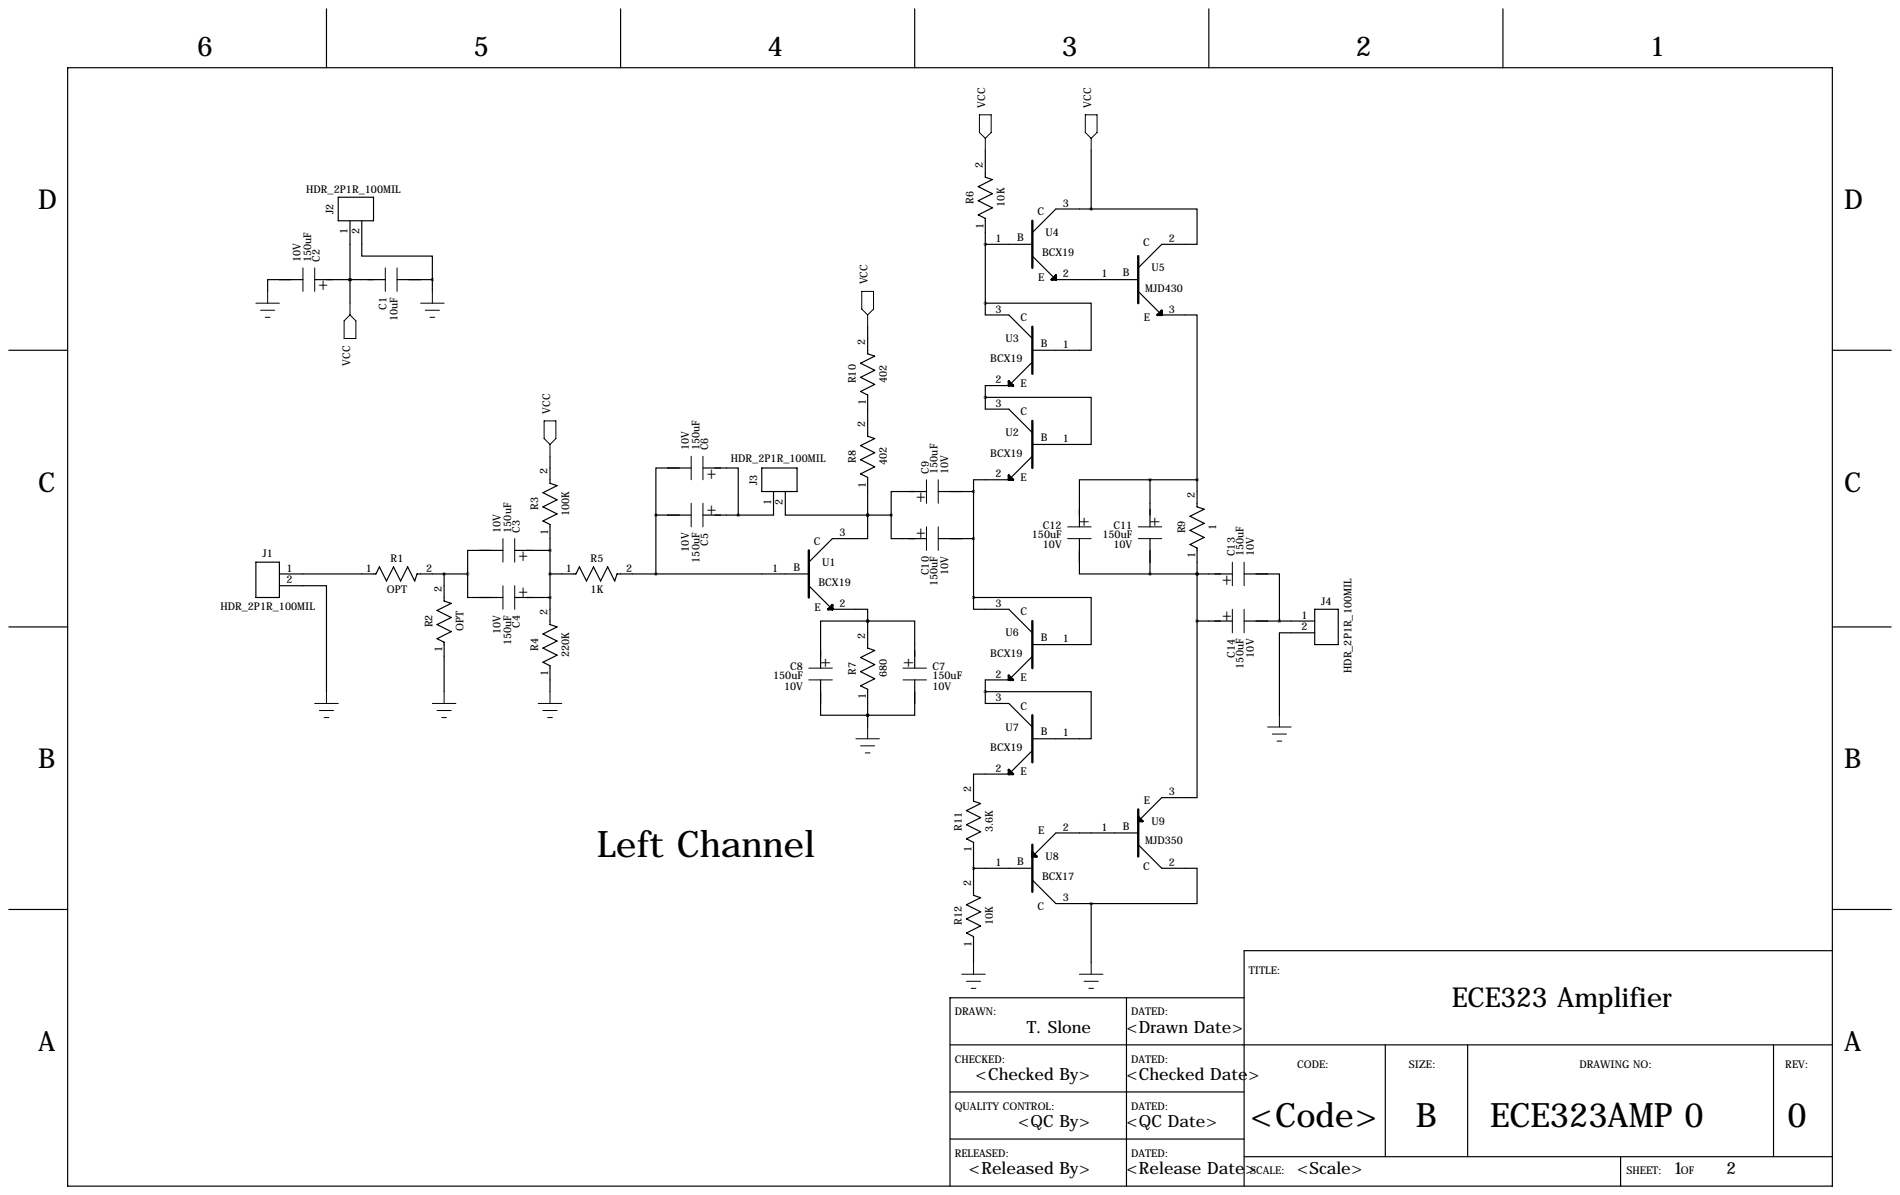
[picture p29: page 1]

TITLE: | ECE323 Amplifier

<Scale> SCALE: | 1 2 SHEET: OF

D

6 | 5 | 4 | 3 | 2 | 1

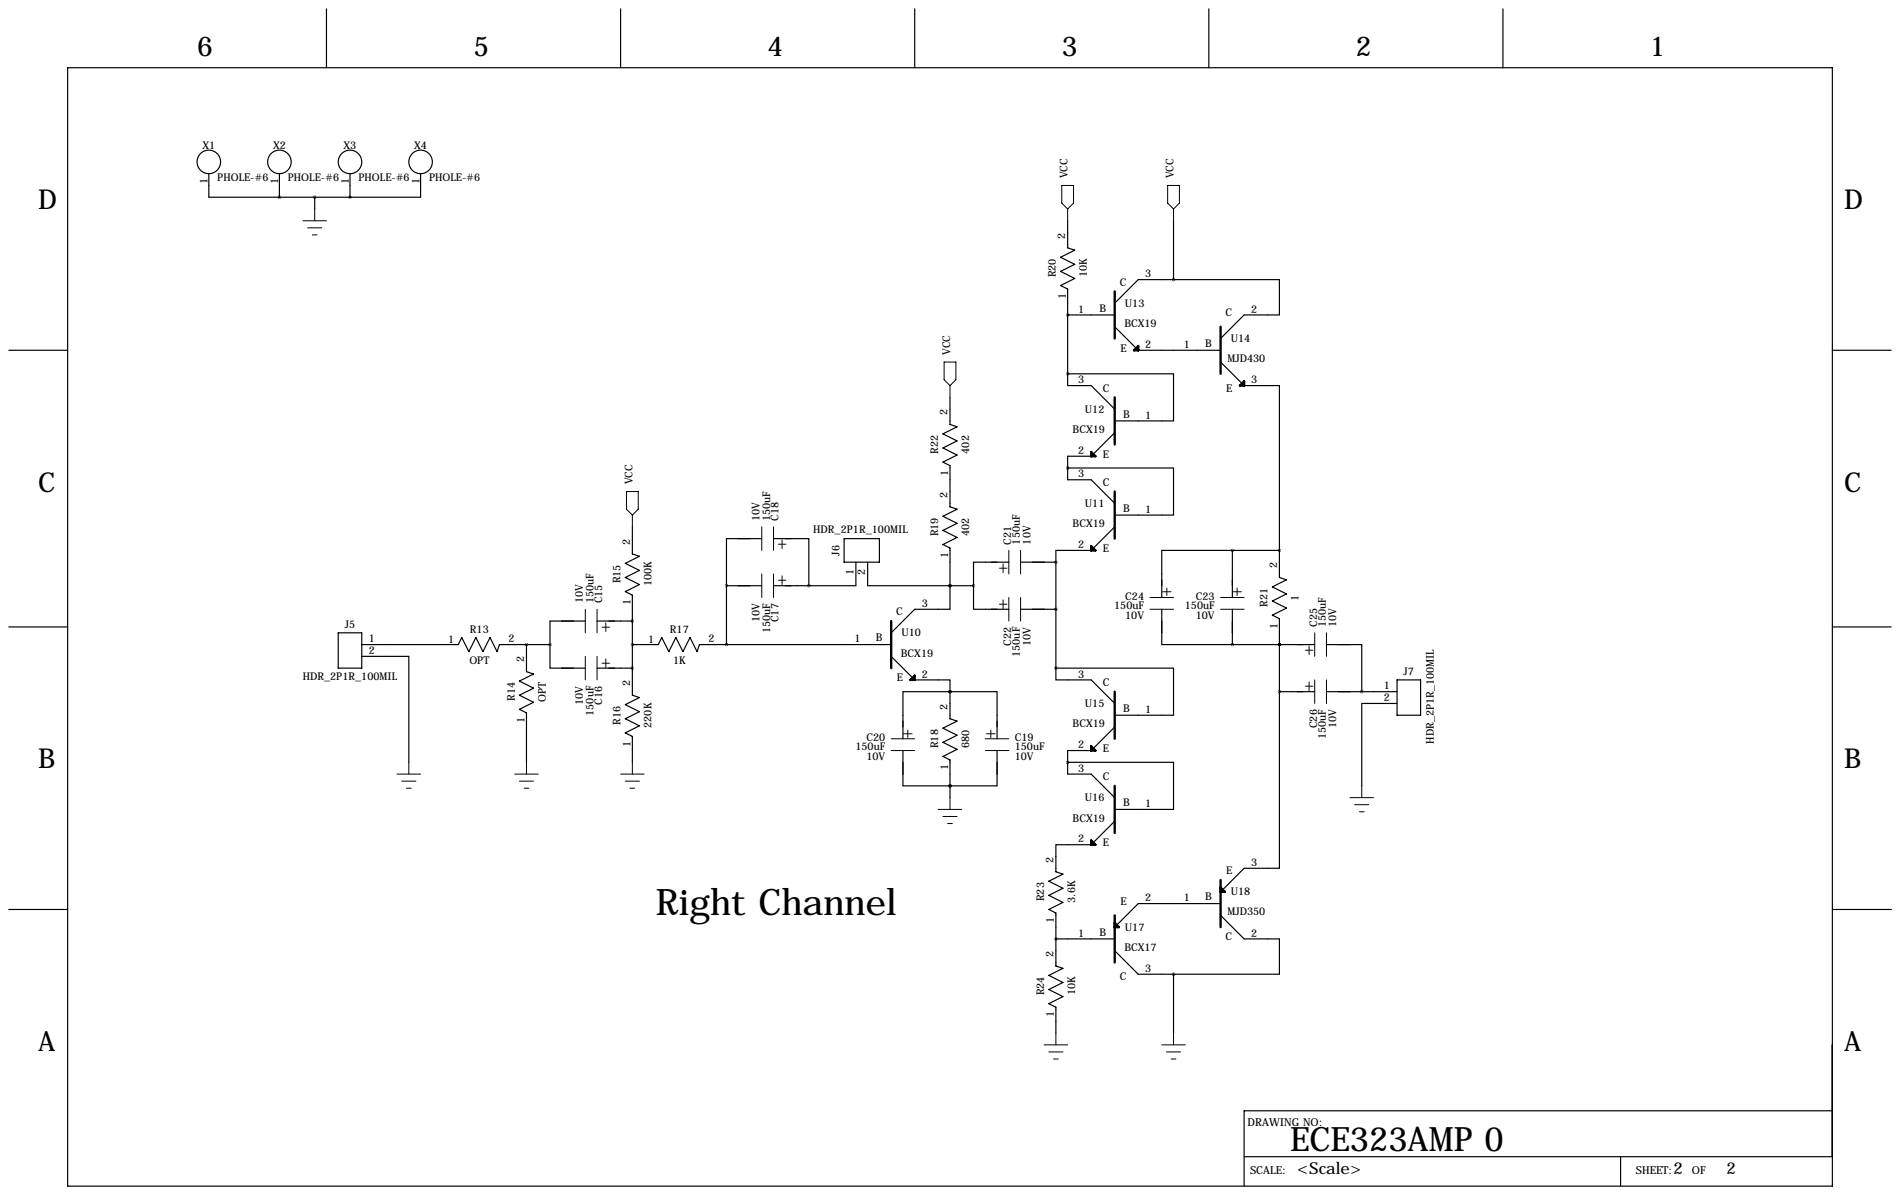
[picture p30: page 2]
