OregonStateMarsRover/2011/Electrical/simulations/PiAttenuator.asc

C1: cap; 1pF
C2: cap; 1pF
C3: cap; 1pF
L1: ind; .5nH
L2: ind; .5nH
L3: ind; .5nH
R1: res; 58.63
R2: res; 23.01
R3: res; 58.63
R4: res; 50
R5: res; 50
V1: signal; PULSE(0 2 0 10p 1n 3n 8n)
Named nets: 0
.tran 0 10nS 5nS
