OregonStateMarsRover/2011/Electrical/simulations/powerAssertion.asc

A1: and
C1: cap; 10µF
C2: cap; 0.22µF
C3: cap; 0.1µF
Q1: pnp; BC857C
R1: res; 500K
R2: res; 1mega
R3: res; 7K
R4: res; 10K
R5: res; 4.7K
R6: res; 4.7K
R7: res; 1K
R8: res; 4.7K
R9: res; 4.7K
R10: res; 1K
R14: res; 2K
R15: res; 100
U1: LT1017
U2: LT1017
V1: voltage; 5
V2: voltage; PULSE(0 8 1 1 5 20 0 2)
Named nets: 0, PWR
.tran 0 30 0
