OregonStateMarsRover/2011/Electrical/simulations/RFPowerAmpEnableDriver.asc

C1: cap; 24.6pF
Q1: npn; 2N4401
R1: res; 9K
R2: res; 1K
R3: res; 100
R4: res; 1K
R5: res; 83.3
U1: LT1001
V1: signal; PULSE(0 0.95 1n 350nS 1.3uS 1mS 100mS)
V2: voltage; 2.5
V3: voltage; 5V
Named nets: 0, TXEN, VREF, VCC
.tran 0 200ms 0 250uS
