OregonStateMarsRover/2011/Electrical/padsDrawings/Unassigned/323amp2.asc

C1: cap; 330µF
C2: cap; 330µF
C3: cap; 330µF
C4: cap; 330µF
C5: cap; 330µF
C6: cap; 330µF
Q1: npn; 2N4401
Q2: npn; 2N4401
Q3: pnp; 2N4403
Q4: npn; 2N4401
Q5: pnp; 2N4403
Q6: npn; 2N4401
Q7: npn; 2N4401
Q9: npn; 2N4401
Q10: npn; 2N4401
R1: res; 100K
R2: res; 220K
R3: res; 680
R4: res; 3.6K
R5: res; 1
R6: res; 1K
R7: res; 10K
R8: res; 804
R11: res; 10K
R12: res; 10K
R13: res; 4
V1: signal; SINE(0 .1 1K); AC 1
V2: voltage; 5V
Named nets: 0, VCC, IN
.tran 0 1.01 1
;ac dec 100 10 30K
