OregonStateMarsRover/2011/(list of files, drawings)

Other design files:
Electrical/padsDrawings/R-E-03-03(Power_Supply)/R-E-03-03_0A.pcb
Electrical/padsDrawings/R-E-03-03(Power_Supply)/R-E-03-03_REV1.pcb
Electrical/padsDrawings/R-E-03-03(Power_Supply)/R-E-03-03_REV1_02.pcb
Electrical/padsDrawings/R-E-03-03(Power_Supply)/R-E-03-03_REV1_03.pcb
Electrical/padsDrawings/R-E-03-03(Power_Supply)/R-E-05-01_03.pcb
Electrical/padsDrawings/R-E-03-03(Power_Supply)/R-E-05-01_03_R.pcb
Electrical/padsDrawings/R-E-03-06 (LED Board)/BatteryIndicatorBoard.pcb
Electrical/padsDrawings/R-E-04-02(DNT900_Interface)/Panel/R-E-04-02(DNT900_Interface)_Panel.pcb
Electrical/padsDrawings/R-E-04-02(DNT900_Interface)/R-E-04-02(DNT900_Interface).pcb
Electrical/padsDrawings/R-E-04-04 (Serial Adapter)/R-E-04-04_00.pcb
Electrical/padsDrawings/R-E-04-04 (Serial Adapter)/R-E-04-04_01.pcb
Electrical/padsDrawings/R-E-04-08 (USB_To_RS485_Module)/R-E-04-08_01.pcb
Electrical/padsDrawings/R-E-05-01(Main_Board)/Rev. 1/R-E-05-01_00 - Copy.pcb
Electrical/padsDrawings/R-E-05-01(Main_Board)/Rev. 1/R-E-05-01_00.pcb
Electrical/padsDrawings/R-E-05-01(Main_Board)/Rev. 1/R-E-05-01_00_backup.pcb
Electrical/padsDrawings/R-E-05-01(Main_Board)/Rev. 1/R-E-05-01_00_l2.pcb
Electrical/padsDrawings/R-E-05-01(Main_Board)/Rev. 1/R-E-05-01_00_OLD.pcb
Electrical/padsDrawings/R-E-05-01(Main_Board)/Rev. 2/R-E-05-01_02.pcb
Electrical/padsDrawings/R-E-05-01(Main_Board)/Rev. 3/R-E-05-01_04.pcb
Electrical/padsDrawings/R-E-05-01(Main_Board)/Rev. 4/R-E-05-01_04.pcb
Electrical/padsDrawings/R-E-05-01(Main_Board)/Solidworks/R-E-05-01_02-MECH.pcb
Electrical/padsDrawings/R-E-05-01(Main_Board)/Solidworks/R-E-05-01_02_BACKUP.pcb
Electrical/padsDrawings/R-E-05-02(Analog Interface)/R-E-05-02_01.pcb
Electrical/padsDrawings/R-E-06-01(Tripod_Control_Board)/Tripod_Control_Board.pcb
Electrical/padsDrawings/R-E-06-02(Tripod_Sensor_Board)/Rev. 3/R-E-06-02_03.pcb
Electrical/padsDrawings/R-E-06-02(Tripod_Sensor_Board)/Rev. 4/R-E-06-02_04.pcb
Electrical/padsDrawings/R-E-06-02(Tripod_Sensor_Board)/Rev. 5/R-E-06-02_05.pcb
Electrical/padsDrawings/T-E-01-01(Test_Fixture_Control_Board)/Rev1/T-E-01-01_REV1.pcb
Electrical/padsDrawings/T-E-01-01(Test_Fixture_Control_Board)/Rev1/T-E-01-01_REV1_2.pcb
Electrical/padsDrawings/T-E-01-01(Test_Fixture_Control_Board)/Rev1/T-E-01-01_REV2.pcb
Electrical/padsDrawings/T-E-01-02 (ATMega Serial Module)/T-E-01-02_01.pcb
Electrical/padsDrawings/Unassigned/ECE323Amp/ECE323Amp.pcb
