OregonStateMarsRover/2011/Software/Modules/MotorBogie/keep/BogieController.c

/*BogieController.c
 *Authors: Mike Fortner, Chris Newman
 */

#include "BogieController.h"


//global vars
USART USART_motor;
USART USART_mainboard;

uint8_t desired_speed = 0;
uint8_t desired_angle = 0;

PIDobject act_pid;

#define AVR_ENTER_CRITICAL_REGION( ) uint8_t volatile saved_sreg = SREG; \
                                     cli();

#define AVR_LEAVE_CRITICAL_REGION( ) SREG = saved_sreg;

void CCPWrite( volatile uint8_t * address, uint8_t value )
{
#if defined __GNUC__
	AVR_ENTER_CRITICAL_REGION( );
	volatile uint8_t * tmpAddr = address;
#ifdef RAMPZ
	RAMPZ = 0;
#endif
	asm volatile(
		"movw r30,  %0"	      "\n\t"
		"ldi  r16,  %2"	      "\n\t"
		"out   %3, r16"	      "\n\t"
		"st     Z,  %1"       "\n\t"
		:
		: "r" (tmpAddr), "r" (value), "M" (CCP_IOREG_gc), "i" (&CCP)
		: "r16", "r30", "r31"
		);

	AVR_LEAVE_CRITICAL_REGION( );
#endif
}

void bogie_controller_init(void)
{
	USART_InitPortStructs();
	
	/***set I/O port directions***/
	PORTA.DIR = 0x00;
	PORTB.DIR = 0x00;
	PORTC.DIR = PIN1_bm | PIN3_bm;
	PORTD.DIR = PIN1_bm | PIN2_bm | PIN3_bm | PIN4_bm | PIN5_bm;

	/***Motor Driver USART init***/
		
	
	USART_Open(&bogie_controller.motor_port, 2, USART_BAUD_9600, 10, 10, false, false);

	//enable DRE interrupt with low priority
// 	USART_InterruptDriver_Initialize(&USART_motor, &USARTD0, USART_DREINTLVL_LO_gc); 
// 
// 	/* 8 Data bits, No Parity, 1 Stop bit. */
// 	USART_Format_Set(USART_motor.usart, USART_CHSIZE_8BIT_gc,
//                      USART_PMODE_DISABLED_gc, false);
// 
// 	/* Set Baudrate to 9600 bps:
// 	 * Use the default I/O clock frequency that is 2 MHz.
// 	 * Do not use the baudrate scale factor
// 	 *
// 	 * Baudrate select = (1/(16*(((I/O clock frequency)/Baudrate)-1)
// 	 *                 = 12
// 	 */
// 	USART_Baudrate_Set(&USARTD0, 12 , 0);
// 
// 	/* Enable TX. */
// 	USART_Tx_Enable(USART_motor.usart);

	/***Mainboard USART init***/
	USART_Open(&bogie_controller.mainboard_port, 0, USART_BAUD_38400, 10, 10, false, true);
	CommInterfaceInit(&bogie_controller.mainboard_inf, &bogie_controller.mainboard_port);
	
	PacketQueueInit2(&bogie_controller.pktQueue, 6, 20, bogie_controller.queuedPackets, bogie_controller.queuedData);
// 	USART_InterruptDriver_Initialize(&USART_mainboard, &USARTC0, USART_DREINTLVL_LO_gc); 
// 
// 	/* 8 Data bits, No Parity, 1 Stop bit. */
// 	USART_Format_Set(USART_mainboard.usart, USART_CHSIZE_8BIT_gc,
//                      USART_PMODE_DISABLED_gc, false);
// 					 
// 	/* Enable RXC interrupt. */
// 	USART_RxdInterruptLevel_Set(USART_mainboard.usart, USART_RXCINTLVL_LO_gc);
// 
// 	/* Set Baudrate to 9600 bps:
// 	 * Use the default I/O clock frequency that is 2 MHz.
// 	 * Do not use the baudrate scale factor
// 	 *
// 	 * Baudrate select = (1/(16*(((I/O clock frequency)/Baudrate)-1)
// 	 *                 = 12
// 	 */
// 	USART_Baudrate_Set(&USARTC0, 12 , 0);
// 
// 	/* Enable RX and TX. */
// 	USART_Rx_Enable(USART_mainboard.usart);
// 	USART_Tx_Enable(USART_mainboard.usart	
	/*** Global Interrupt init***/	

	/* Enable PMIC interrupt level low. */
	PMIC.CTRL |= PMIC_LOLVLEX_bm;

	/* Enable global interrupts. */

	
	
	/*** Initialize Sabertooth Motor Driver ***/
	
	sabertooth_init(&bogie_controller.motor_port);
	
	/*** Initialize Quadrature Decoder for Actuator encoder***/
	
	QDEC_Total_Setup(&PORTC,                    /*PORT_t * qPort*/
	                 6,                         /*uint8_t qPin*/
	                 false,                     /*bool invIO*/
	                 0,                         /*uint8_t qEvMux*/
	                 EVSYS_CHMUX_PORTC_PIN6_gc, /*EVSYS_CHMUX_t qPinInput*/
	                 false,                     /*bool useIndex*/
	                 EVSYS_QDIRM_00_gc,         /*EVSYS_QDIRM_t qIndexState*/
	                 &TCC0,                     /*TC0_t * qTimer*/
	                 TC_EVSEL_CH0_gc,           /*TC_EVSEL_t qEventChannel*/
	                 ACTUATOR_QUADRATURE_LINECOUNT);   /*uint8_t lineCount*/
	
	/*** Initialize Counter for Drive encoder***/
	
	PORTC.DIRCLR = PIN4_bm;				  //set PC4/Pin 14 to input
	PORTC.PIN4CTRL |= PORT_ISC_RISING_gc;  //set PC4/Pin 14 to trigger events on rising edges
	
	EVSYS.CH2MUX = EVSYS_CHMUX_PORTC_PIN4_gc;  //set PC4/Pin 14 to input for event channel 2
	
	TC1_t *motor_counter = &TCC1;
	TC1_ConfigClockSource( motor_counter, TC_CLKSEL_EVCH2_gc );  //set TCC1 to count events on channel 2
	
	/*** Initialize Timer for PID loop***/
		

	TC0_t *loop_timer = &TCD0;
	TC_SetPeriod( loop_timer, 195U); //set period to (2000000/1024)(ticks/sec)/10(loops/sec) = 195 ticks/loop
	TC0_ConfigClockSource( loop_timer,  TC_CLKSEL_DIV1024_gc);  //set TCD0 to count the system clock. frequency should be 2,000,000 ticks/sec
	TC0_SetOverflowIntLevel( loop_timer, TC_OVFINTLVL_LO_gc);  //set TCD0 to trigger an interrupt when every overflow (100ms)


	/*** initialize min and max for actuator encoder ***/
	
	sei();
}


ISR(TCD0_OVF_vect)
{
// 	PORTD.OUTTGL = 0b00110000;
// 	drive_set(desired_speed); 
// 	actuator_set(pid(&act_pid, desired_angle, get_actuator_pos()));
}

void parse_command(CommPacket *pkt)
{
	drive_set((int8_t)(pkt->data[0]));
}

void reply(CommPacket *pkt) {
	CommPacket respPkt;
	respPkt.target = 2;
	respPkt.length = 2;
	char data[2];
	data[0] = 'B';
	data[1] = 'O';
	respPkt.data = data;

	CommSendPacket(&bogie_controller.mainboard_inf, &respPkt);
}



void ChangeClockFreq() {
	uint8_t clkCtrl;
	//LedOff(LED_INT);
	CCPWrite( &OSC.XOSCFAIL, ( OSC_XOSCFDIF_bm | OSC_XOSCFDEN_bm ) );
	char failed = 0;
	
	do
	{
		failed = 0;
		
		OSC.XOSCCTRL = (uint8_t) OSC_FRQRANGE_12TO16_gc | 0b00001011;
		OSC.CTRL |= OSC_XOSCEN_bm;
		while ( (OSC.STATUS & OSC_XOSCRDY_bm) == 0 && failed==0) // wait for clock to stabilize
		{
			if (OSC.XOSCFAIL & OSC_XOSCFDIF_bm)
			{
				OSC.XOSCFAIL |= OSC_XOSCFDIF_bm;
				failed = 1;
			}
		}
	}
	while (failed);
	
	clkCtrl = ( CLK.CTRL & ~CLK_SCLKSEL_gm ) | CLK_SCLKSEL_XOSC_gc;
	CCPWrite( &CLK.CTRL, clkCtrl );
}	

int main(void)
{
	ChangeClockFreq();

	bogie_controller_init();
	PORTD.OUTSET = 0b00010000;
	PORTC.OUTSET = PIN1_bm;

	act_pid.p= 1;
	while(1)
	{
		uint8_t i = 0;
		//wait for communication
		if(CommRXPacketsAvailable(&bogie_controller.mainboard_inf))
		{	
			CommPacket pkt;
			char data[10];
			pkt.data=data;
			CommGetPacket(&bogie_controller.mainboard_inf, &pkt, 10);
			parse_command(&pkt);
			reply(&pkt);
		}
		//test code that toggles LEDs at 10hz and shifts between 0 and 100 forward speed on motor 1 
		_delay_us(100000);
		PORTD.OUTTGL = 0b00110000;
		drive_set(100*(i / 100));
		i++;
		if (i > 200) i = 0;
	}
}
