OregonStateMarsRover/2011/Software/Interface/UIMockups/VideoFeed/VideoFeed.cpp

#ifndef VIDEOFEED_CPP
#define VIDEOFEED_CPP

#include <QtGui/QWidget>

class Widget : public QWidget
{
    Q_OBJECT

public:
    Widget(QWidget *parent = 0);
    ~Widget();
};

#endif // VIDEOFEED_CPP
