OregonStateMarsRover/2011/Software/Interface/GUI/IntersectionLineItem.cpp

#include "IntersectionLineItem.h"

IntersectionLineItem::IntersectionLineItem(QGraphicsItem * parent) : QGraphicsLineItem(parent)
{
}

IntersectionLineItem::IntersectionLineItem(QLineF &line, QGraphicsItem *parent) : QGraphicsLineItem(parent) {

}

IntersectionLineItem::~IntersectionLineItem() {

}
