OregonStateMarsRover/2011/Software/Interface/GUI/ScienceSite.cpp

/*
 * ScienceSite.cpp
 *
 * Created by Camden Lopez on 11/26/10
 * Copyright © 2010-2011 Oregon State University Robotics Club */

#include "ScienceSite.h"

ScienceSite::ScienceSite(const QString & name, const QString & path, QObject *parent) : QObject(parent)
{
}
