OregonStateMarsRover/2011/Software/Interface/GUI/ScienceSite.h

/*
 * ScienceSite.h
 *
 * Responsible for files and data associated with
 * a site of interest for the sample return task.
 *
 * Created by Camden Lopez on 11/26/10
 * Copyright © 2010-2011 Oregon State University Robotics Club */

#ifndef SCIENCESITE_H
#define SCIENCESITE_H

#include <QObject>

class ScienceSite : public QObject
{
    Q_OBJECT
	
public:
	ScienceSite(const QString & name, const QString & path, QObject *parent = 0);
};

#endif // SCIENCESITE_H
