OregonStateMarsRover/2011/Software/Interface/GUI/ScienceWidget.h

/*
 * ScienceWidget.h
 *
 * Provides workspace for the sample return task, including capture/review
 * of images, note-taking, and records of sensor readings.
 *
 * Created by Camden Lopez on 11/10/10
 * Copyright © 2010-2011 Oregon State University Robotics Club */

#ifndef SCIENCEWIDGET_H
#define SCIENCEWIDGET_H

#include "ui_ScienceWidget.h"

class ScienceWidget : public QWidget, private Ui::ScienceWidget
{
    Q_OBJECT

public:
    explicit ScienceWidget(QWidget *parent = 0);
};

#endif // SCIENCEWIDGET_H
