OregonStateMarsRover/2011/Software/Interface/GUI/VideoWidget.cpp

/*
 * VideoWidget.cpp
 *
 * Created by Camden Lopez on 11/14/10
 * Copyright © 2010 Oregon State University Robotics Club
 */

#include "VideoWidget.h"

VideoWidget::VideoWidget(QWidget *parent) : QWidget(parent)
{
    setupUi(this);
}
