OregonStateMarsRover/2011/(commit log)

2011-11-01 upload last years code
    [2.4GHzAmp.sch, BOM_R-E-05-01_02.xls, BatteryIndicatorBoard.pcb, BatteryIndicatorBoard.sch, BillOfMaterials.csv, Configuration.h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]
2012-01-26 I have created the first draft widgets for Rover Controls, Arm Controls, Pan/Tilt Controls and Drive Modes
2012-04-21 * LEDController.h: Update to use new LED pins. * main.c: Comment out unneeded code. * Makefile[s]: Update to use new XMEGA.
2012-04-29 MotorController.c update, this deals with 2 loops, one for packaging info into separate wheel messages, and one for sending those messages. Also make sure that the sending is sending message IDs
2012-05-01 small changes to MotorController
2012-05-01 motorController updated - untested
